DTUOpenAM/OpenVPP/CAD/Exploded_view/Outline structure.exploded.PNG

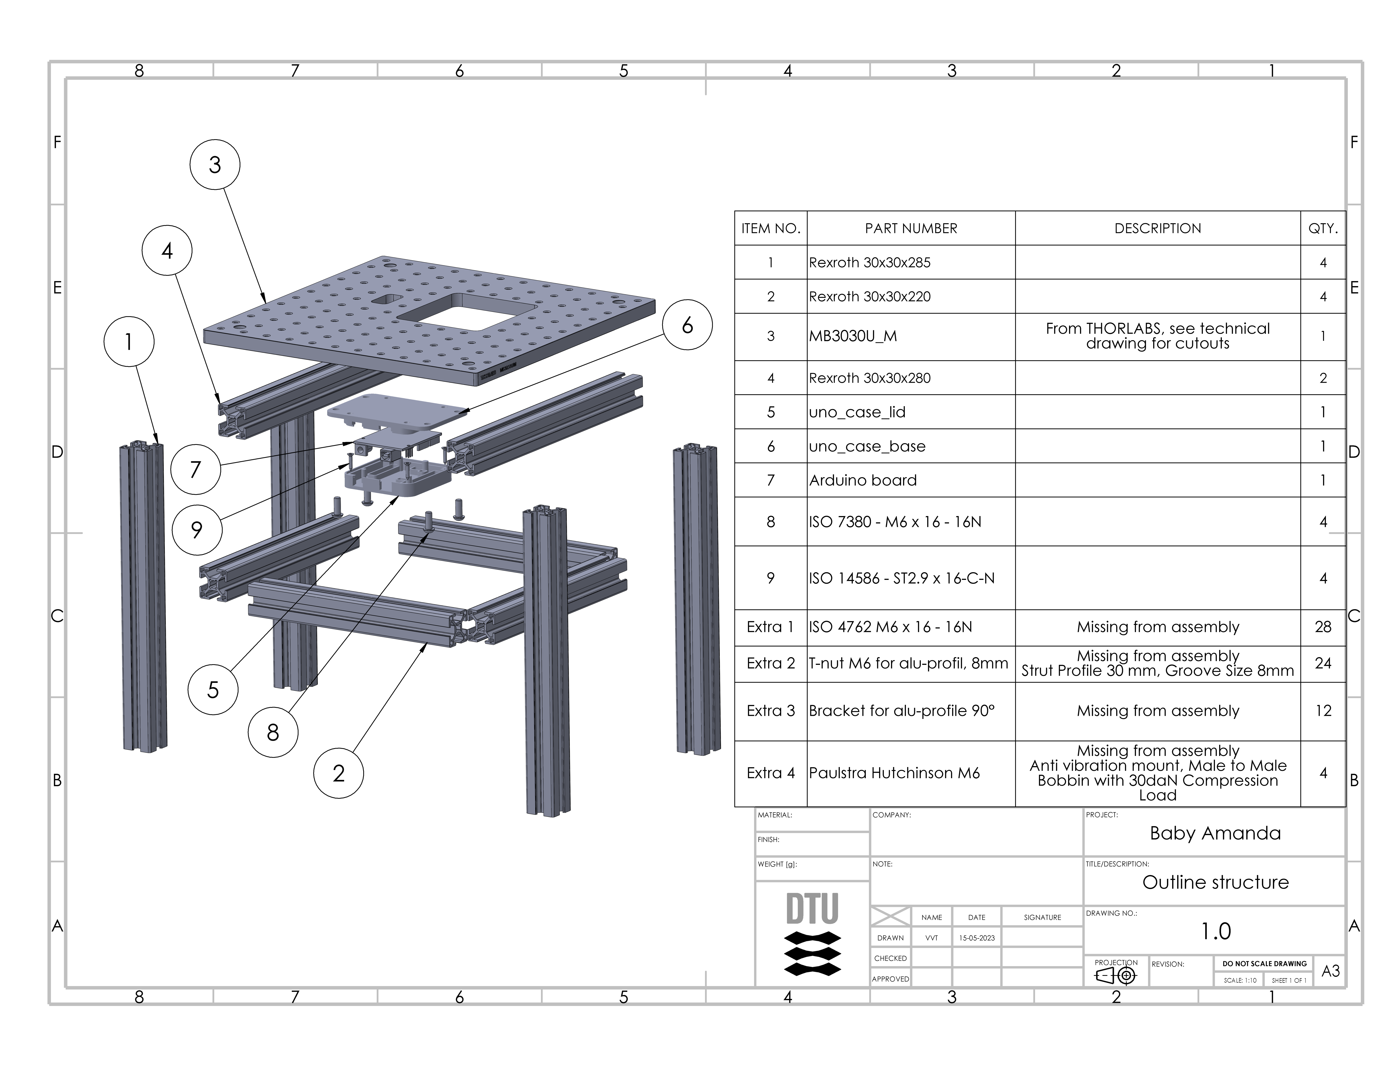
CAD/Exploded_view/Outline structure.exploded.PNG
