DTUOpenAM/OpenVPP/CAD/Exploded_view/Stage_exploded.PNG

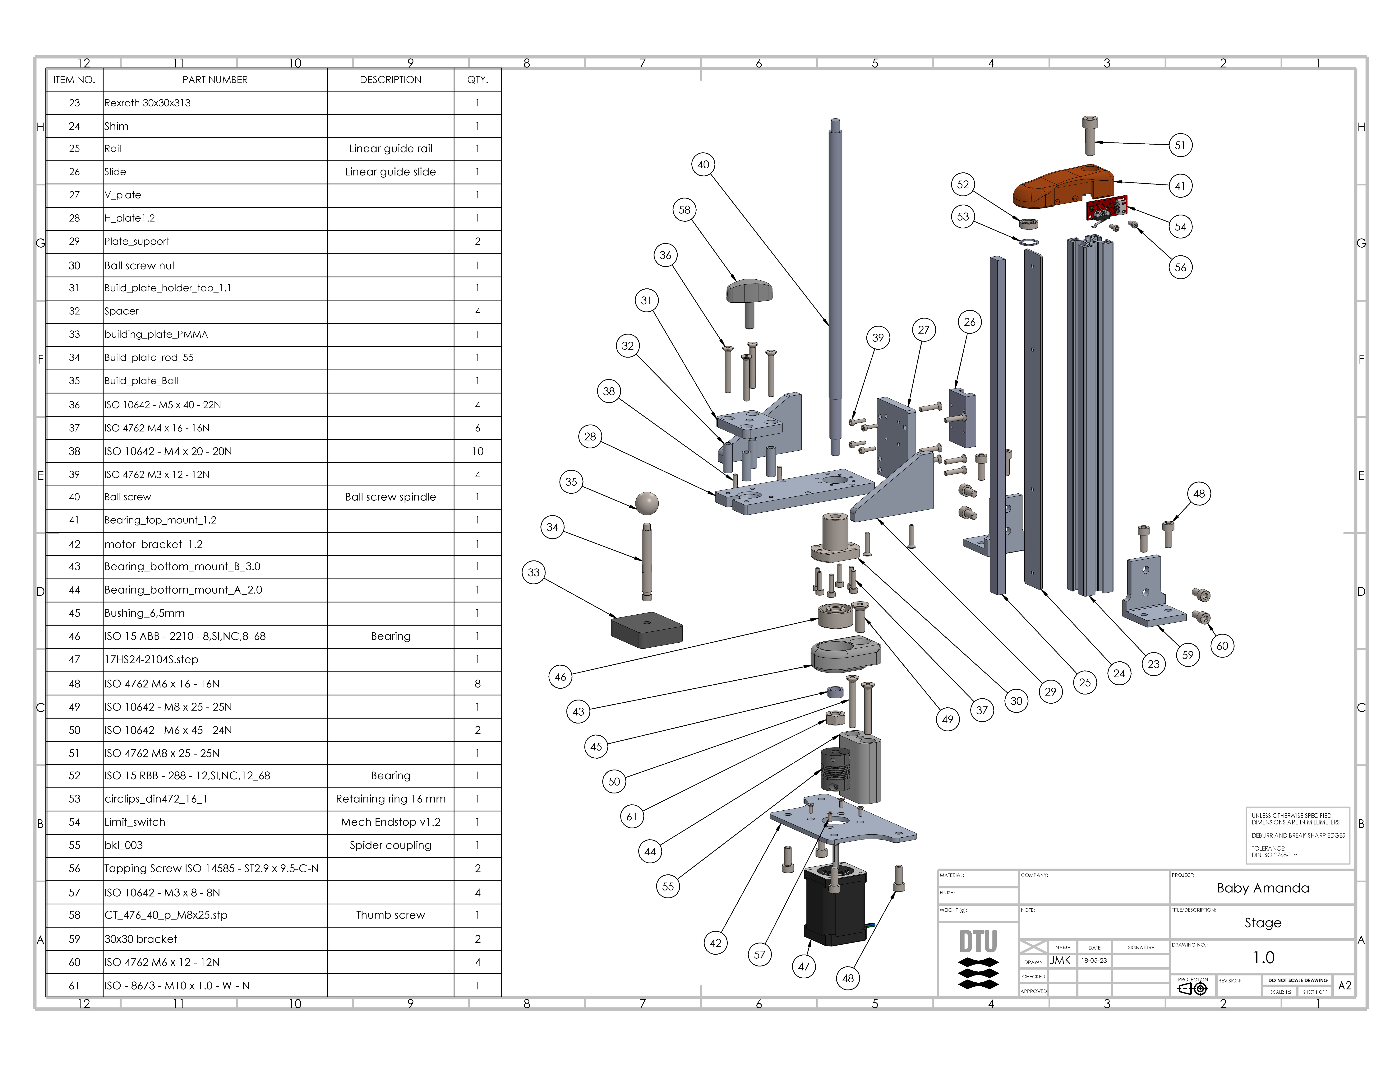
CAD/Exploded_view/Stage_exploded.PNG
