DTUOpenAM/OpenVPP/CAD/Bill_of_Materials/BOM.xlsx

ITEM NO. | Component | PART NUMBER | DESCRIPTION | QTY. | Processing | Material | Supplier
Outline structure
1 | Alu-profile 30x30 L:285 | Rexroth 30x30x285 |  | 4 | Saw |  | RS-components (https://dk.rs-online.com/web/p/ror-og-aluprofiler/4938252)
2 | Alu-profile 30x30 L:220 | Rexroth 30x30x220 |  | 4 | Saw |  | RS-components (https://dk.rs-online.com/web/p/ror-og-aluprofiler/4938252)
3 | Breadboard | MB3030U_M | See technical drawing for cutouts | 1 | Milling | Aluminium | Thorlabs (https://www.thorlabs.com/thorproduct.cfm?partnumber=MB3030U/M)
4 | Alu-profile 30x30 L:280 | Rexroth 30x30x280 |  | 2 | Saw |  | RS-components (https://dk.rs-online.com/web/p/ror-og-aluprofiler/4938252)
5 | Arduino case lid | uno_case_lid |  | 1 | 3D-printing | PLA
6 | Arduino case base | uno_case_base |  | 1 | 3D-printing | PLA
7 | Arduino UNO | Arduino board |  | 1
8 | Botton head bolt | ISO 7380 - M6 x 16 - 16N |  | 4
9 | Self tapping screw | ISO 14586 - ST2.9 x 16-C-N |  | 4
Extra 1 |  | ISO 4762 M6 x 16 - 16N | Missing from assembly | 28
Extra 2 |  | T-nut M6 for alu-profile, 8mm | Missing from assembly Strut Profile 30 mm, Groove Size 8mm | 24
Extra 3 |  | Bracket for alu-profile 90° | Missing from assembly | 12 |  | Steel
Extra 4 |  | Paulstra Hutchinson M6 | Missing from assembly Anti vibration mount, Male to Male Bobbin with 30daN Compression Load | 4
Vat
10 | Base vat | baseVAT1.2 |  | 1 | Milling | Aluminium
11 | Glass pane | Glass |  | 1 | Water cutting | Glass
12 | Vat bracket | Vat_bracket_1.1 |  | 1 | Milling | Aluminium
13 | Vat bottom | Vat_bottom |  | 1 | Milling | Aluminium
14 | Membrane stretcher | Membrane_stretcher |  | 1 | Milling | Aluminium
15 | Vat top | Vat_top |  | 1 | Milling | Aluminium
16 | Fastening ring for O-ring | spændeskive-laser |  | 1 | Lasercutting | Acrylic
17 | Unbrako bolt | ISO 4762 M3 x 12 - 12N |  | 2
18 | Unbrako bolt | ISO 4762 M4 x 8 - 8N |  | 4
19 | Unbrako bolt | ISO 4762 M6 x 25 - 25N |  | 4
20 | Unbrako bolt | ISO 4762 M3 x 5 - 5N |  | 3
21 | Quater Turn Lock | qcth0834-20-sus | Quater Turn Lock from IMAO | 1 |  |  | IMAO (https://l.messenger.com/l.php)
22 | Unbrako countersunk bolt | ISO 10642 - M3 x 12 - 12N |  | 4
Extra 5 | M3 x 8 thumbscrews |  | Missing from assembly, for Vat_top | 4
Extra 6 | CAM receptable QCTH-N |  | Missing from assembly, counterpart to quater turn lock | 1
Extra 7 | O-ring, nitrile, d:1.5mm |  | Missing from assembly | 1
Stage
23 | Alu-profile 30x30 L:313 | Rexroth 30x30x313 |  | 1 | Saw |  | RS-components (https://dk.rs-online.com/web/p/ror-og-aluprofiler/4938252)
24 | Linear guide shim | Shim |  | 1 |  | Aluminium
25 | Linear guide rail | Rail | Simple drawing with essential dimensions | 1 |  |  | RS-components (https://dk.rs-online.com/web/p/lineaere-styreskinner/4885041)
26 | Linear guide slide | Slide | Simple drawing with essential dimensions | 1 |  |  | RS-components
27 | V plate | V_plate |  | 1 | Milling | Aluminium
28 | H plate | H_plate1.2 |  | 1 | Milling | Aluminium
29 | Plate support | Plate_support |  | 2 | Milling | Aluminium
30 | Ball screw nut | Ball screw nut | SFU1604 300 mm, simple drawing with essential dimensions | 1 |  |  | Aliexpress (https://www.aliexpress.com/item/4001041082641.html)
31 | Build plate holder top | Build_plate_holder_top_1.1 |  | 1 | Milling | Aluminium
32 | Spacer | Spacer |  | 4 | Lathe | Aluminium
33 | Build plate | building_plate_PMMA |  | 1 | Milling | Aluminium
34 | Build plate rod | Build_plate_rod_55 |  | 1 | Lathe | Steel
35 | Build plate ball | Build_plate_Ball |  | 1 |  | Stainless steel | KJV (https://www.kjv.dk/katalog/transmission/lejer/leje_tilbehor/kugle/45rbs20)
36 | Unbrako countersunk bolt | ISO 10642 - M5 x 40 - 22N |  | 4
37 | Unbrako bolt | ISO 4762 M4 x 16 - 16N |  | 6
38 | Unbrako countersunk bolt | ISO 10642 - M4 x 20 - 20N |  | 10
39 | Unbrako bolt | ISO 4762 M3 x 12 - 12N |  | 4
40 | Ball screw spindle | Ball screw | SFU1604 300 mm, simple drawing with essential dimensions | 1 |  |  | Aliexpress (https://www.aliexpress.com/item/4001041082641.html)
41 | Bearing mount top | Bearing_top_mount_1.2 |  | 1 | 3D-printing | PLA
42 | Motor bracket | motor_bracket_1.2 |  | 1 | Milling | Aluminium
43 | Bearing bottom mount B | Bearing_bottom_mount_B_3.0 |  | 1 | 3D-printing | PLA
44 | Bearing bottom mount A | Bearing_bottom_mount_A_2.0 |  | 1 | 3D-printing | PLA
45 | Bearing mount bushing | Bushing_6,5mm |  | 1 | 3D-printing | PLA
46 | Angular ball bearing | ISO 15 ABB - 2210 - 8,SI,NC,8_68 |  | 1 |  |  | RS-components (https://dk.rs-online.com/web/p/kuglelejer/2058772)
47 | Nema 17 stepper motor | 17HM15-0904S |  | 1 |  |  | Stepperonline (https://www.omc-stepperonline.com/nema-17-bipolar-1-8deg-65ncm-92oz-in-2-1a-3-36v-42x42x60mm-4-wires-17hs24-2104s)
48 | Unbrako bolt | ISO 4762 M6 x 16 - 16N |  | 8
49 | Unbrako countersunk bolt | ISO 10642 - M8 x 25 - 25N |  | 1
50 | Unbrako countersunk bolt | ISO 10642 - M6 x 45 - 24N |  | 2
51 | Unbrako bolt | ISO 4762 M8 x 25 - 25N |  | 1
52 | Radial ball bearing | ISO 15 RBB - 288 - 12,SI,NC,12_68 |  | 1 |  |  | Billiglejer.dk (https://billiglejer.dk/da/600-serien/388-sporkugleleje-688-zz.html)
53 | Retaining ring 16 mm | circlips_din472_16_1 |  | 1 |  |  | Kramp (https://www.kramp.com/shop-dk/da/p/l%C3%A5sering-indvendig-16-x-1-00-mm-din-472--47216)
54 | Mech Endstop v1.2 | Limit_switch |  | 1
55 | Spider Coupling | bkl_003 | Not the same in assembly as the physical coupling | 1 |  |  | Amazon (https://www.amazon.com/VXB-D20-L25-Flexible-Coupling-Diameter/dp/B078X2HYQ1?s=industrial)
56 | Self tapping screw | Tapping Screw ISO 14585 - ST2.9 x 9.5-C-N |  | 2
57 | Unbrako countersunk bolt | ISO 10642 - M3 x 8 - 8N |  | 4
58 | Thumb screw | CT_476_40_p_M8x25.stp |  | 1
59 | 30x30 bracket | 30x30 bracket |  | 2 | Milling | Steel
60 | Unbrako bolt | ISO 4762 M6 x 12 - 12N |  | 4
61 | Fine threaded nut | ISO - 8673 - M10 x 1.0 - W - N | Missing on the printer | 1 |  |  | thansen (https://www.thansen.dk/vaerktoj/bolte-skiver-motrikker/motrikker/motrik-10mm/motrik-10-mm-x-1/n-243297090/pn1387909807/)
Extra 8 | Stepper driver | DM320T | Missing from assembly |  |  |  | Stepperonline (https://www.omc-stepperonline.com/digital-stepper-driver-0-3-2-2a-10-30vdc-for-nema-8-11-14-16-17-stepper-motor-dm320t)
Projector
62 | Projector base bottom | Projector_BASE_Bottom |  | 1 | Milling | Aluminium
63 | Adjusting screw | M6x0.25 Differential screw | Tap M6x0.25 is bought from Thorlabs (TAPM6025) (https://www.thorlabs.com/newgrouppage9.cfm?objectgroup_id=1189) | 3 |  |  | Thorlabs (https://www.thorlabs.com/thorproduct.cfm?partnumber=DAS6M)
64 | DLP-Lightcrafter 4500 | PRO4500_STP_20150716 | Projector | 1 |  |  | Wintech Digitals (https://www.wintechdigital.com/PRO4500)
65 | Projector sandwich | Projector_sandwich |  | 1 | Milling | Aluminium
66 | Projector bracket | Projector_bracket |  | 1 | Milling | Aluminium
67 | Projector bracket support | Projector_bracket_support |  | 1 | Milling | Aluminium
68 | Projector base top | Projector_BASE_Top |  | 1 | Milling | Aluminium
69 | Unbrako countersunk bolt | ISO 10642 - M4 x 16 - 16N |  | 8
70 | Unbrako countersunk bolt | ISO 10642 - M4 x 12 - 12N |  | 6
71 | Unbrako countersunk bolt | ISO 10642 - M3 x 16 - 16N |  | 4
72 | Unbrako bolt | ISO 4762 M6 x 16 - 16N |  | 8
72 | Botton head bolt | ISO 7380 - M3 x 12 - 12N |  | 6
74 | Pull spring | Pull Spring E01800220620S |  | 3 |  |  | SODEMANN (https://www.fjedre.dk/e01800220620s)
75 | Linear stage | Linear stage roller | SEMX60-AC X | 1 |  |  | Amazon (https://www.amazon.de/-/en/SEMX60-AC-Adjustment-Platform-Trimming-Precision/dp/B07QL5S9BD)
76 | Linear stage micrometer | Micrometer screw | Included in SEMX60-AC X (Item no. 75) | 1
77 | Unbrako bolt | ISO 4762 M4 x 12 - 12N |  | 4
