DTUOpenAM/OpenVPP/CAD/Solidworks/Arduino Case/Arduino_case_assem-Jens.SLDASM

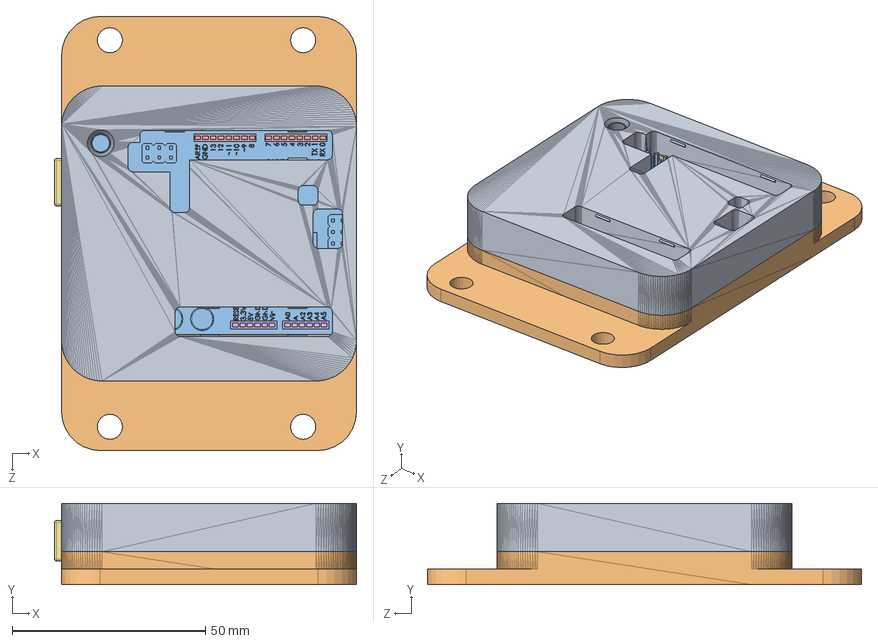
[picture p3: CAD file, 2024-10-09]
CAD/Solidworks/Arduino Case/Arduino_case_assem-Jens.SLDASM
78.1 x 21.0 x 112.3 mm
uno_case_lid
uno_case_base
Arduino board
Jack Socket
pin x 2
pin2 x 2
USB socket
hex socket head screws_iso x 4
