DTUOpenAM/OpenVPP/CAD/Solidworks/Large assemblies/Stage_total_assembly.SLDASM

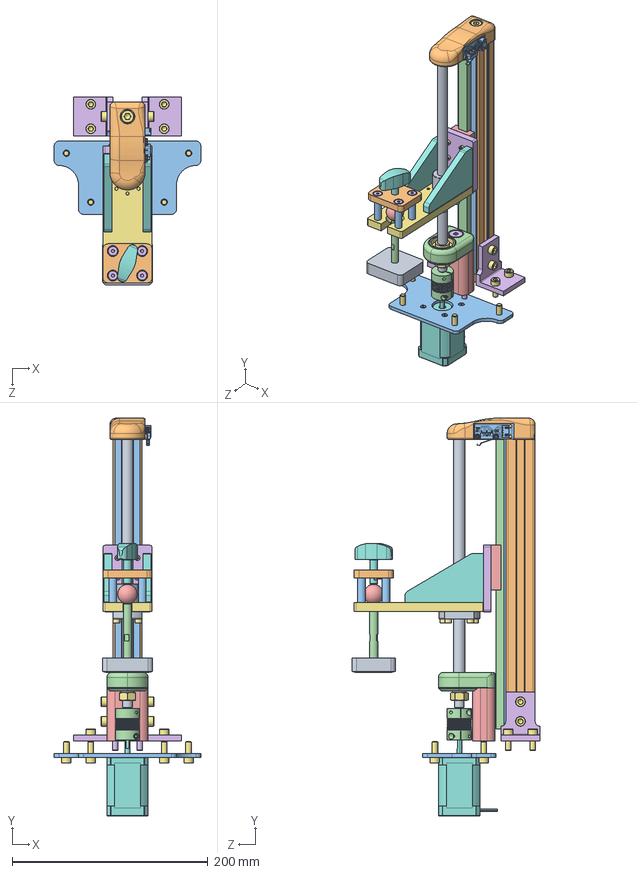
[picture p4: CAD file, 2024-10-09]
CAD/Solidworks/Large assemblies/Stage_total_assembly.SLDASM
150.0 x 406.7 x 192.2 mm
Rexroth 30x30x313
Shim
Rail
Slide
V_plate
H_plate1.2
Plate_support x 2
Ball screw nut
Build_plate_holder_top_1.1
Spacer x 4
building_plate_PMMA
Build_plate_rod_55
Build_plate_Ball
socket countersunk head screw_iso x 21
socket head cap screw_iso x 23
CT_476_40_p_M8x25.stp
Ball screw
Bearing_top_mount_1.2
motor_bracket_1.2
Bearing_bottom_mount_B_3.0
Bearing_bottom_mount_A_3.0
Bushing_6,5mm
angular contact ball bearing_68_iso
17HS24-2104S
radial ball bearing_68_iso
circlips_din472_16_1
Limit_switch
bkl_003
hex tapping screws_iso x 2
30x30 bracket x 2
hex nut style 1 fine gradeab_iso
