DTUOpenAM/OpenVPP/CAD/Solidworks/Large assemblies/Projector_assembly.SLDASM

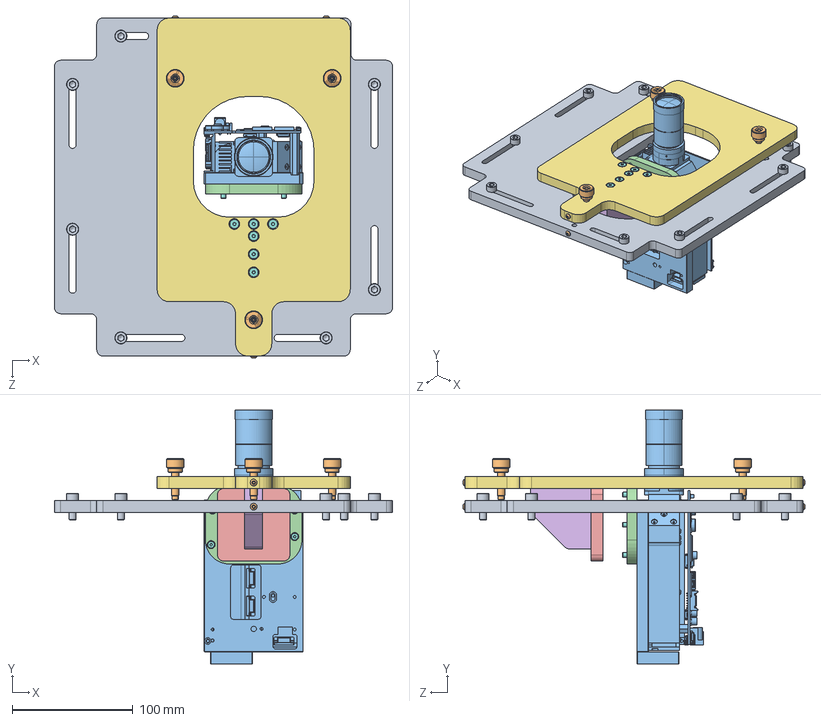
[picture p5: CAD file, 2024-10-09]
CAD/Solidworks/Large assemblies/Projector_assembly.SLDASM
280.0 x 210.3 x 283.3 mm
Projector_BASE_Bottom
DAS6M-Solidworks x 3
PRO4500_STP_20150716
Projector_sandwich
Projector_bracket
Projector_bracket_support
Projector_BASE_Top
socket countersunk head screw_iso x 18
socket head cap screw_iso x 8
socket button head screw_iso x 6
