DTUOpenAM/OpenVPP/CAD/Solidworks/Projector/Projector_brackets_assembly.SLDASM

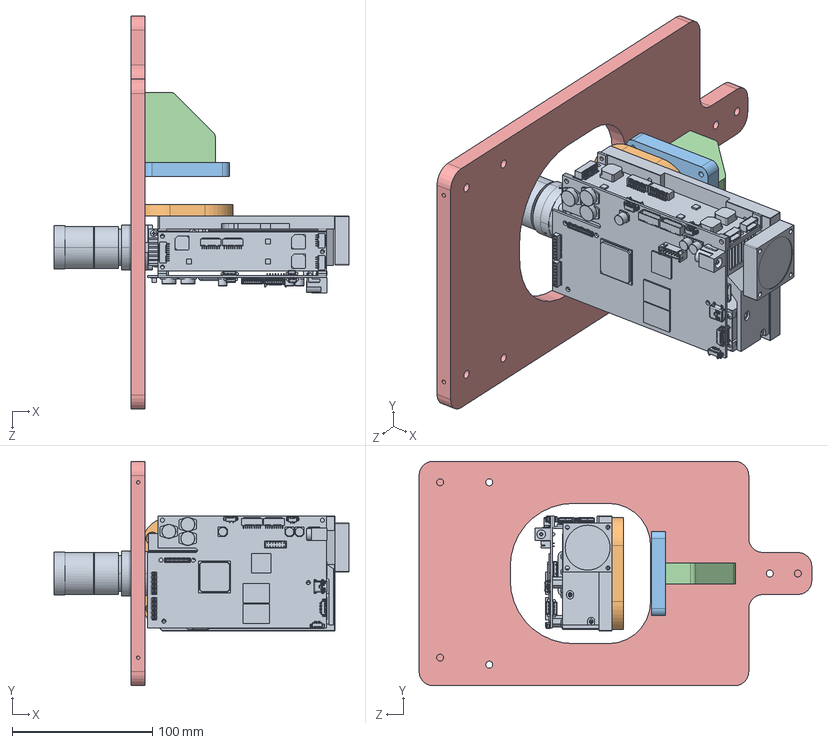
[picture p6: CAD file, 2024-10-09]
CAD/Solidworks/Projector/Projector_brackets_assembly.SLDASM
210.3 x 160.0 x 280.0 mm
PRO4500_STP_20150716
Projector_sandwich
Projector_bracket
Projector_bracket_support
Projector_BASE_Top
