DTUOpenAM/OpenVPP/CAD/Solidworks/Stage/Build plate/Build_plate.SLDASM

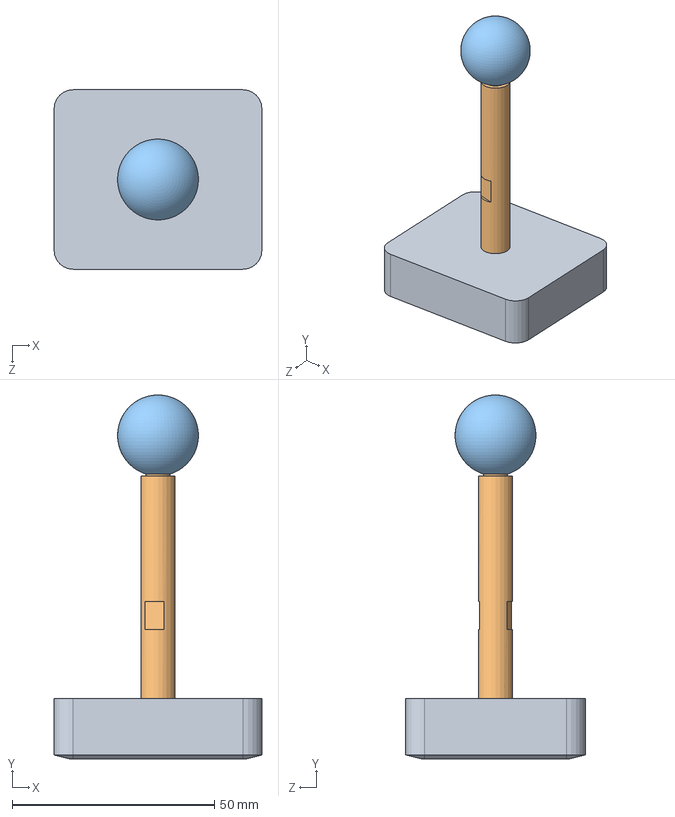
[picture p7: CAD file, 2024-10-09]
CAD/Solidworks/Stage/Build plate/Build_plate.SLDASM
51.4 x 90.0 x 44.4 mm
building_plate_PMMA
Build_plate_rod_55
Build_plate_Ball
