DTUOpenAM/OpenVPP/CAD/Solidworks/Stage/Stage_head.SLDASM

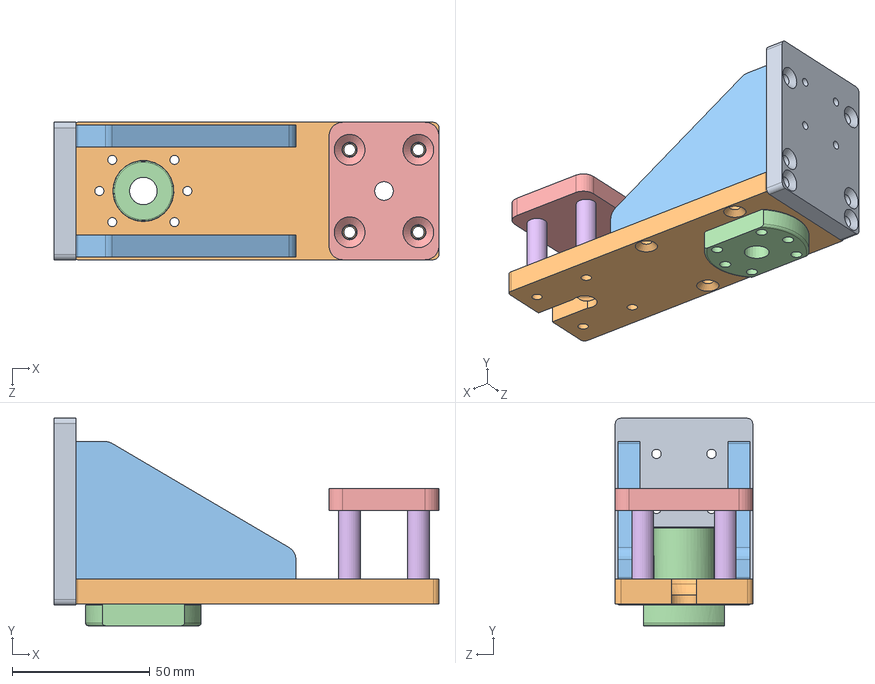
[picture p8: CAD file, 2024-10-09]
CAD/Solidworks/Stage/Stage_head.SLDASM
140.0 x 75.5 x 50.0 mm
V_plate
H_plate1.2
Plate_support x 2
Ball screw nut
Build_plate_holder_top_1.1
Spacer x 4
