DTUOpenAM/OpenVPP/CAD/Solidworks/Standard components/Quater turn lock IMAO/qcth0834-20-sus_solidworks/qcth0834-20-sus.sldasm

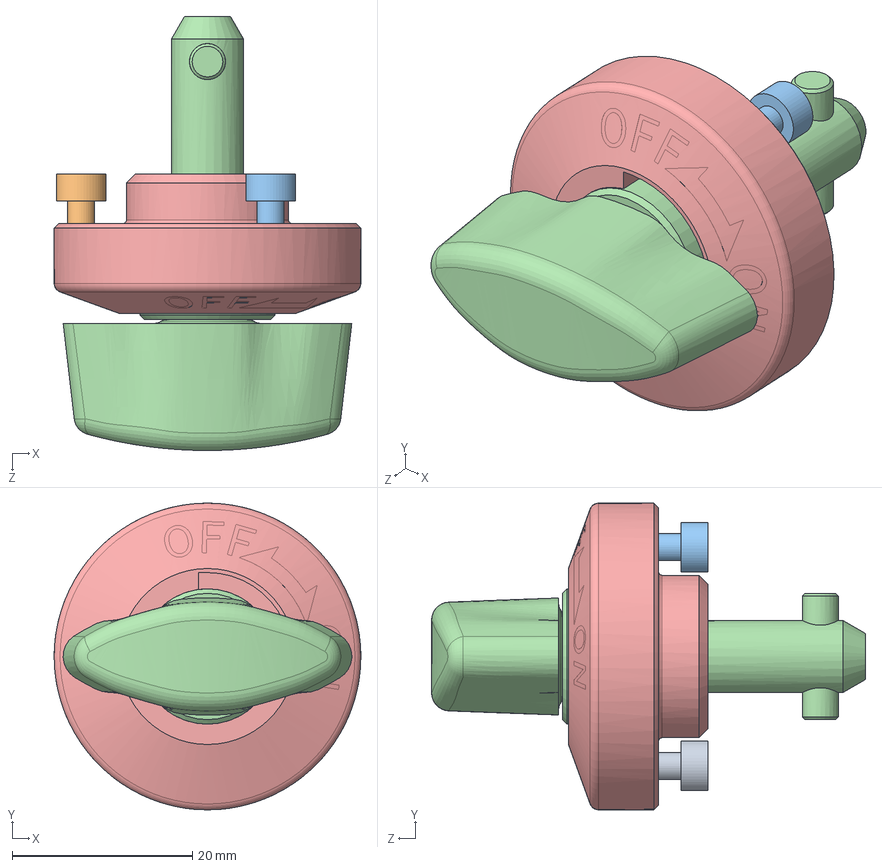
[picture p9: CAD file, 2024-10-09]
CAD/Solidworks/Standard components/Quater turn lock IMAO/qcth0834-20-sus_solidworks/qcth0834-20-sus.sldasm
34.0 x 34.0 x 48.1 mm
qcth0834-20-sus_01
qcth0834-20-sus_02
qcth0834-20-sus_03
qcth0834-20-sus_04
qcth0834-20-sus_05
