DTUOpenAM/OpenVPP/CAD/Solidworks/Arduino Case/Arduino R3 UNO/uno.SLDASM

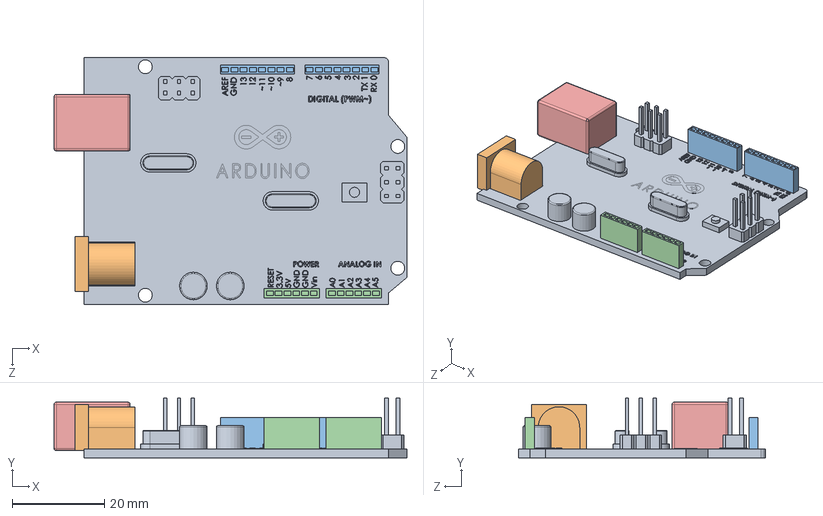
[picture p10: CAD file, 2024-10-09]
CAD/Solidworks/Arduino Case/Arduino R3 UNO/uno.SLDASM
76.5 x 13.0 x 53.5 mm
Arduino board
Jack Socket
pin x 2
pin2 x 2
USB socket
