DTUOpenAM/OpenVPP/CAD/Solidworks/Arduino Case/Arduino R3 UNO/IC.SLDASM

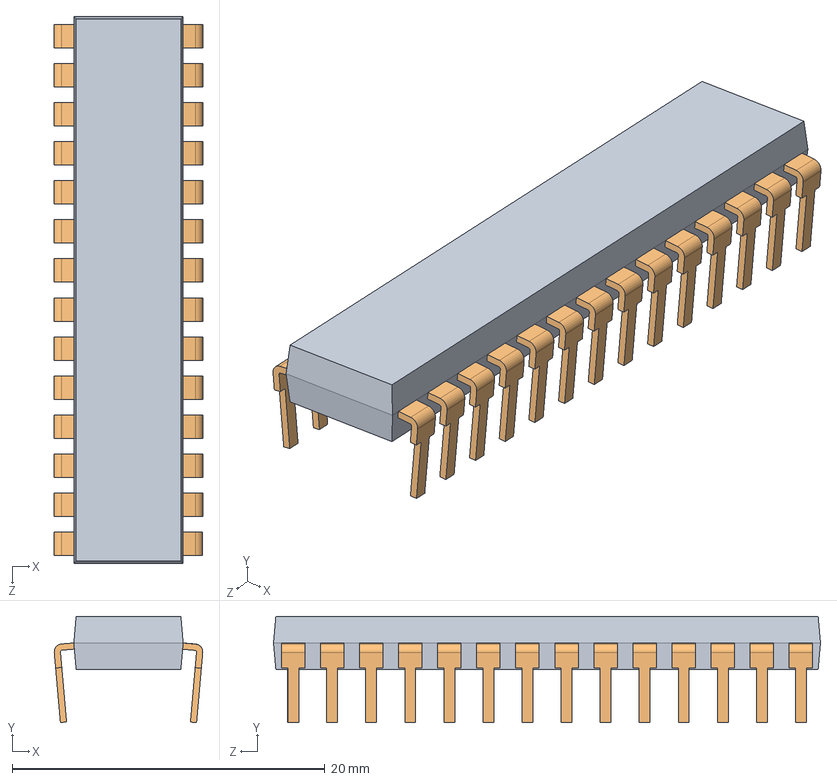
[picture p11: CAD file, 2024-10-09]
CAD/Solidworks/Arduino Case/Arduino R3 UNO/IC.SLDASM
9.50 x 6.80 x 35.0 mm
IC body
IC pin x 28
