DTUOpenAM/OpenVPP/CAD/Solidworks/Stage/Stage_assembly.SLDASM

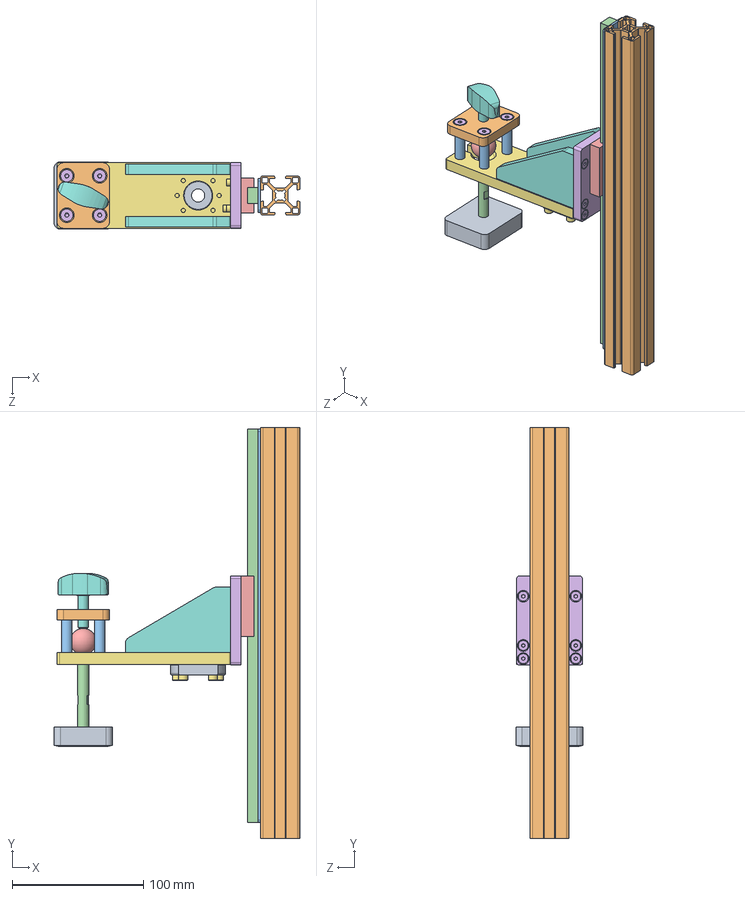
[picture p12: CAD file, 2024-10-09]
CAD/Solidworks/Stage/Stage_assembly.SLDASM
187.2 x 313.0 x 51.4 mm
Rexroth 30x30x313
Shim
Rail
Slide
V_plate
H_plate1.2
Plate_support x 2
Ball screw nut
Build_plate_holder_top_1.1
Spacer x 4
building_plate_PMMA
Build_plate_rod_55
Build_plate_Ball
socket countersunk head screw_iso x 14
socket head cap screw_iso x 10
CT_476_40_p_M8x25.stp
