DTUOpenAM/OpenVPP/CAD/Solidworks/Arduino Case/Arduino R3 UNO/IC socket.SLDPRT

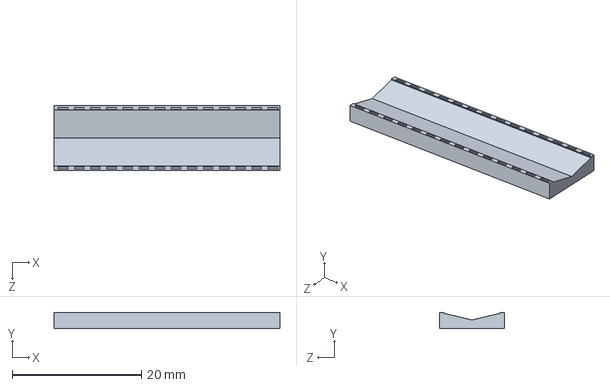
[picture p13: CAD file, 2024-10-09]
CAD/Solidworks/Arduino Case/Arduino R3 UNO/IC socket.SLDPRT
35.0 x 2.50 x 10.0 mm
