DTUOpenAM/OpenVPP/CAD/Solidworks/Arduino Case/STL/uno_case_lid.stl

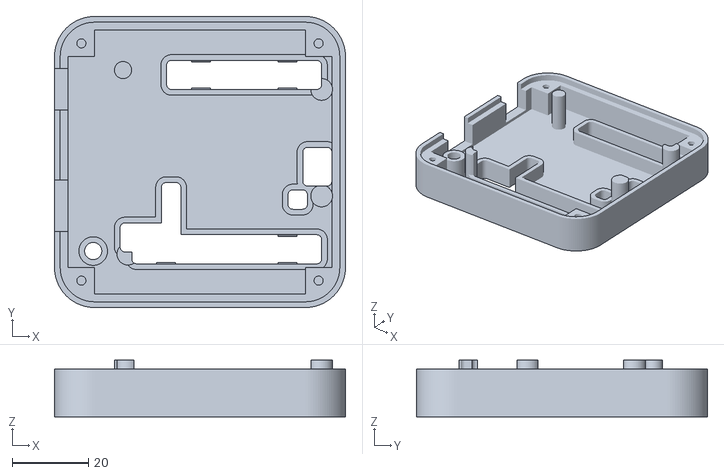
[picture p14: CAD file, 2024-10-09]
CAD/Solidworks/Arduino Case/STL/uno_case_lid.stl
76.3 x 76.3 x 14.9
