DTUOpenAM/OpenVPP/CAD/Solidworks/Projector/Projector_BASE_Top.SLDPRT

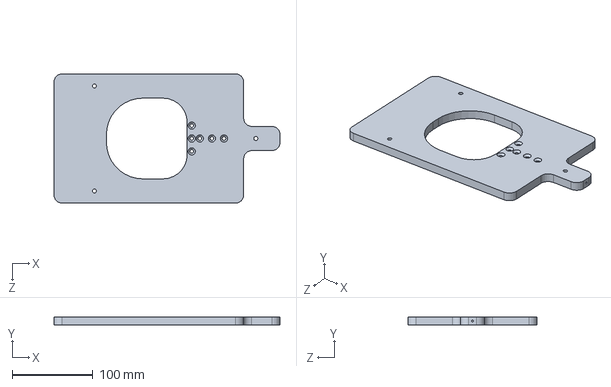
[picture p15: CAD file, 2024-10-09]
CAD/Solidworks/Projector/Projector_BASE_Top.SLDPRT
280.0 x 10.0 x 160.0 mm
