DTUOpenAM/OpenVPP/CAD/Solidworks/Stage/Build plate/Build_plate_rod_55.SLDPRT

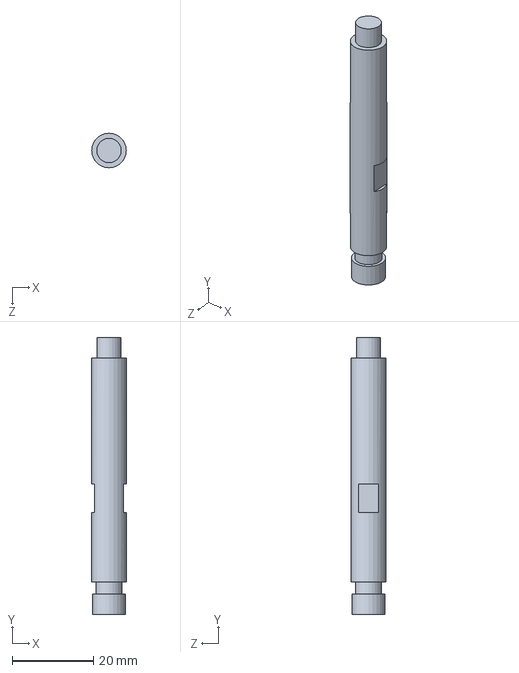
[picture p16: CAD file, 2024-10-09]
CAD/Solidworks/Stage/Build plate/Build_plate_rod_55.SLDPRT
8.50 x 68.0 x 8.50 mm
