DTUOpenAM/OpenVPP/CAD/Solidworks/Stage/Spacer.SLDPRT

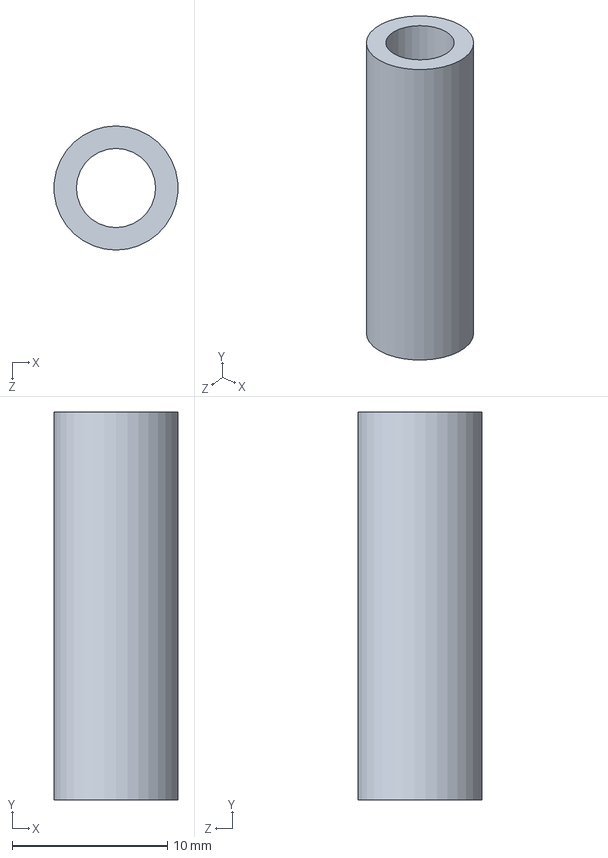
[picture p17: CAD file, 2024-10-09]
CAD/Solidworks/Stage/Spacer.SLDPRT
7.97 x 25.0 x 8.00 mm
