DTUOpenAM/OpenVPP/CAD/Solidworks/Standard components/Alu profiles/Rexroth 30x30x285.SLDPRT

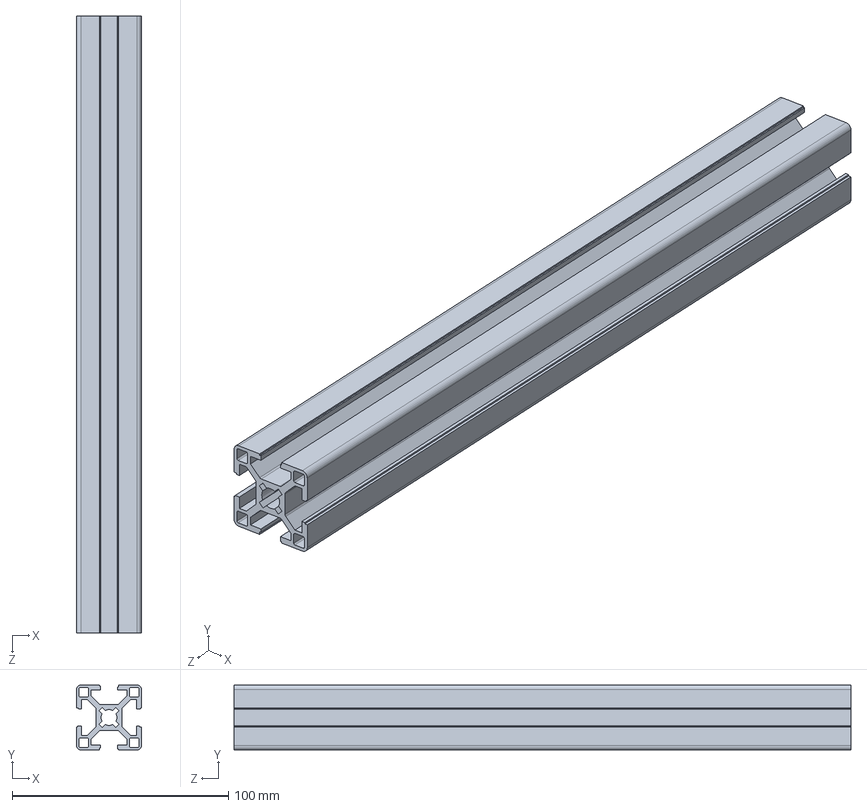
[picture p18: CAD file, 2024-10-09]
CAD/Solidworks/Standard components/Alu profiles/Rexroth 30x30x285.SLDPRT
30.0 x 30.0 x 285.0 mm
