DTUOpenAM/OpenVPP/CAD/Solidworks/Standard components/Quater turn lock IMAO/qcth0834-20-sus_solidworks/qcth0834-20-sus_03.sldprt

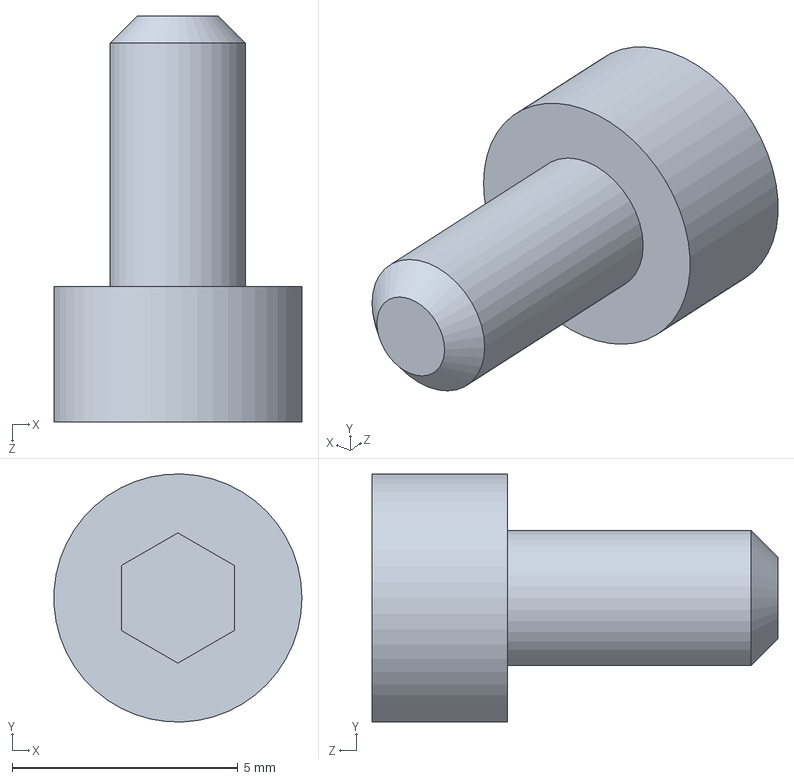
[picture p19: CAD file, 2024-10-09]
CAD/Solidworks/Standard components/Quater turn lock IMAO/qcth0834-20-sus_solidworks/qcth0834-20-sus_03.sldprt
5.49 x 5.50 x 9.00 mm
