DTUOpenAM/OpenVPP/CAD/Solidworks/Standard components/Slide.SLDPRT

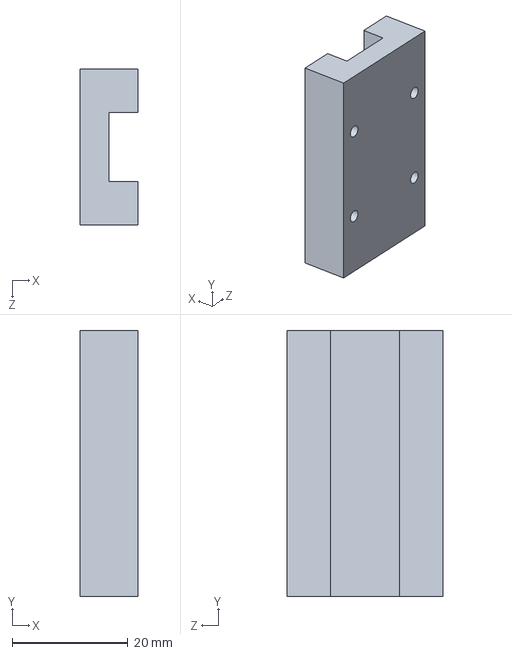
[picture p20: CAD file, 2024-10-09]
CAD/Solidworks/Standard components/Slide.SLDPRT
10.0 x 46.0 x 27.0 mm
