DTUOpenAM/OpenVPP/CAD/Solidworks/Vat/Vat_bottom.SLDPRT

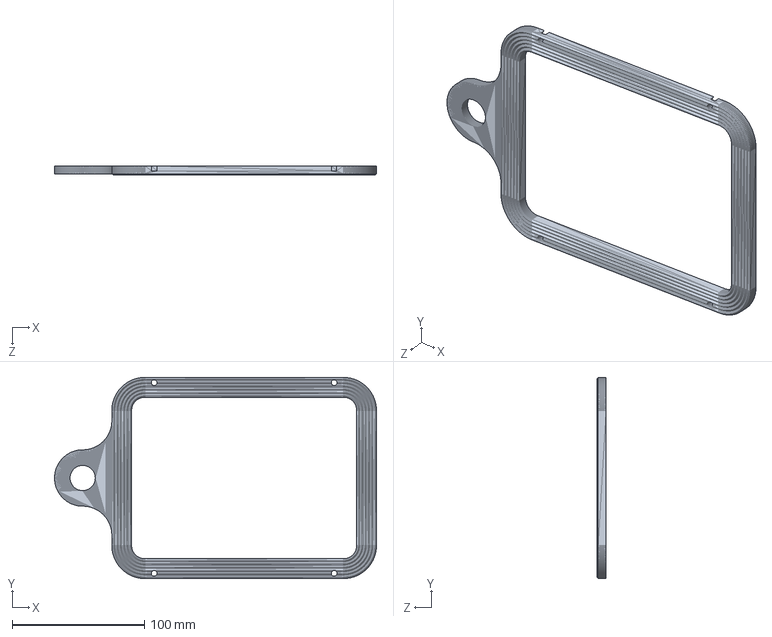
[picture p21: CAD file, 2024-10-09]
CAD/Solidworks/Vat/Vat_bottom.SLDPRT
243.3 x 152.0 x 7.00 mm
