DTUOpenAM/OpenVPP/CAD/Solidworks/Arduino Case/Arduino R3 UNO/USB socket.SLDPRT

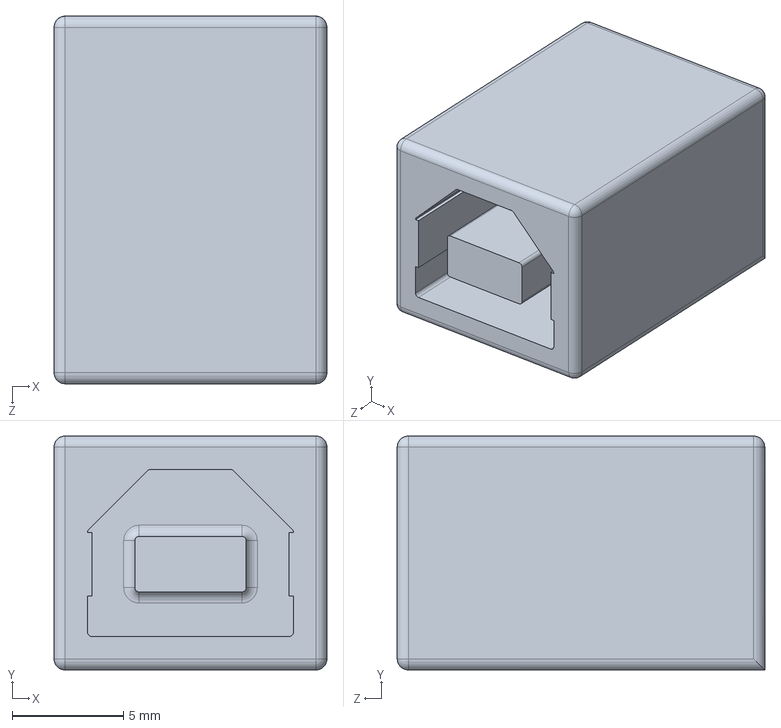
[picture p22: CAD file, 2024-10-09]
CAD/Solidworks/Arduino Case/Arduino R3 UNO/USB socket.SLDPRT
12.2 x 10.5 x 16.5 mm
