DTUOpenAM/OpenVPP/CAD/Solidworks/Arduino Case/STL/reset_button.stl

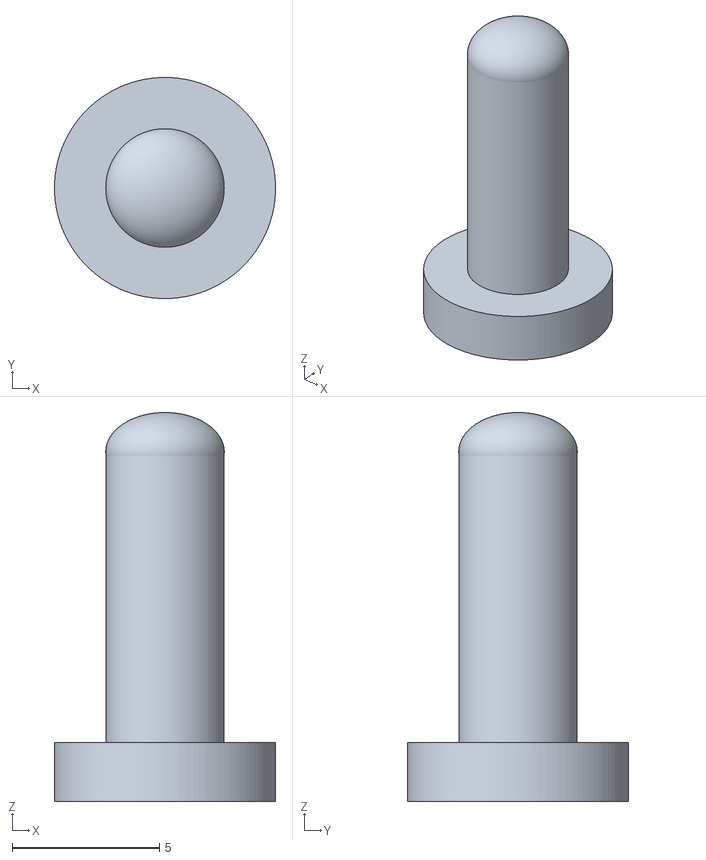
[picture p23: CAD file, 2024-10-09]
CAD/Solidworks/Arduino Case/STL/reset_button.stl
7.50 x 7.50 x 13.2
