DTUOpenAM/OpenVPP/CAD/Solidworks/Projector/DAS6M-Solidworks.sldprt

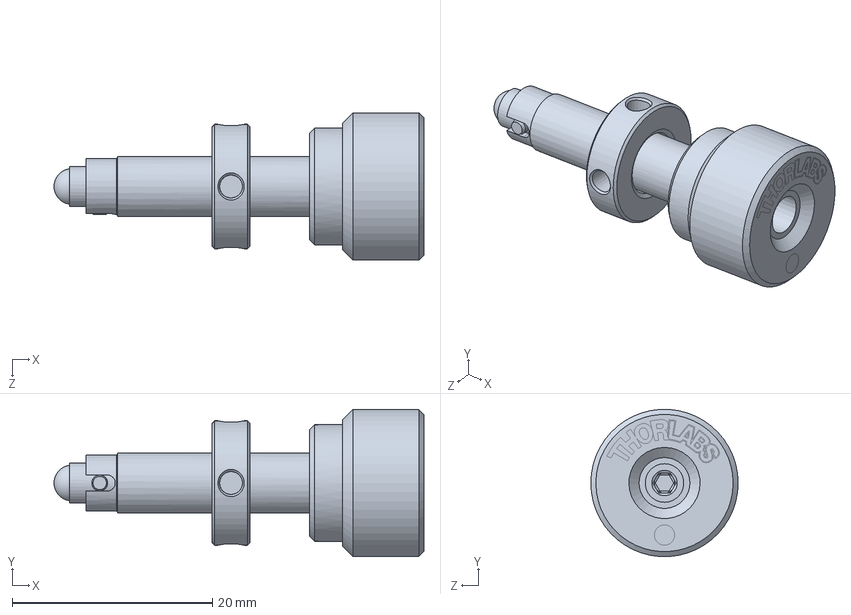
[picture p24: CAD file, 2024-10-09]
CAD/Solidworks/Projector/DAS6M-Solidworks.sldprt
37.0 x 14.7 x 14.7 mm
