DTUOpenAM/OpenVPP/CAD/Solidworks/Stage/Bearing_top_mount_1.2.SLDPRT

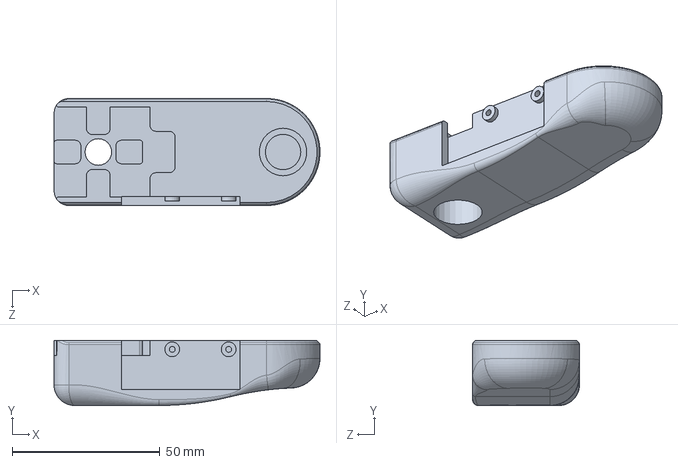
[picture p25: CAD file, 2024-10-09]
CAD/Solidworks/Stage/Bearing_top_mount_1.2.SLDPRT
90.0 x 22.0 x 36.2 mm
