DTUOpenAM/OpenVPP/CAD/Solidworks/Stage/Build plate/Build_plate_Ball.SLDPRT

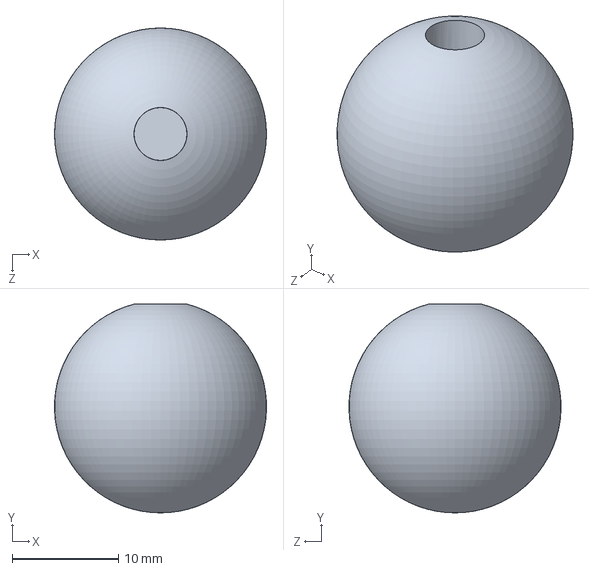
[picture p26: CAD file, 2024-10-09]
CAD/Solidworks/Stage/Build plate/Build_plate_Ball.SLDPRT
20.0 x 19.7 x 20.0 mm
