DTUOpenAM/OpenVPP/CAD/Solidworks/Standard components/Alu profiles/Rexroth 30x30x220.SLDPRT

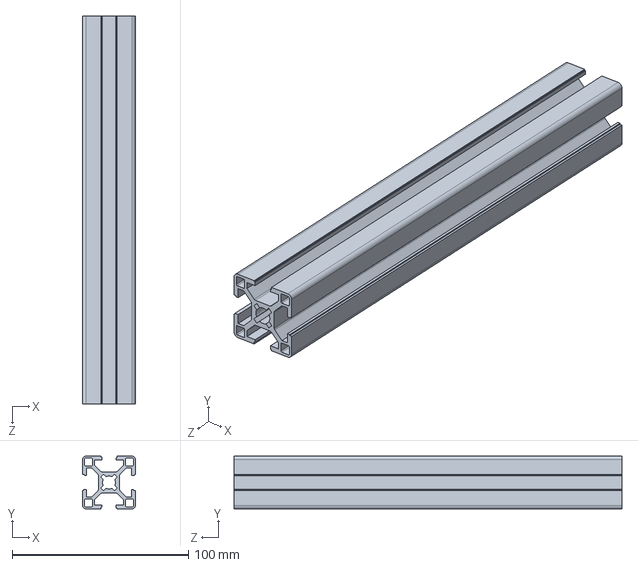
[picture p27: CAD file, 2024-10-09]
CAD/Solidworks/Standard components/Alu profiles/Rexroth 30x30x220.SLDPRT
30.0 x 30.0 x 220.0 mm
