DTUOpenAM/OpenVPP/CAD/Solidworks/Standard components/Rail.SLDPRT

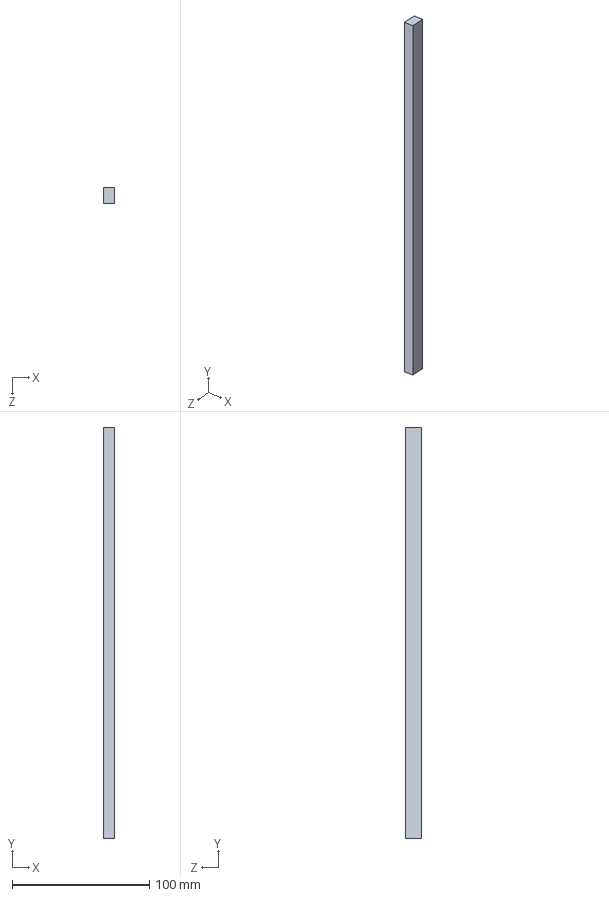
[picture p28: CAD file, 2024-10-09]
CAD/Solidworks/Standard components/Rail.SLDPRT
8.00 x 300.0 x 12.0 mm
