DTUOpenAM/OpenVPP/CAD/Solidworks/Vat/Vat_bracket_1.1.SLDPRT

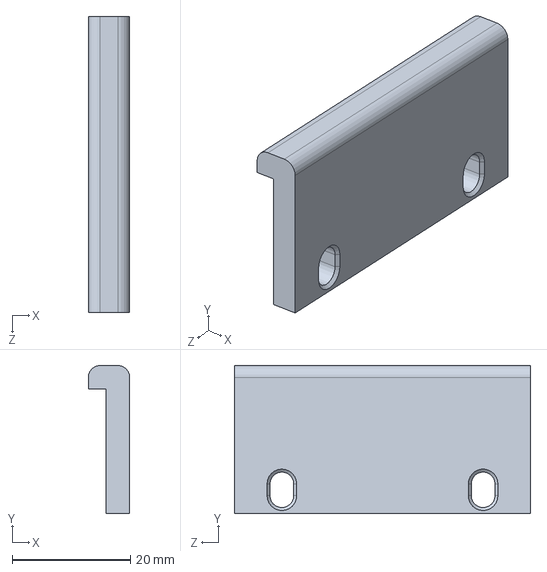
[picture p29: CAD file, 2024-10-09]
CAD/Solidworks/Vat/Vat_bracket_1.1.SLDPRT
7.00 x 25.0 x 50.0 mm
