DTUOpenAM/OpenVPP/CAD/Solidworks/Arduino Case/Arduino R3 UNO/pin2.SLDPRT

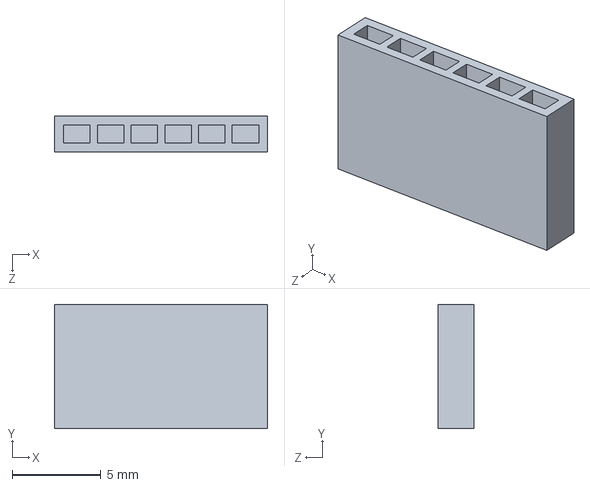
[picture p30: CAD file, 2024-10-09]
CAD/Solidworks/Arduino Case/Arduino R3 UNO/pin2.SLDPRT
12.0 x 7.00 x 2.00 mm
