DTUOpenAM/OpenVPP/CAD/Solidworks/Arduino Case/Pin cover small.SLDPRT

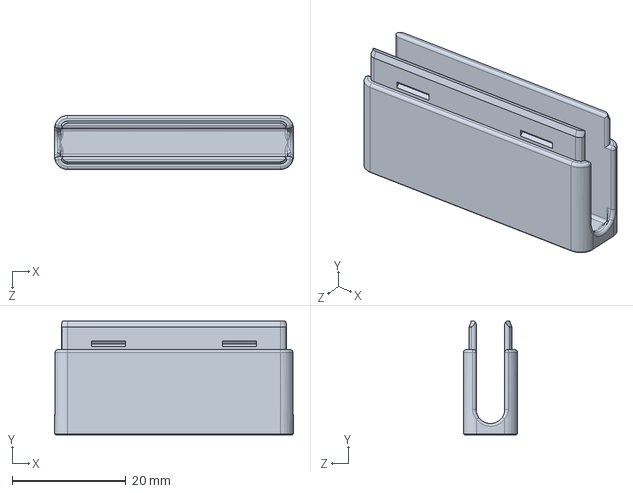
[picture p31: CAD file, 2024-10-09]
CAD/Solidworks/Arduino Case/Pin cover small.SLDPRT
42.0 x 20.0 x 9.50 mm
