DTUOpenAM/OpenVPP/CAD/Solidworks/Arduino Case/STL/uno_case_base.stl

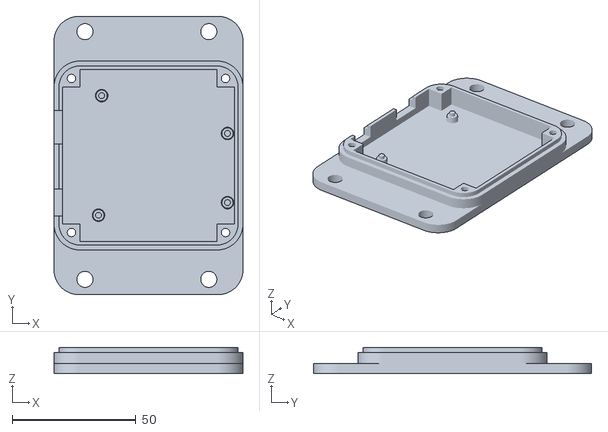
[picture p32: CAD file, 2024-10-09]
CAD/Solidworks/Arduino Case/STL/uno_case_base.stl
76.3 x 112.3 x 10.5
