DTUOpenAM/OpenVPP/CAD/Solidworks/Stage/Bearing_bottom_mount_B_3.0.SLDPRT

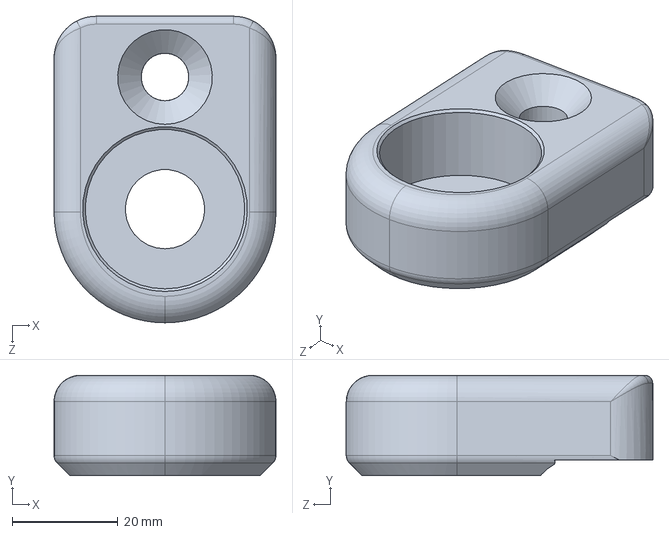
[picture p33: CAD file, 2024-10-09]
CAD/Solidworks/Stage/Bearing_bottom_mount_B_3.0.SLDPRT
42.0 x 19.0 x 58.0 mm
