DTUOpenAM/OpenVPP/CAD/Solidworks/Standard components/Alu profiles/Rexroth 30x30x313.SLDPRT

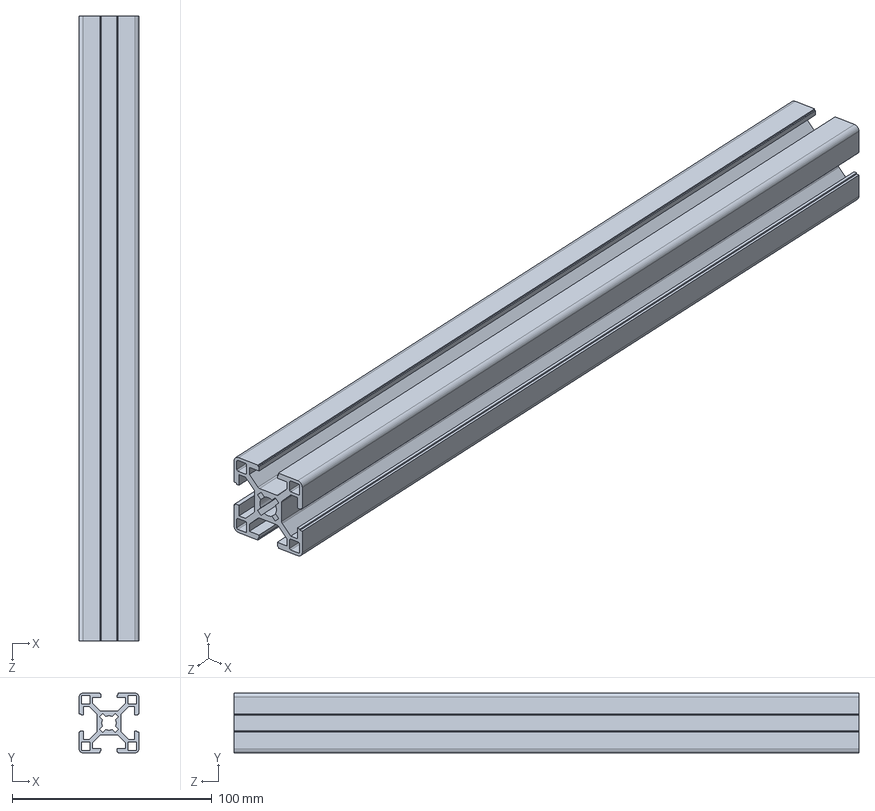
[picture p34: CAD file, 2024-10-09]
CAD/Solidworks/Standard components/Alu profiles/Rexroth 30x30x313.SLDPRT
30.0 x 30.0 x 313.0 mm
