DTUOpenAM/OpenVPP/CAD/Solidworks/Standard components/circlips_din472_16_1.SLDPRT

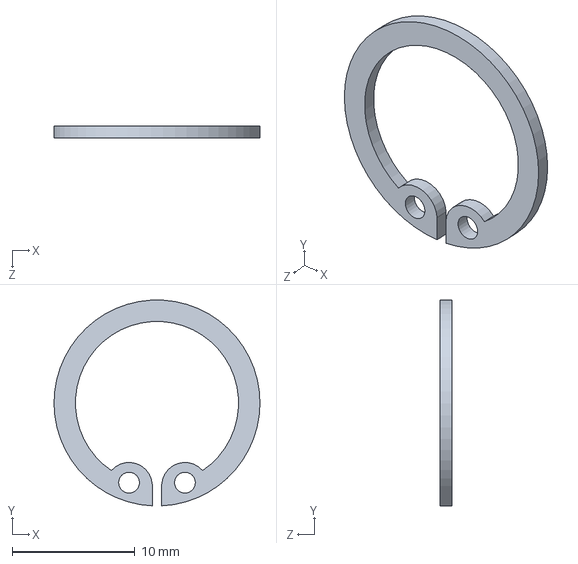
[picture p35: CAD file, 2024-10-09]
CAD/Solidworks/Standard components/circlips_din472_16_1.SLDPRT
16.8 x 16.8 x 1.00 mm
