DTUOpenAM/OpenVPP/CAD/Solidworks/Vat/Glass.SLDPRT

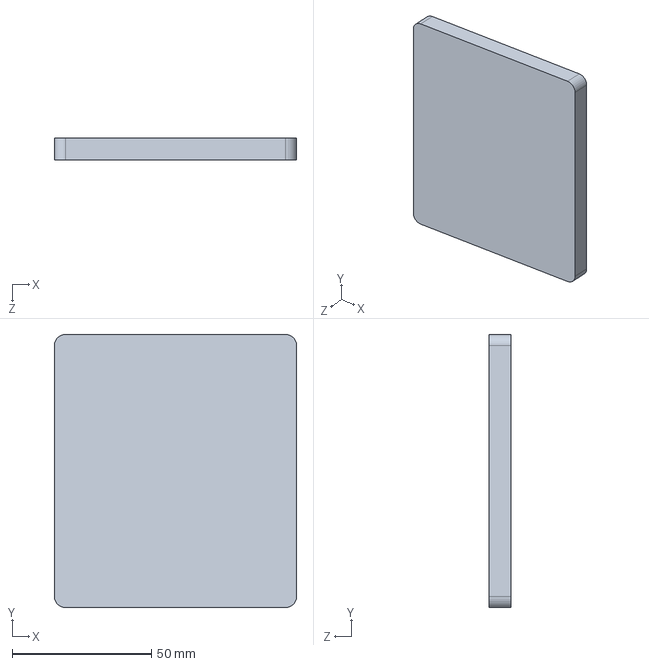
[picture p36: CAD file, 2024-10-09]
CAD/Solidworks/Vat/Glass.SLDPRT
87.0 x 98.0 x 8.00 mm
