DTUOpenAM/OpenVPP/CAD/Solidworks/Arduino Case/Pin cover.SLDPRT

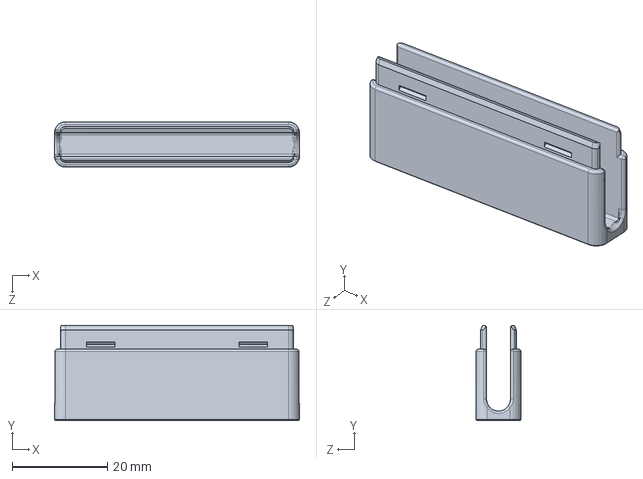
[picture p38: CAD file, 2024-10-09]
CAD/Solidworks/Arduino Case/Pin cover.SLDPRT
51.5 x 20.0 x 9.50 mm
