DTUOpenAM/OpenVPP/CAD/Solidworks/Projector/Sodemann Spring  E01800220620S.step

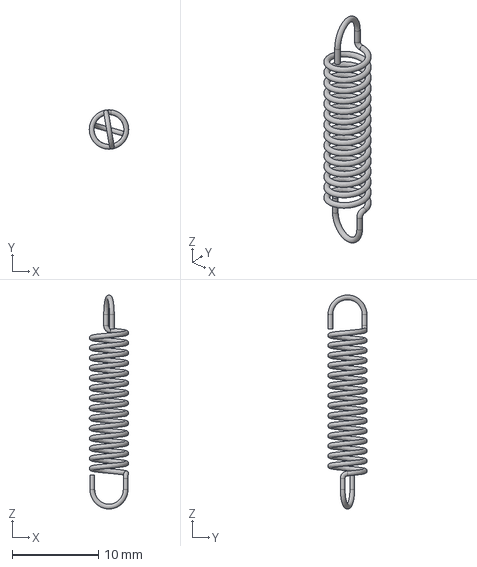
[picture p39: CAD file, 2024-10-09]
CAD/Solidworks/Projector/Sodemann Spring E01800220620S.step
4.57 x 4.57 x 24.7 mm
