DTUOpenAM/OpenVPP/CAD/Solidworks/Stage/Build plate/building_plate_PMMA.SLDPRT

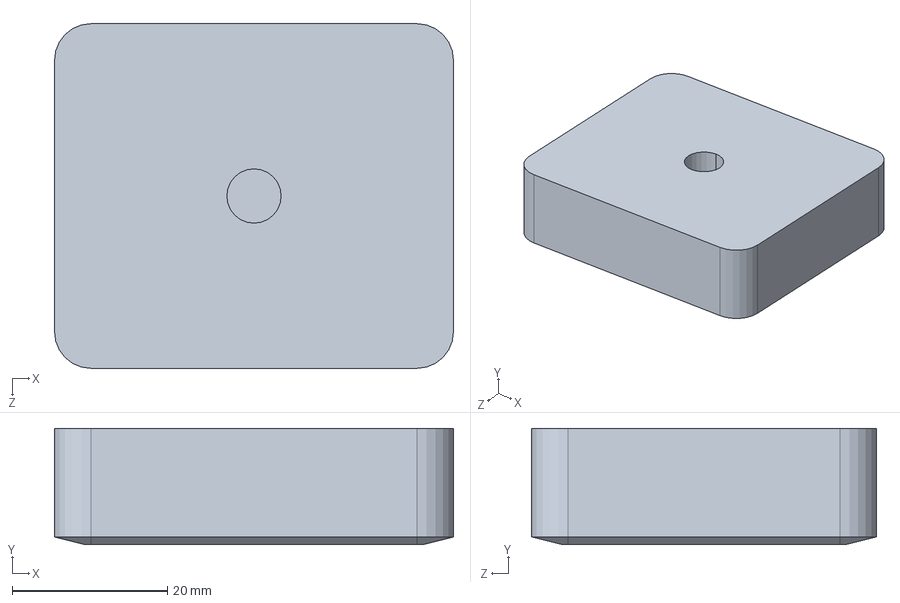
[picture p40: CAD file, 2024-10-09]
CAD/Solidworks/Stage/Build plate/building_plate_PMMA.SLDPRT
51.4 x 15.0 x 44.4 mm
