DTUOpenAM/OpenVPP/CAD/Solidworks/Standard components/Alu profiles/Rexroth 30x30x280.SLDPRT

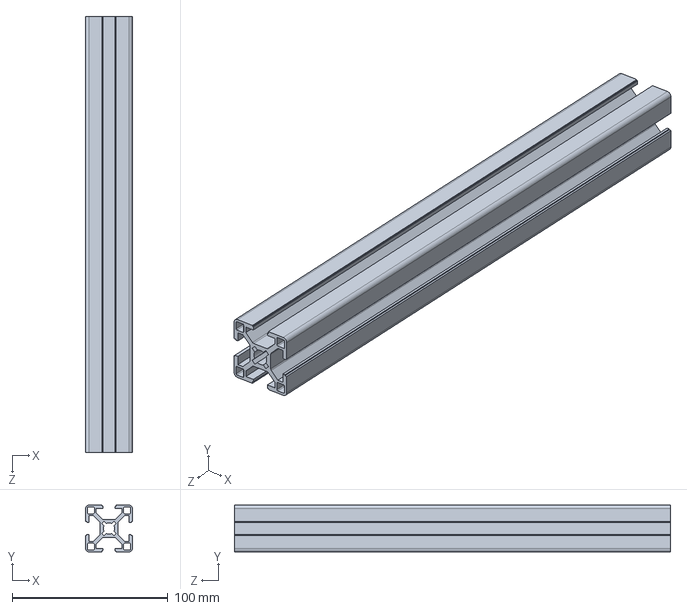
[picture p41: CAD file, 2024-10-09]
CAD/Solidworks/Standard components/Alu profiles/Rexroth 30x30x280.SLDPRT
30.0 x 30.0 x 280.0 mm
