DTUOpenAM/OpenVPP/CAD/Solidworks/Standard components/bkl_003.SLDPRT

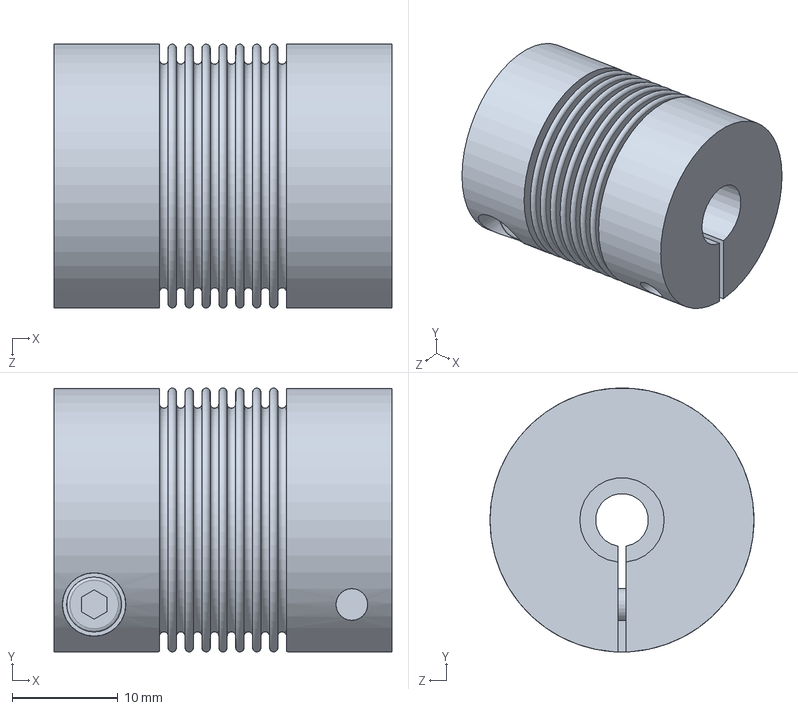
[picture p42: CAD file, 2024-10-09]
CAD/Solidworks/Standard components/bkl_003.SLDPRT
32.0 x 25.0 x 25.0 mm
