DTUOpenAM/OpenVPP/CAD/Solidworks/Standard components/Quater turn lock IMAO/qcth0834-20-sus_solidworks/qcth0834-20-sus_01.sldprt

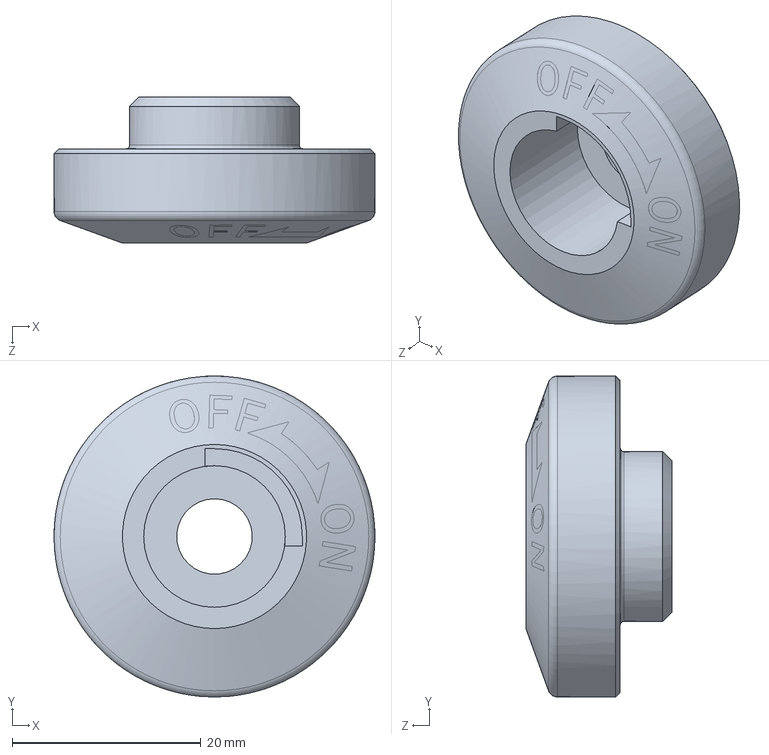
[picture p43: CAD file, 2024-10-09]
CAD/Solidworks/Standard components/Quater turn lock IMAO/qcth0834-20-sus_solidworks/qcth0834-20-sus_01.sldprt
34.0 x 34.0 x 15.5 mm
