DTUOpenAM/OpenVPP/CAD/Solidworks/Vat/spændeskive-laser.sldprt

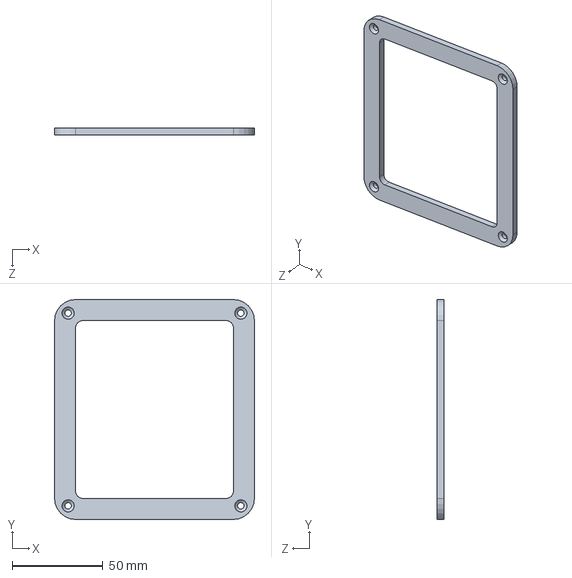
[picture p44: CAD file, 2024-10-09]
CAD/Solidworks/Vat/spændeskive-laser.sldprt
110.0 x 121.0 x 4.00 mm
