DTUOpenAM/OpenVPP/CAD/Solidworks/Arduino Case/Arduino R3 UNO/Arduino board.SLDPRT

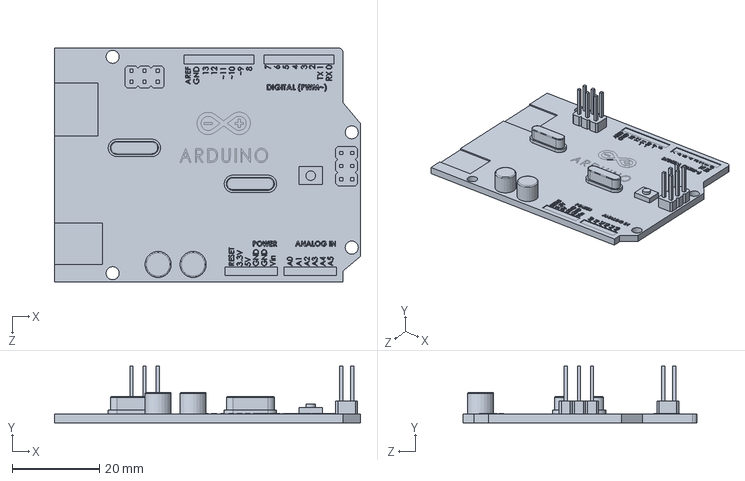
[picture p45: CAD file, 2024-10-09]
CAD/Solidworks/Arduino Case/Arduino R3 UNO/Arduino board.SLDPRT
70.0 x 13.0 x 53.5 mm
