DTUOpenAM/OpenVPP/CAD/Solidworks/Projector/Projector_BASE_Bottom.SLDPRT

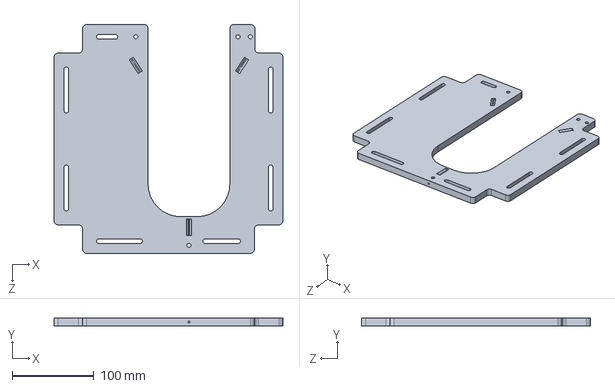
[picture p46: CAD file, 2024-10-09]
CAD/Solidworks/Projector/Projector_BASE_Bottom.SLDPRT
280.0 x 10.0 x 280.0 mm
