DTUOpenAM/OpenVPP/CAD/Solidworks/Standard components/17HS24-2104S.STEP

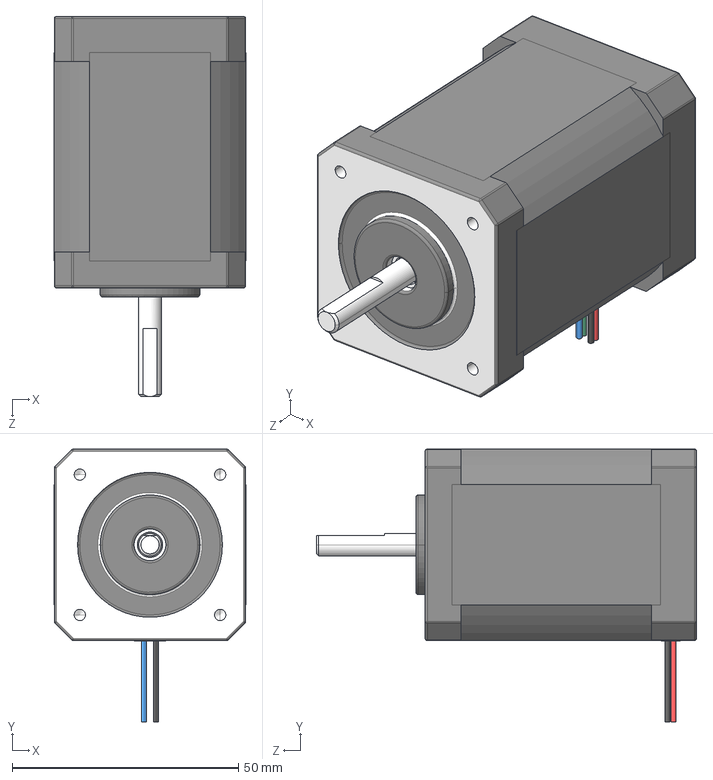
[picture p47: CAD file, 2024-10-09]
CAD/Solidworks/Standard components/17HS24-2104S.STEP
42.3 x 60.3 x 84.0 mm
