DTUOpenAM/OpenVPP/CAD/Solidworks/Vat/baseVAT1.2.SLDPRT

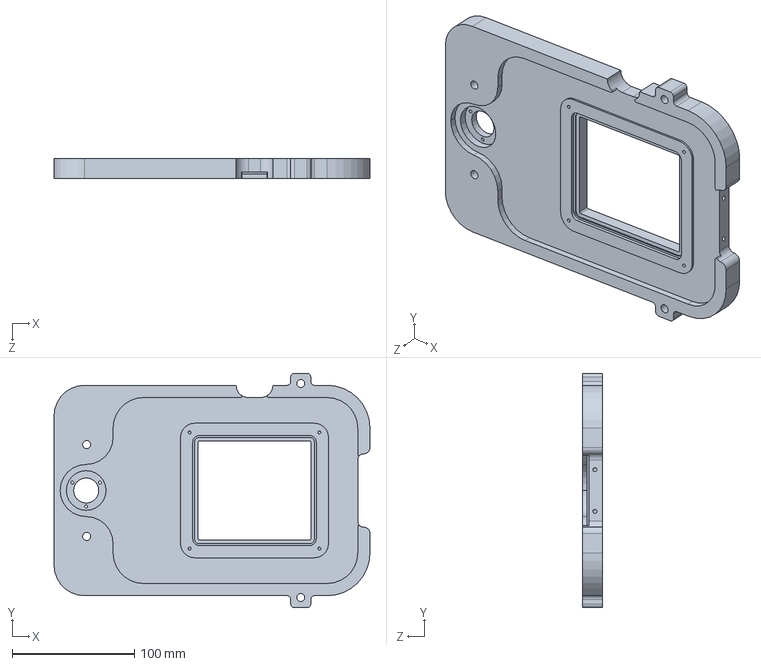
[picture p48: CAD file, 2024-10-09]
CAD/Solidworks/Vat/baseVAT1.2.SLDPRT
258.3 x 191.5 x 16.0 mm
