DTUOpenAM/OpenVPP/CAD/Solidworks/Arduino Case/Arduino R3 UNO/IC pin.SLDPRT

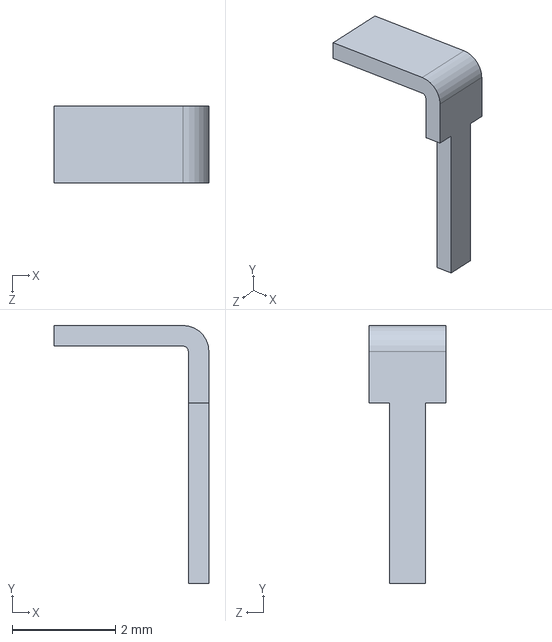
[picture p49: CAD file, 2024-10-09]
CAD/Solidworks/Arduino Case/Arduino R3 UNO/IC pin.SLDPRT
3.00 x 5.00 x 1.50 mm
