DTUOpenAM/OpenVPP/CAD/Solidworks/Stage/Limit_switch.SLDPRT

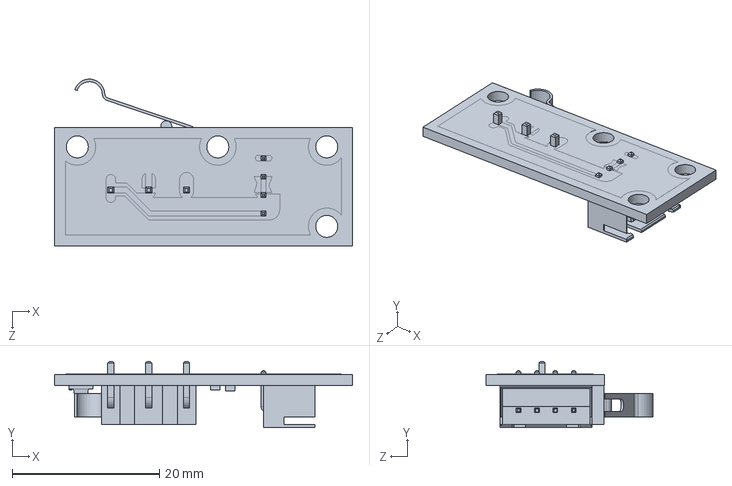
[picture p50: CAD file, 2024-10-09]
CAD/Solidworks/Stage/Limit_switch.SLDPRT
40.5 x 9.00 x 22.7 mm
