DTUOpenAM/OpenVPP/CAD/Solidworks/Standard components/Quater turn lock IMAO/qcth0834-20-sus_solidworks/qcth0834-20-sus_02.sldprt

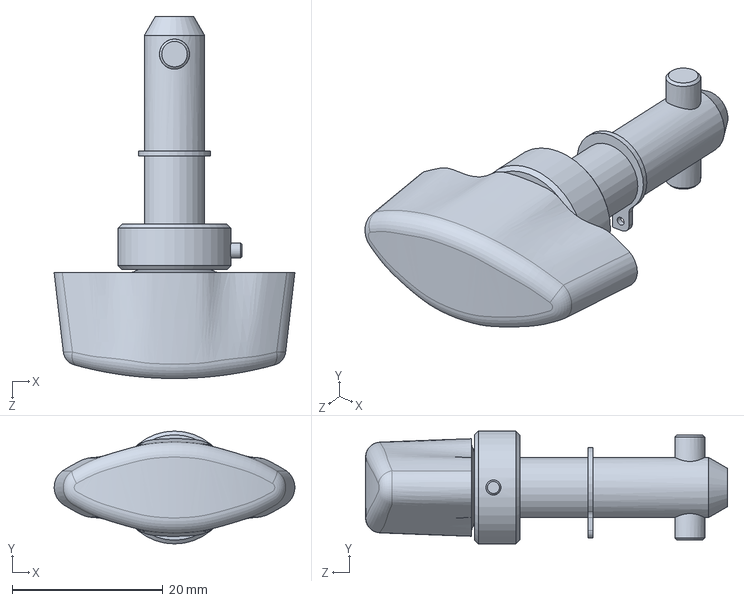
[picture p51: CAD file, 2024-10-09]
CAD/Solidworks/Standard components/Quater turn lock IMAO/qcth0834-20-sus_solidworks/qcth0834-20-sus_02.sldprt
32.0 x 15.0 x 48.1 mm
