DTUOpenAM/OpenVPP/CAD/Solidworks/Arduino Case/Arduino R3 UNO/IC body.SLDPRT

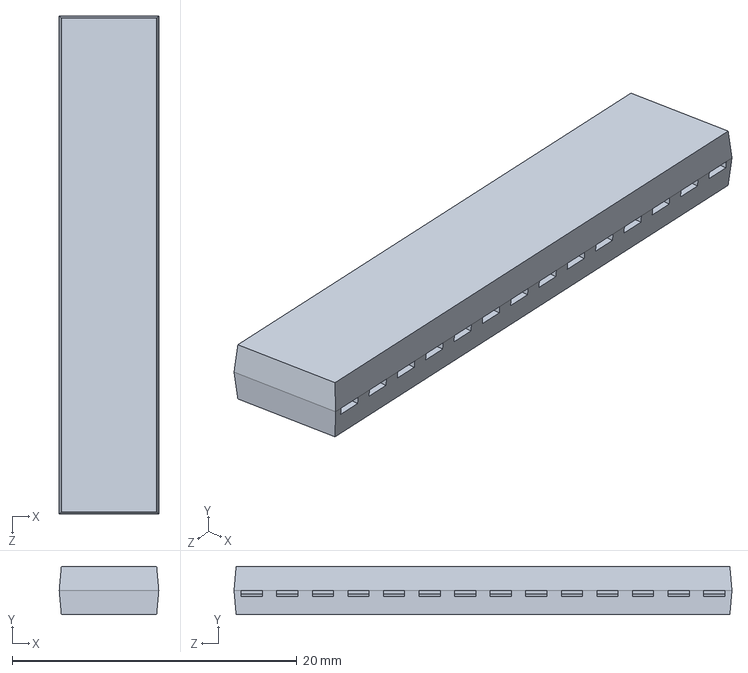
[picture p52: CAD file, 2024-10-09]
CAD/Solidworks/Arduino Case/Arduino R3 UNO/IC body.SLDPRT
7.00 x 3.40 x 35.0 mm
