DTUOpenAM/OpenVPP/CAD/Solidworks/Projector/Projector_bracket.SLDPRT

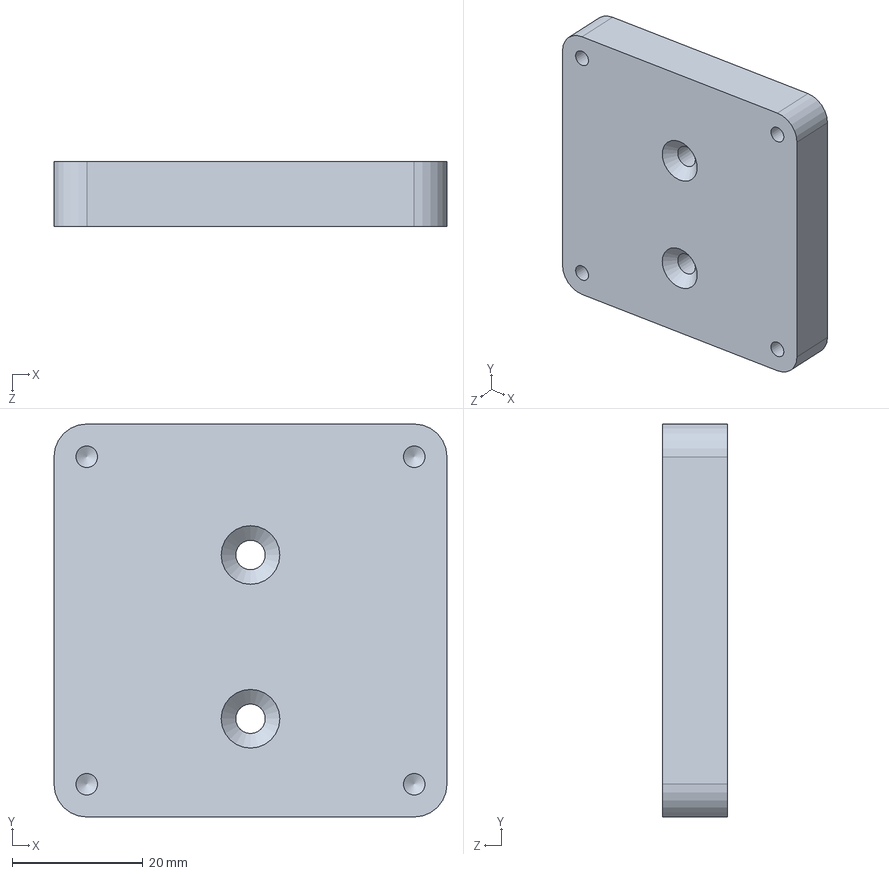
[picture p53: CAD file, 2024-10-09]
CAD/Solidworks/Projector/Projector_bracket.SLDPRT
60.0 x 60.0 x 10.0 mm
