DTUOpenAM/OpenVPP/CAD/Solidworks/Stage/H_plate1.2.SLDPRT

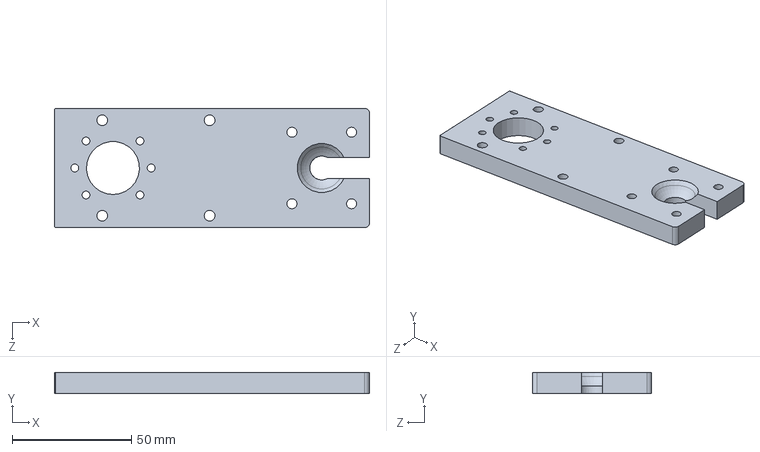
[picture p54: CAD file, 2024-10-09]
CAD/Solidworks/Stage/H_plate1.2.SLDPRT
132.0 x 9.00 x 50.0 mm
