DTUOpenAM/OpenVPP/CAD/Solidworks/Arduino Case/Arduino R3 UNO/Jack Socket.SLDPRT

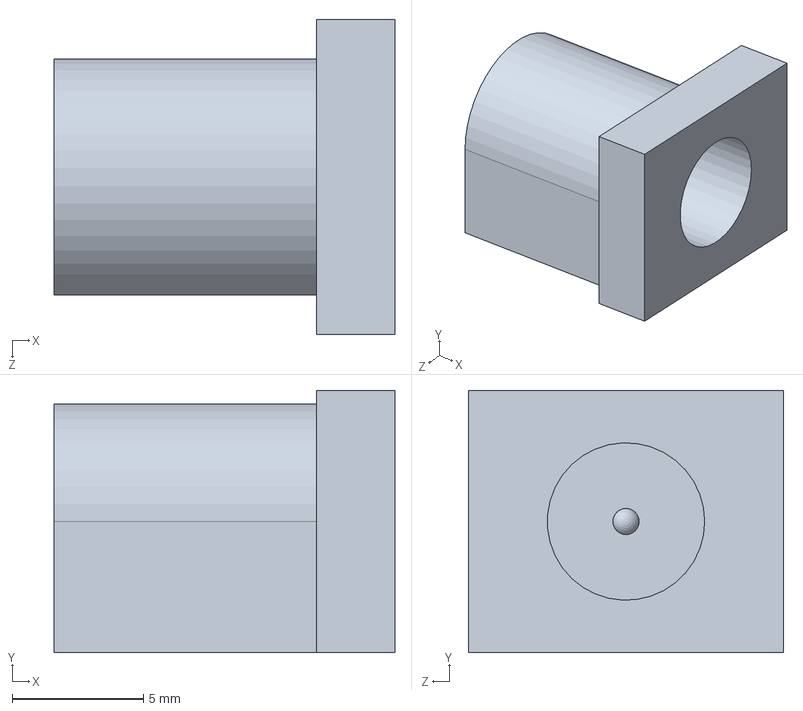
[picture p55: CAD file, 2024-10-09]
CAD/Solidworks/Arduino Case/Arduino R3 UNO/Jack Socket.SLDPRT
13.0 x 10.0 x 12.0 mm
