DTUOpenAM/OpenVPP/CAD/Solidworks/Projector/Projector_bracket_support.SLDPRT

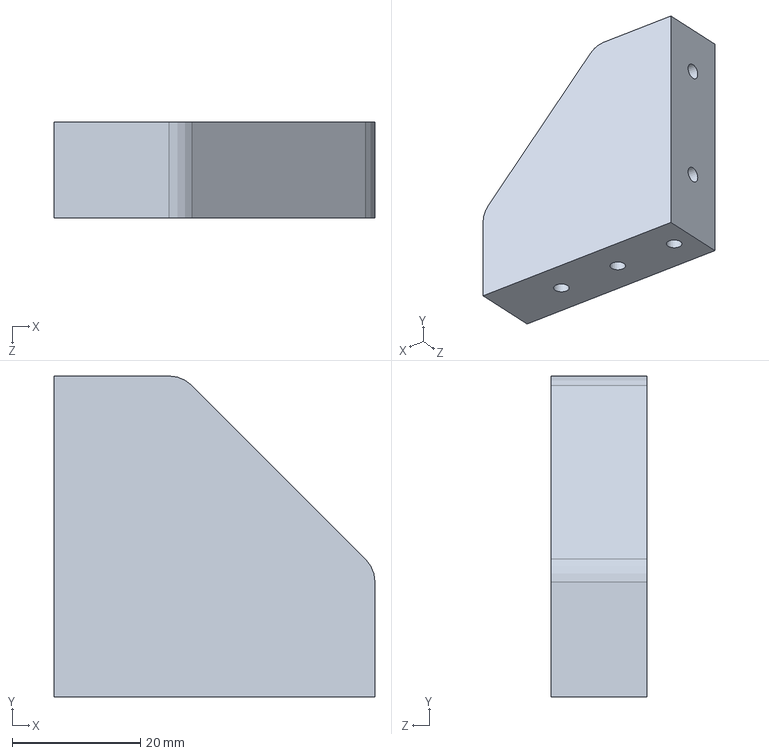
[picture p56: CAD file, 2024-10-09]
CAD/Solidworks/Projector/Projector_bracket_support.SLDPRT
50.0 x 50.0 x 15.0 mm
