DTUOpenAM/OpenVPP/CAD/Solidworks/Stage/Bearing_bottom_mount_A_3.0.SLDPRT

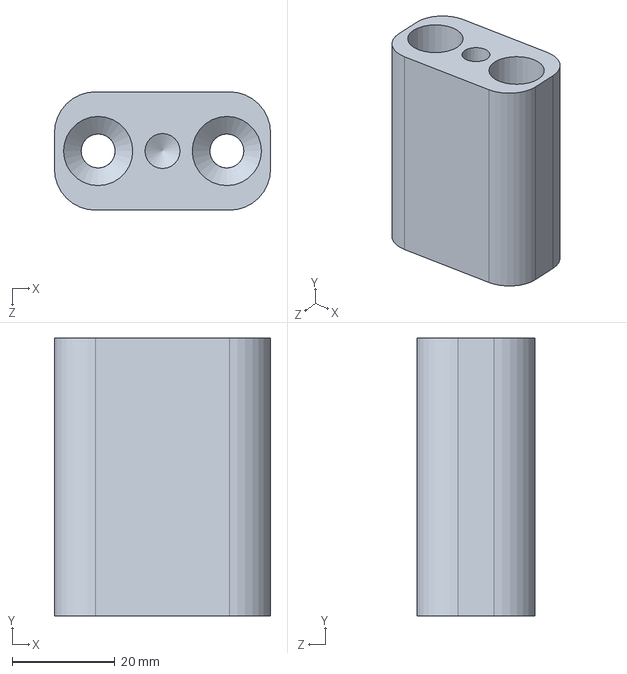
[picture p57: CAD file, 2024-10-09]
CAD/Solidworks/Stage/Bearing_bottom_mount_A_3.0.SLDPRT
42.0 x 54.0 x 23.0 mm
