DTUOpenAM/OpenVPP/CAD/Solidworks/Projector/lineær stage roller.SLDPRT

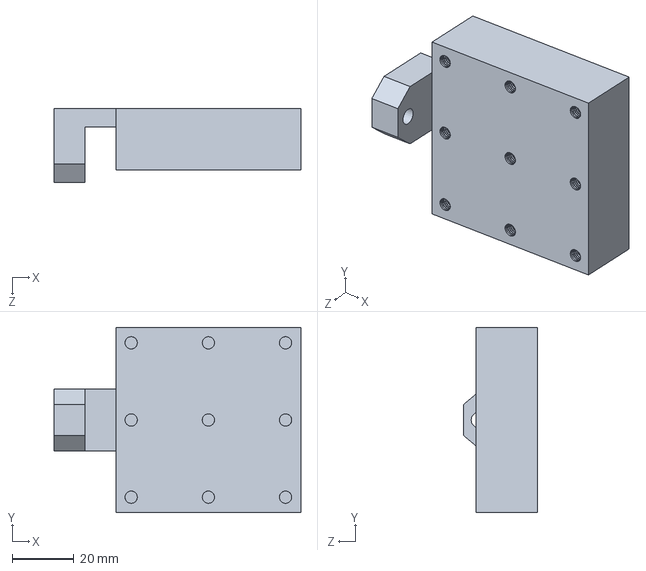
[picture p58: CAD file, 2024-10-09]
CAD/Solidworks/Projector/lineær stage roller.SLDPRT
80.0 x 60.0 x 24.0 mm
