DTUOpenAM/OpenVPP/CAD/Solidworks/Stage/Build_plate_holder_top_1.1.SLDPRT

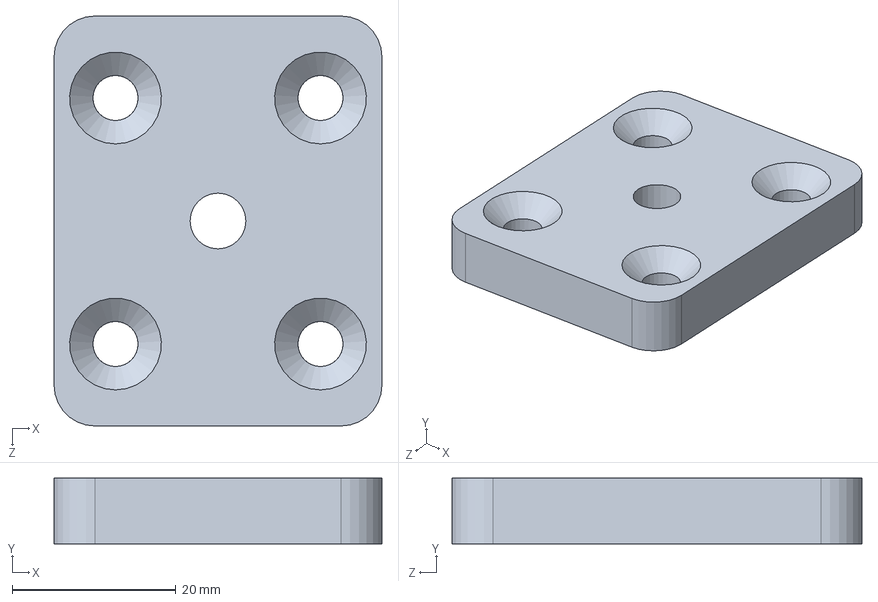
[picture p59: CAD file, 2024-10-09]
CAD/Solidworks/Stage/Build_plate_holder_top_1.1.SLDPRT
40.0 x 8.00 x 50.0 mm
