DTUOpenAM/OpenVPP/CAD/Solidworks/Standard components/CT_476_40_p_M8x25.stp

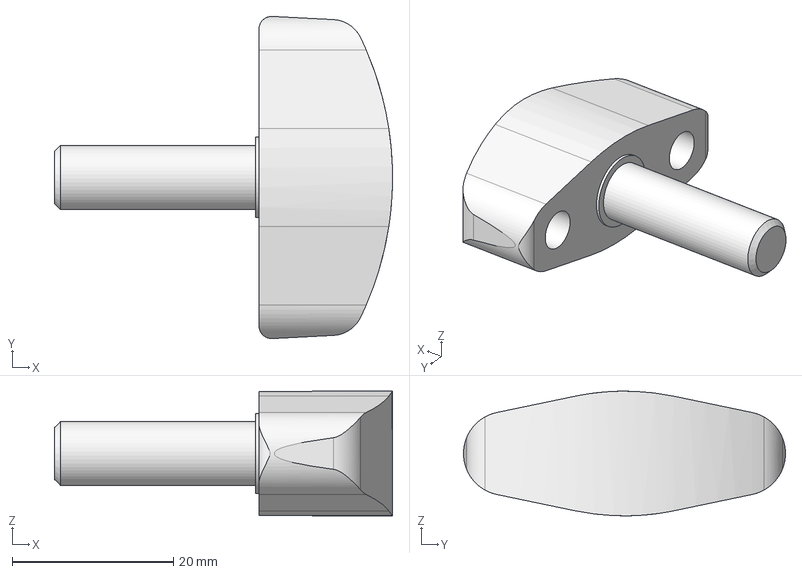
[picture p60: CAD file, 2024-10-09]
CAD/Solidworks/Standard components/CT_476_40_p_M8x25.stp
42.0 x 40.0 x 15.5 mm
