DTUOpenAM/OpenVPP/CAD/Solidworks/Projector/Projector_sandwich.SLDPRT

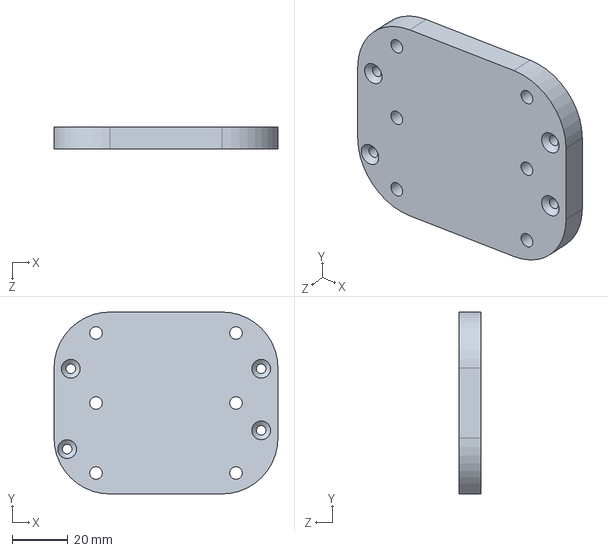
[picture p61: CAD file, 2024-10-09]
CAD/Solidworks/Projector/Projector_sandwich.SLDPRT
80.0 x 65.0 x 8.00 mm
