DTUOpenAM/OpenVPP/CAD/Solidworks/Stage/30x30 bracket.SLDPRT

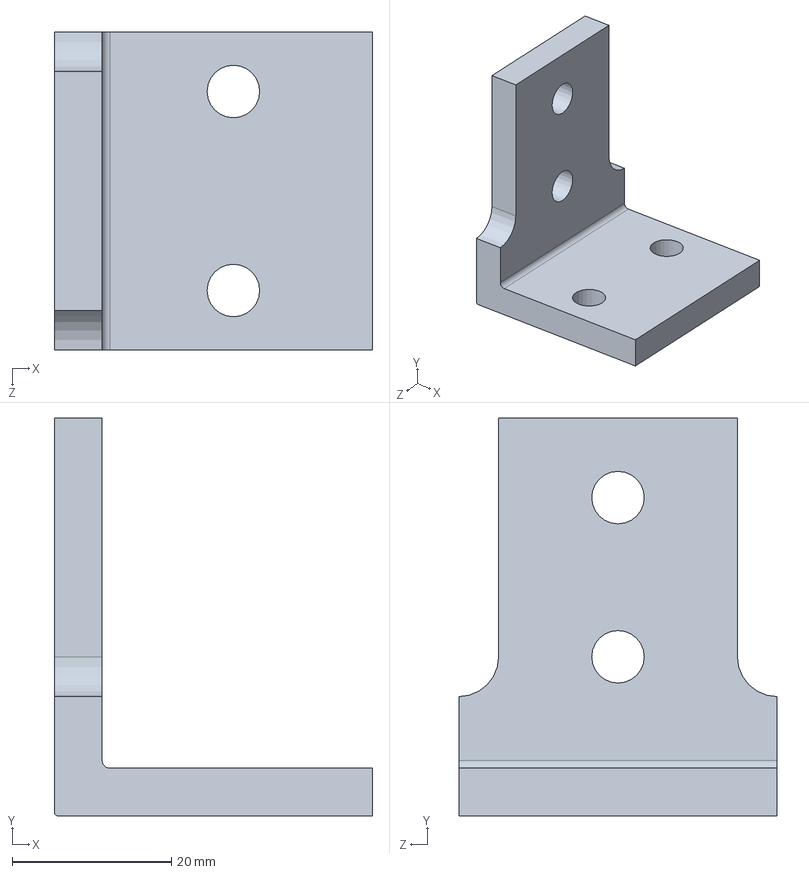
[picture p62: CAD file, 2024-10-09]
CAD/Solidworks/Stage/30x30 bracket.SLDPRT
40.0 x 50.0 x 40.0 mm
