DTUOpenAM/OpenVPP/CAD/Solidworks/Standard components/MB3030U_M-Solidworks.SLDPRT

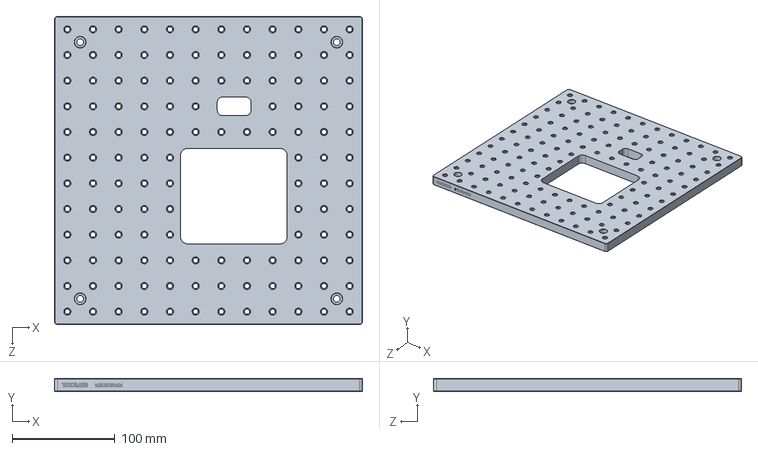
[picture p63: CAD file, 2024-10-09]
CAD/Solidworks/Standard components/MB3030U_M-Solidworks.SLDPRT
300.0 x 12.7 x 300.0 mm
