DTUOpenAM/OpenVPP/CAD/Solidworks/Stage/motor_bracket_1.2.SLDPRT

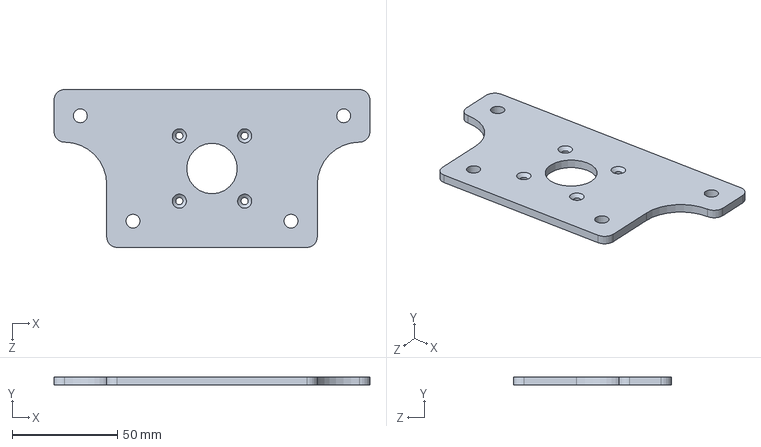
[picture p64: CAD file, 2024-10-09]
CAD/Solidworks/Stage/motor_bracket_1.2.SLDPRT
150.0 x 4.00 x 75.0 mm
