DTUOpenAM/OpenVPP/CAD/Solidworks/Standard components/milimeterskrue.SLDPRT

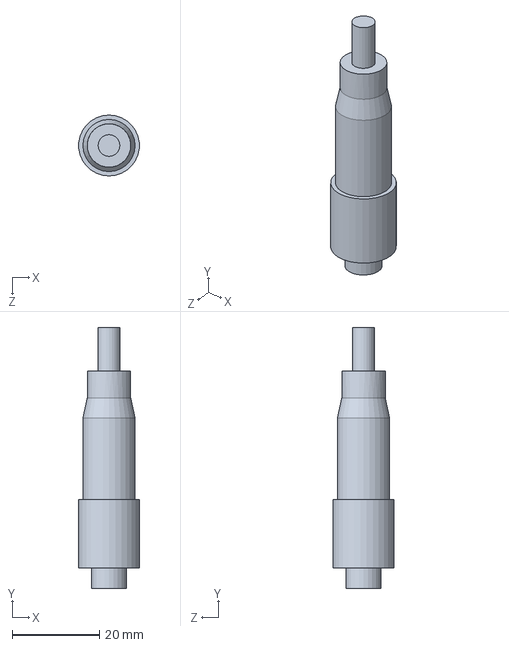
[picture p65: CAD file, 2024-10-09]
CAD/Solidworks/Standard components/milimeterskrue.SLDPRT
13.9 x 60.0 x 14.0 mm
