DTUOpenAM/OpenVPP/CAD/Solidworks/Stage/Shim.SLDPRT

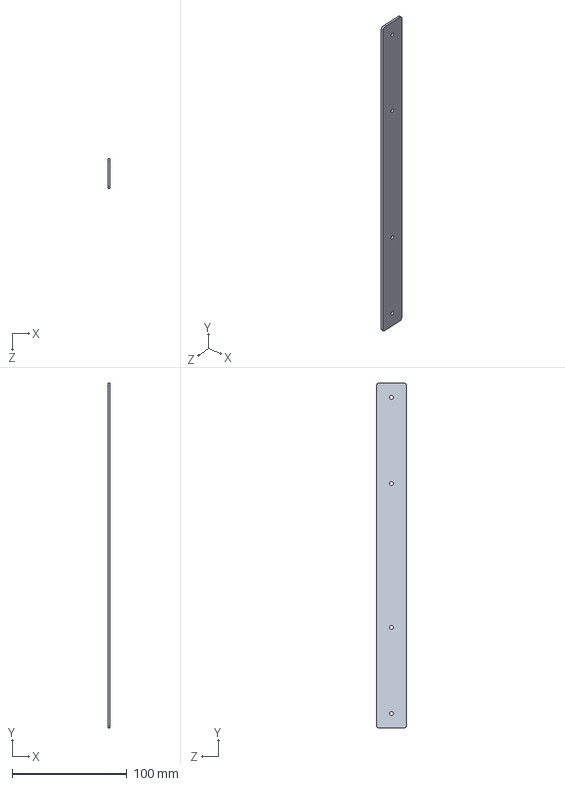
[picture p66: CAD file, 2024-10-09]
CAD/Solidworks/Stage/Shim.SLDPRT
2.00 x 300.0 x 26.0 mm
