DTUOpenAM/OpenVPP/CAD/Solidworks/Stage/V_plate.SLDPRT

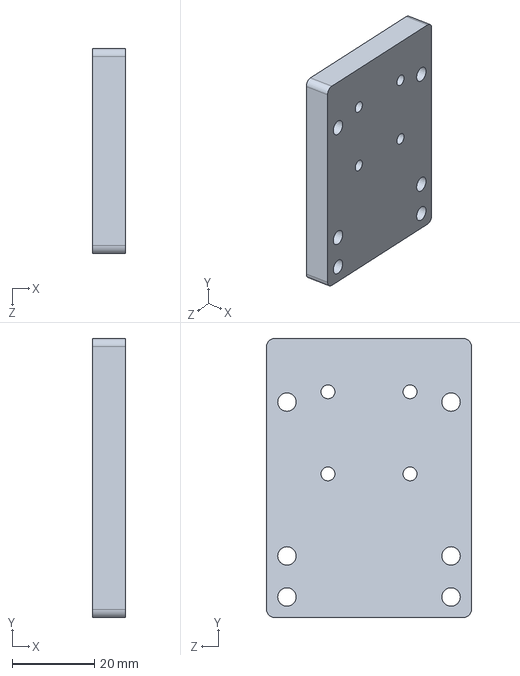
[picture p67: CAD file, 2024-10-09]
CAD/Solidworks/Stage/V_plate.SLDPRT
8.00 x 68.0 x 50.0 mm
