DTUOpenAM/OpenVPP/CAD/Solidworks/Stage/Plate_support.SLDPRT

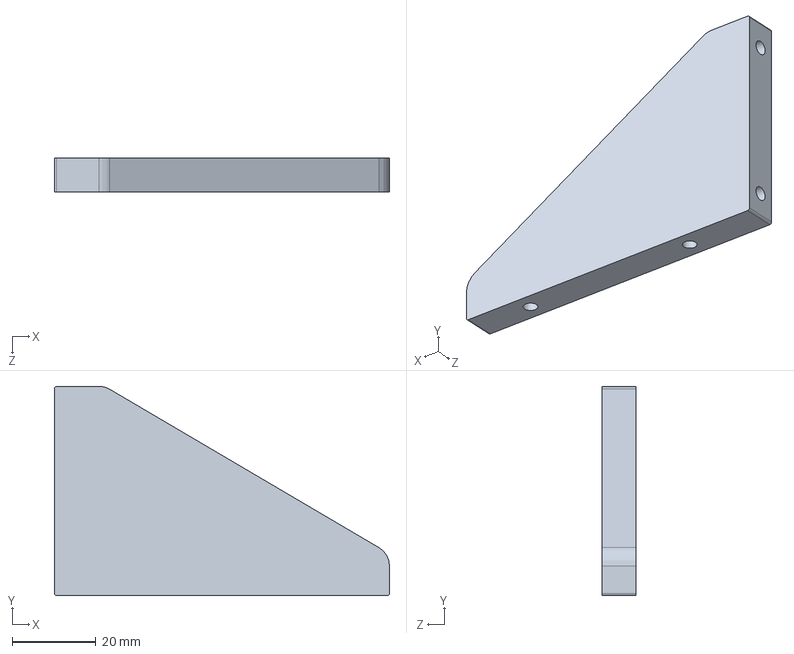
[picture p68: CAD file, 2024-10-09]
CAD/Solidworks/Stage/Plate_support.SLDPRT
80.0 x 50.0 x 8.00 mm
