DTUOpenAM/OpenVPP/CAD/Solidworks/Stage/Bushing_6,5mm.SLDPRT

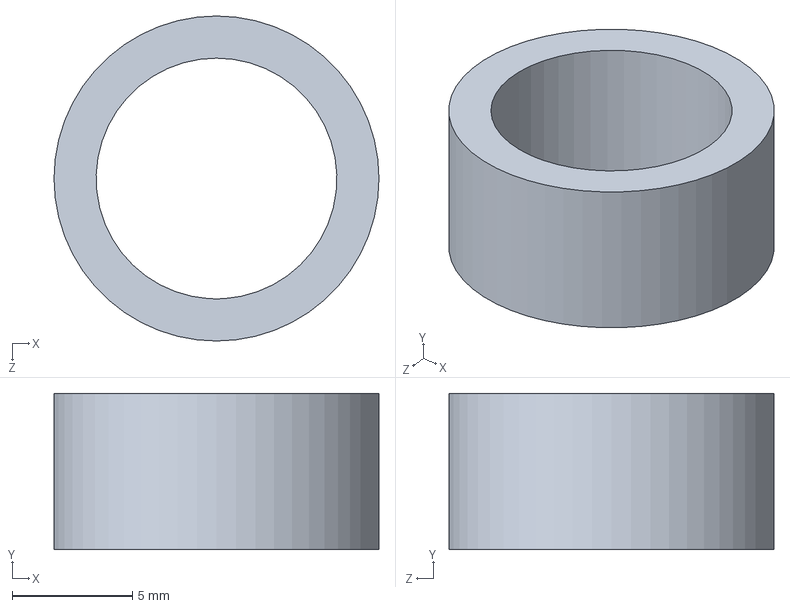
[picture p69: CAD file, 2024-10-09]
CAD/Solidworks/Stage/Bushing_6,5mm.SLDPRT
13.5 x 6.50 x 13.5 mm
