DTUOpenAM/OpenVPP/CAD/Solidworks/Large assemblies/Outline structure.SLDASM

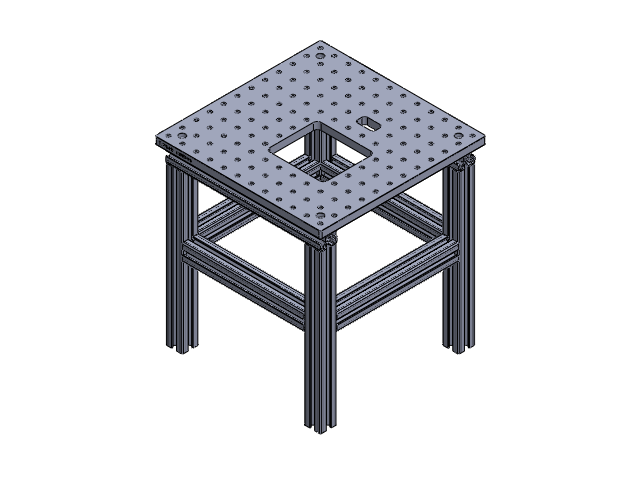
[picture p70: CAD file, 2024-10-09]
CAD/Solidworks/Large assemblies/Outline structure.SLDASM
Rexroth 30x30x285 x 4
Rexroth 30x30x220 x 4
MB3030U_M-Solidworks
Rexroth 30x30x280 x 2
uno_case_lid
uno_case_base
Arduino board
Jack Socket
pin x 2
pin2 x 2
USB socket
hex socket head screws_iso x 4
socket button head screw_iso x 4
