DTUOpenAM/OpenVPP/(list of files, cad)

Other CAD files:
CAD/Solidworks/Arduino Case/Arduino_case_assem.SLDASM
CAD/Solidworks/Standard components/Quater turn lock IMAO/qcth0834-20-sus_solidworks/qcth0834-20-sus_04.sldprt
CAD/Solidworks/Standard components/Quater turn lock IMAO/qcth0834-20-sus_solidworks/qcth0834-20-sus_05.sldprt
CAD/Solidworks/Projector/Sodemann Spring E01800220620S.step.SLDPRT
CAD/Solidworks/Standard components/Limit_switch.SLDPRT
CAD/Solidworks/Large assemblies/Stage_exploded.SLDDRW
CAD/Solidworks/Standard components/17HS24-2104S.SLDPRT
CAD/Solidworks/Standard components/Ball screw nut.SLDPRT
CAD/Solidworks/Standard components/Ball screw.SLDPRT
