DTUOpenAM/OpenVPP/CAD/Exploded_view/Vat assembly.exploded.PNG

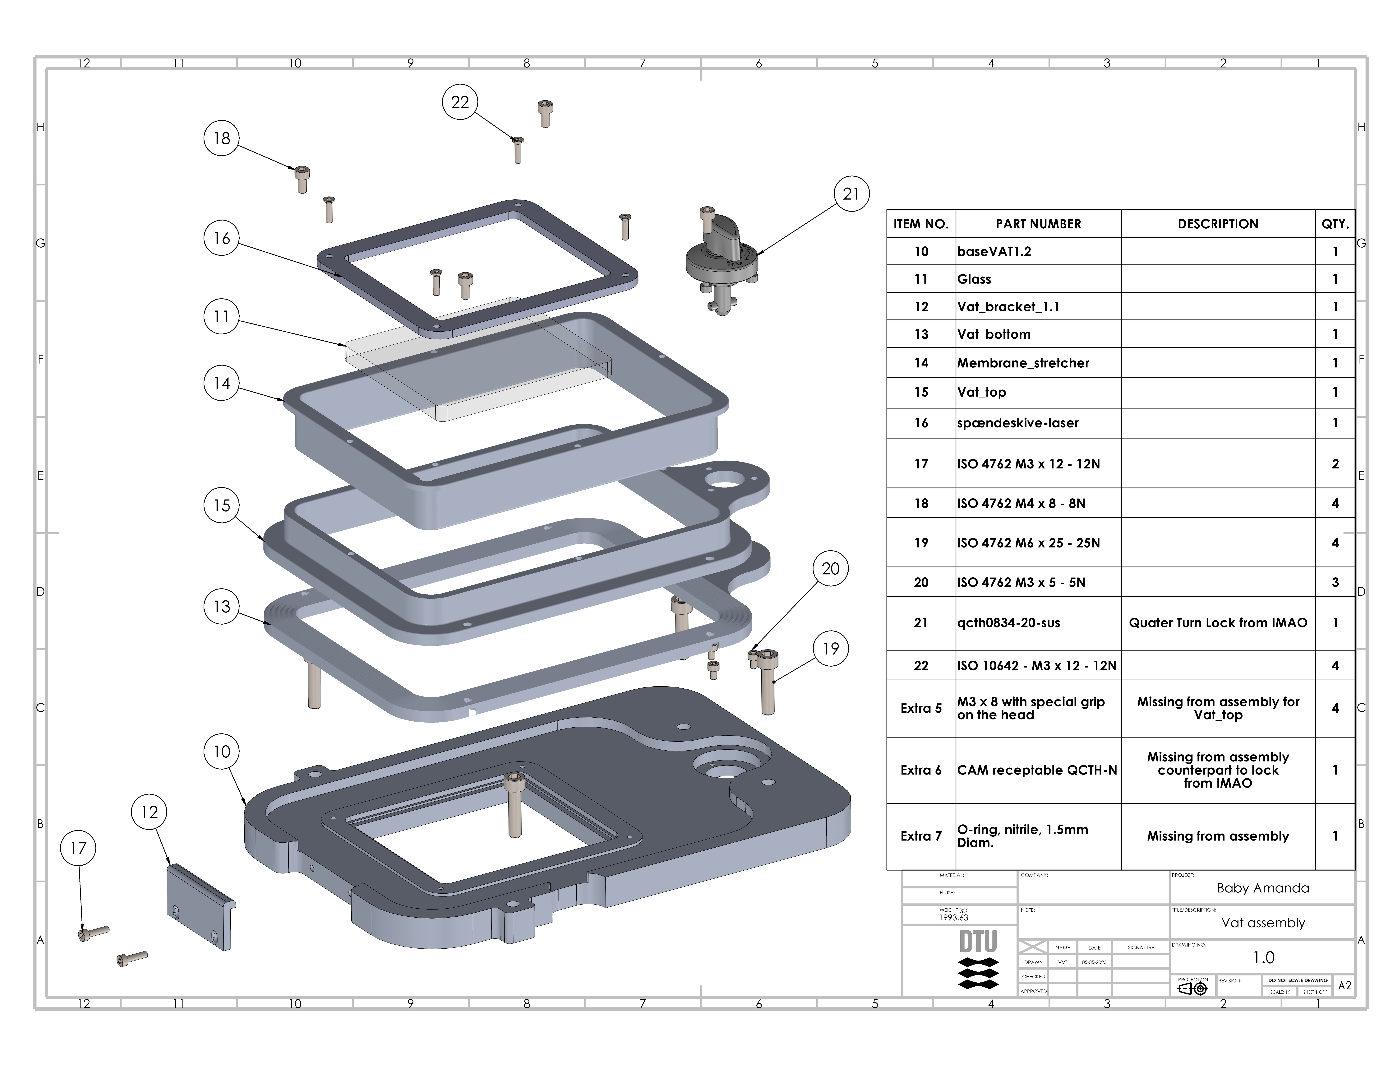
CAD/Exploded_view/Vat assembly.exploded.PNG
