DTUOpenAM/OpenVPP/CAD/Exploded_view/Projector Assembly.exploded.pdf

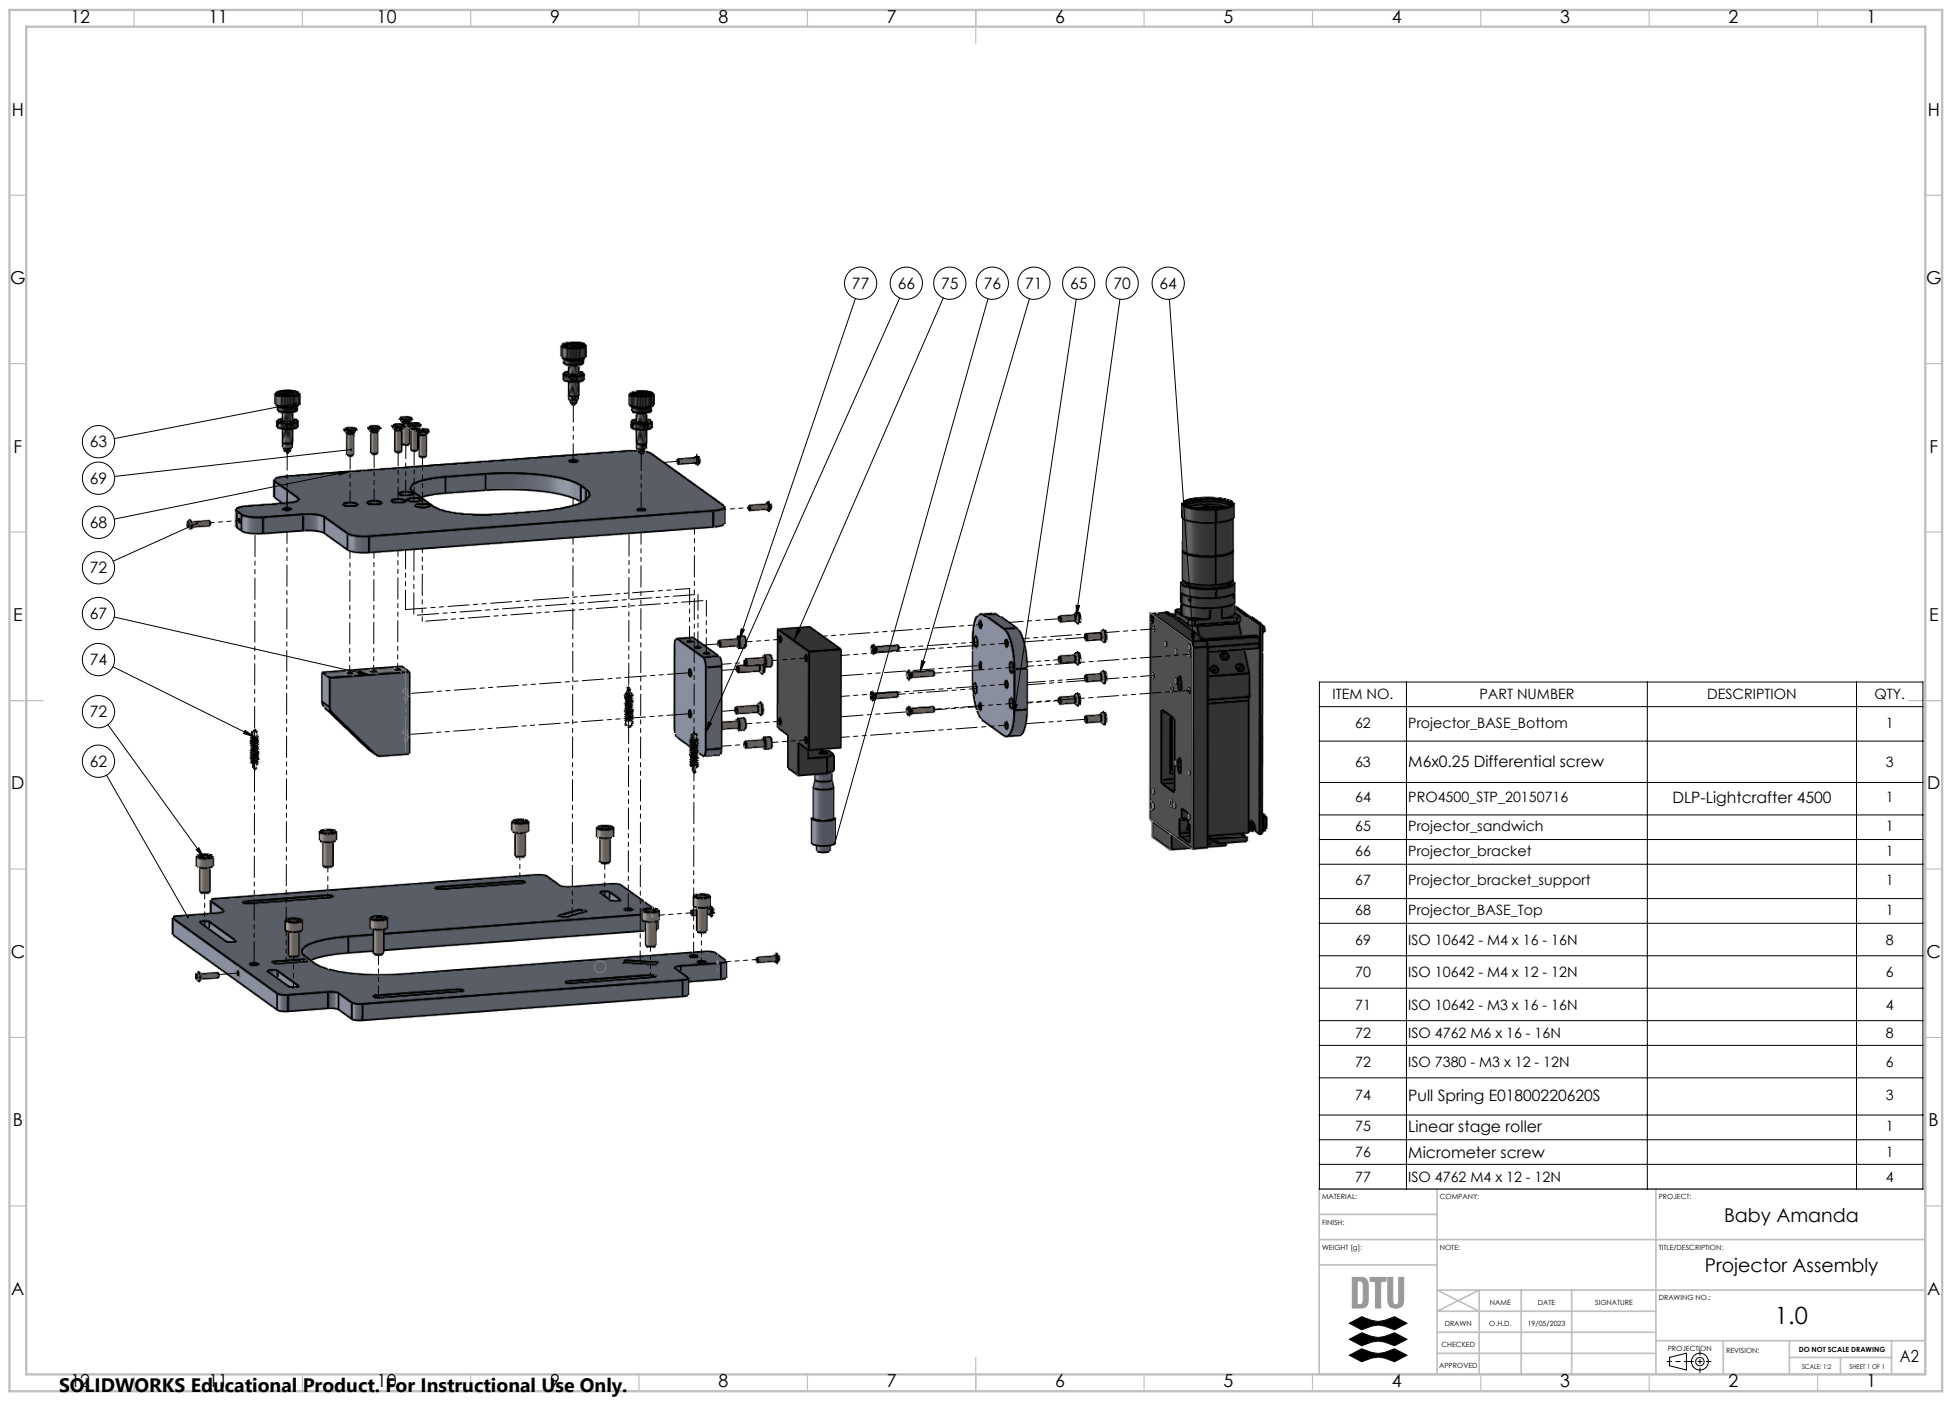
[picture p72: page 1]
Projector Assembly; DRAWING NO.:; Baby Amanda; WEIGHT [g]:; SCALE: 1:2; SHEET 1 OF 1

ITEM NO. | PART NUMBER | DESCRIPTION | QTY.
62 | Projector_BASE_Bottom | | 1
63 | M6x0.25 Differential screw | | 3
64 | PRO4500_STP_20150716 | DLP-Lightcrafter 4500 | 1
65 | Projector_sandwich | | 1
66 | Projector_bracket | | 1
67 | Projector_bracket_support | | 1
68 | Projector_BASE_Top | | 1
69 | ISO 10642 - M4 x 16 - 16N | | 8
70 | ISO 10642 - M4 x 12 - 12N | | 6
71 | ISO 10642 - M3 x 16 - 16N | | 4
72 | ISO 4762 M6 x 16 - 16N | | 8
72 | ISO 7380 - M3 x 12 - 12N | | 6
74 | Pull Spring E01800220620S | | 3
75 | Linear stage roller | | 1
76 | Micrometer screw | | 1
77 | ISO 4762 M4 x 12 - 12N | | 4

A2 DO NOT SCALE DRAWING

SOLIDWORKS Educational Product. For Instructional Use Only.
