DTUOpenAM/OpenVPP/CAD/Exploded_view/Vat assembly.exploded.pdf

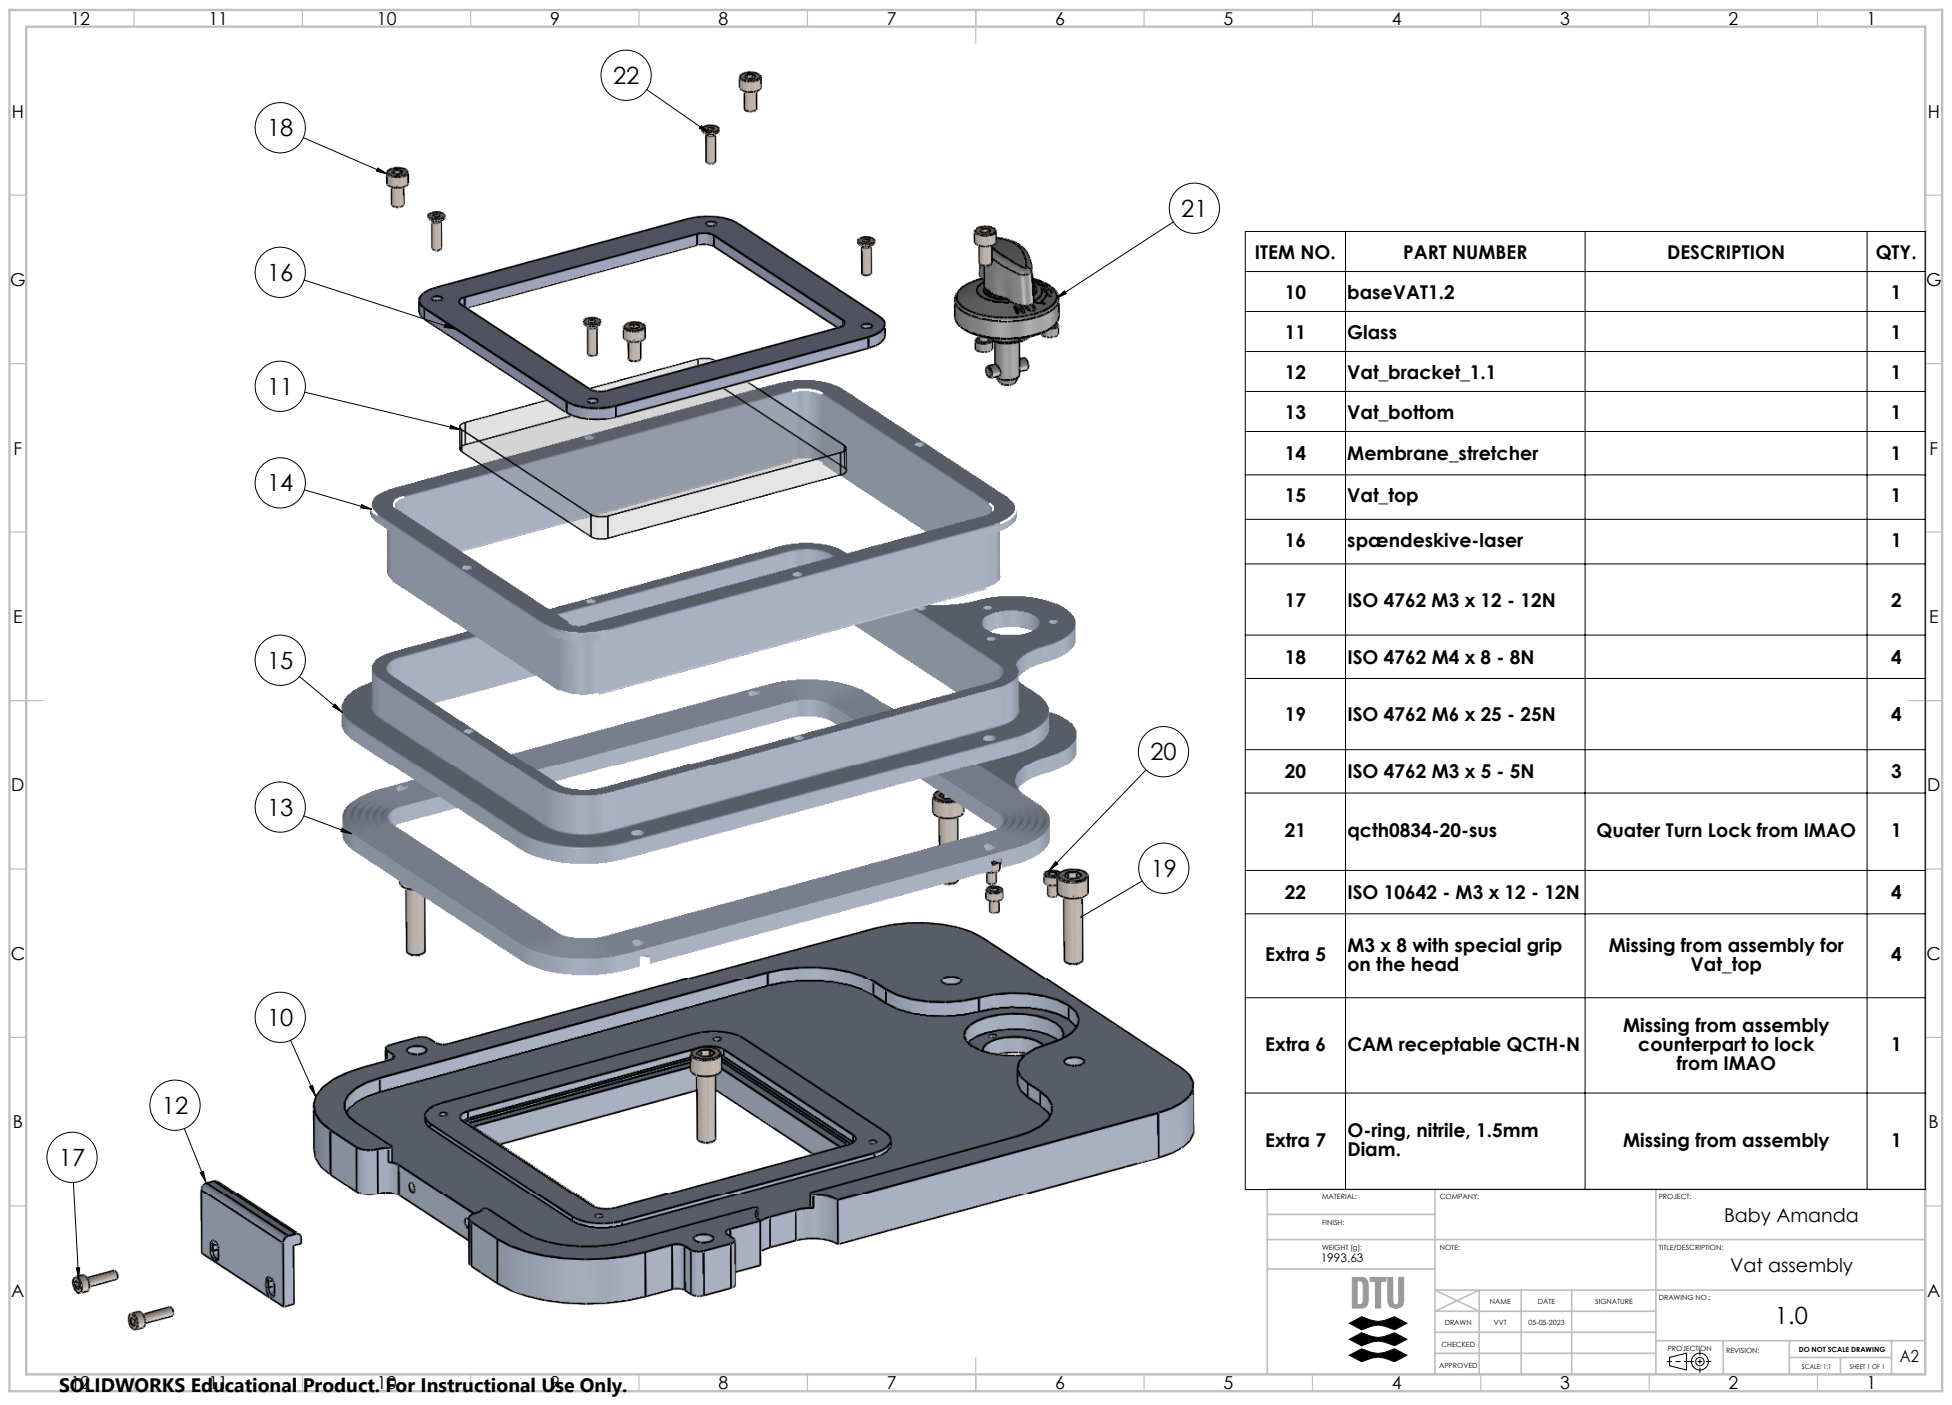
[picture p73: page 1]
ISO 10642 - M3 x 12 - 12N; Vat assembly; DRAWING NO.:; Baby Amanda; WEIGHT [g]:; SCALE: 1:1; SHEET 1 OF 1

ITEM NO. | PART NUMBER | DESCRIPTION | QTY.
10 | baseVAT1.2 | | 1
11 | Glass | | 1
12 | Vat_bracket_1.1 | | 1
13 | Vat_bottom | | 1
14 | Membrane_stretcher | | 1
15 | Vat_top | | 1
16 | spændeskive-laser | | 1

17 | ISO 4762 M3 x 12 - 12N | | 2

18 | ISO 4762 M4 x 8 - 8N | | 4

19 | ISO 4762 M6 x 25 - 25N | | 4

20 | ISO 4762 M3 x 5 - 5N | | 3

21 | qcth0834-20-sus | Quater Turn Lock from IMAO | 1

Extra 5 | M3 x 8 with special grip on the head | Missing from assembly for Vat_top | 4

Extra 6 | CAM receptable QCTH-N | Missing from assembly counterpart to lock from IMAO | 1

Extra 7 | O-ring, nitrile, 1.5mm Diam. | Missing from assembly | 1

A2 DO NOT SCALE DRAWING

SOLIDWORKS Educational Product. For Instructional Use Only.
