DTUOpenAM/OpenVPP/CAD/Technical_drawings/Build_plate_Ball.PDF

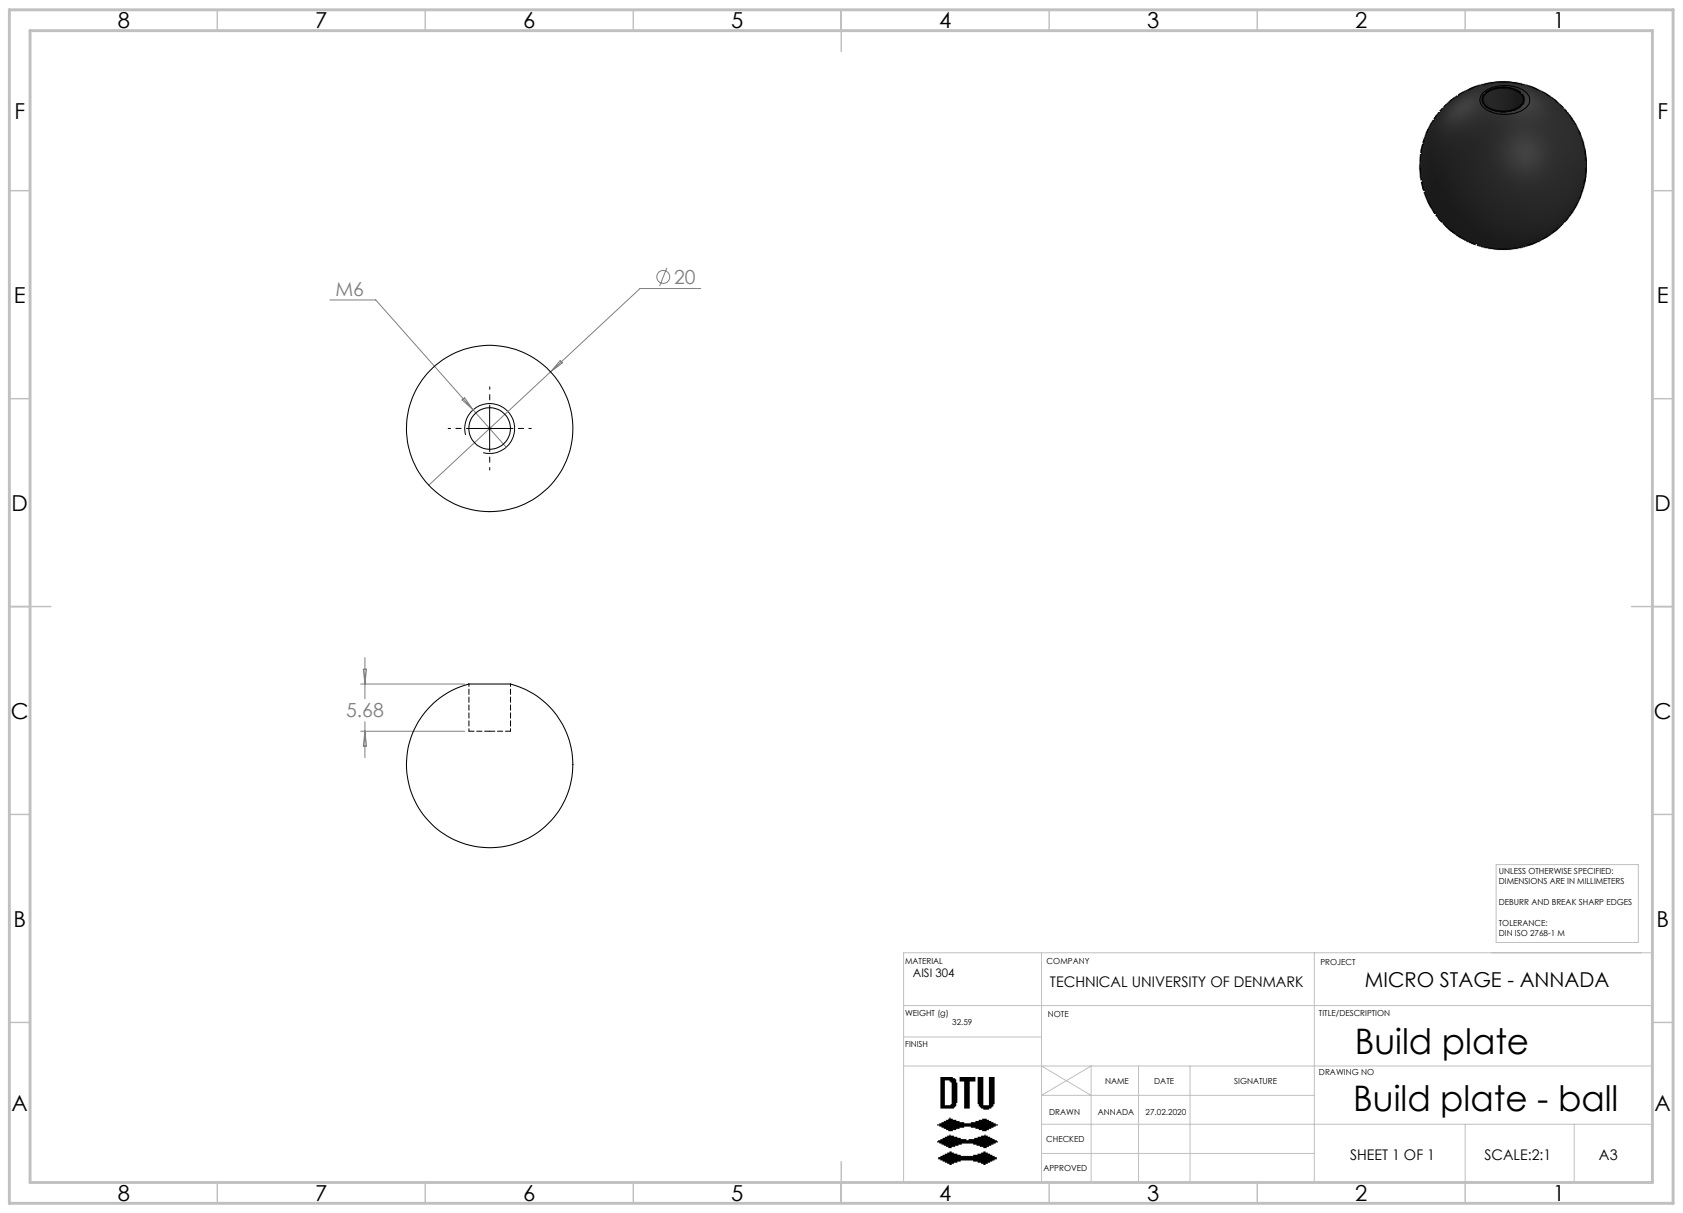
[picture p74: page 1]
WEIGHT (g); SHEET 1 OF 1; SCALE:2:1; DRAWING NO; ANNADA 27.02.2020

UNLESS OTHERWISE SPECIFIED:
DIMENSIONS ARE IN MILLIMETERS
DEBURR AND BREAK SHARP EDGES
TOLERANCE:
DIN ISO 2768-1 M
Build plate
Build plate - ball

MATERIAL
TECHNICAL UNIVERSITY OF DENMARK AISI 304

PROJECT
MICRO STAGE - ANNADA
