DTUOpenAM/OpenVPP/CAD/Technical_drawings/Build_plate_holder_top_1.1.pdf

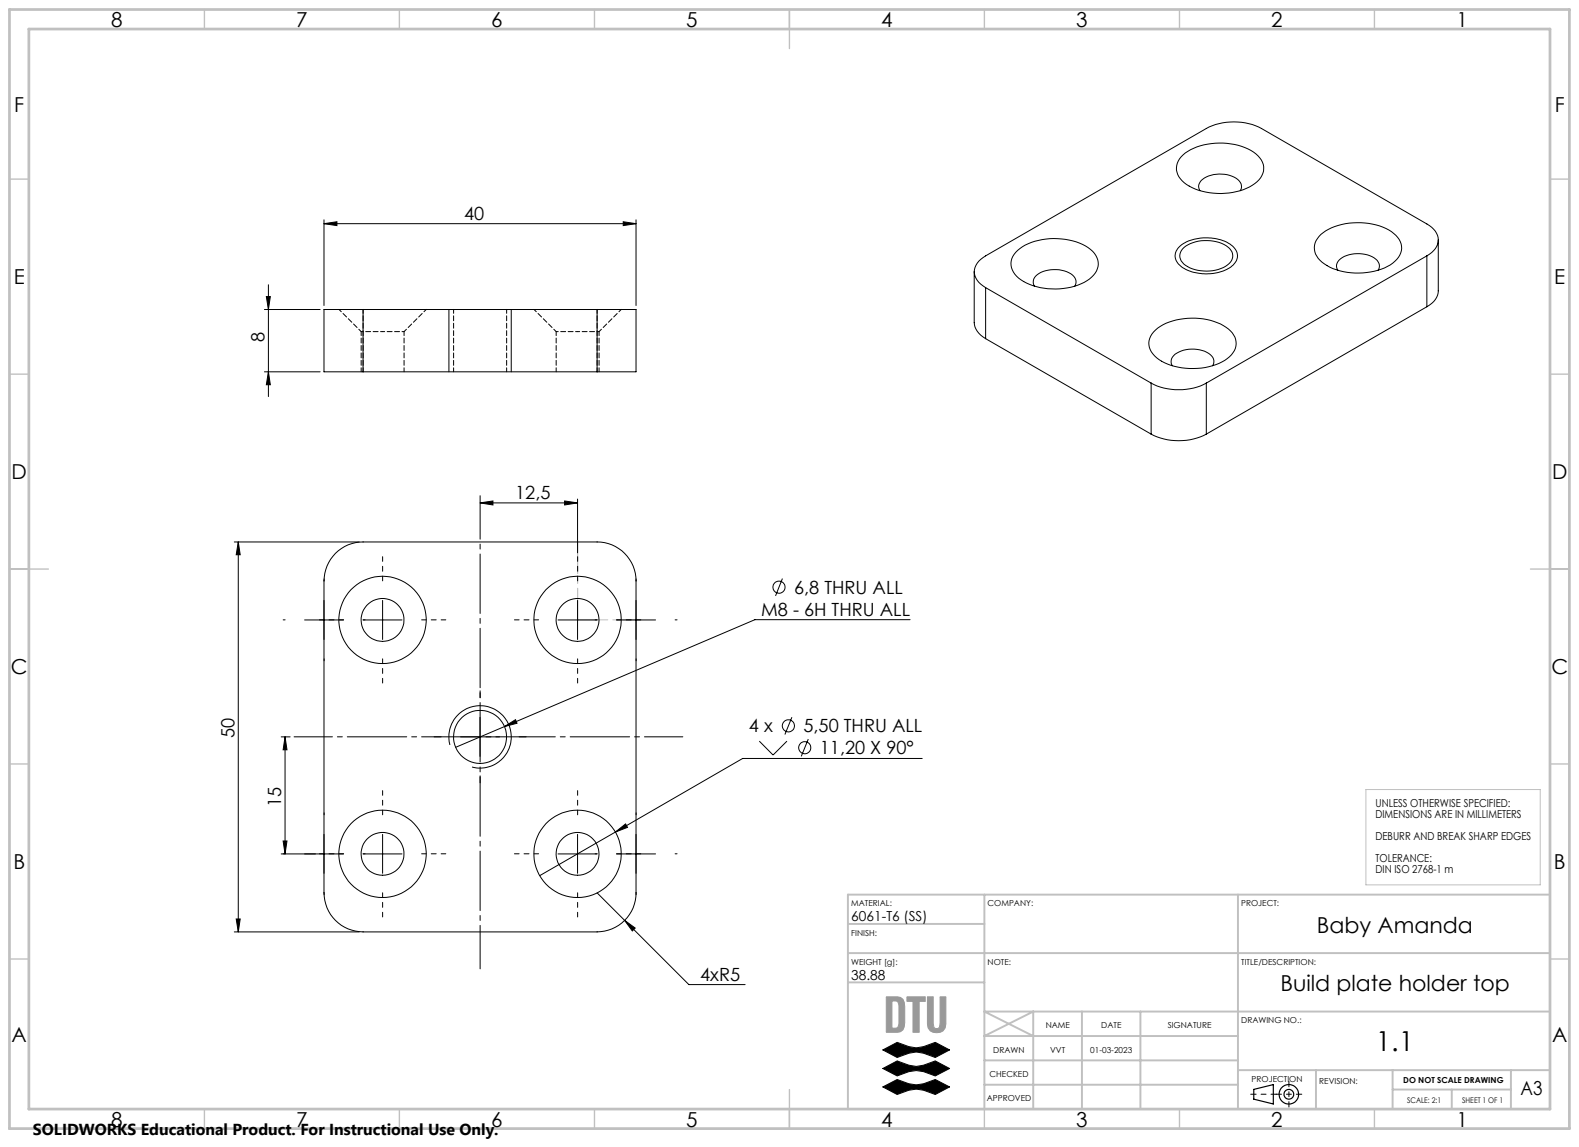
[picture p75: page 1]
6,8 THRU ALL M8 - 6H THRU ALL; 5,50 THRU ALL; Build plate holder top; DRAWING NO.:; WEIGHT [g]:; SCALE: 2:1; SHEET 1 OF 1

UNLESS OTHERWISE SPECIFIED:
DIMENSIONS ARE IN MILLIMETERS
DEBURR AND BREAK SHARP EDGES
TOLERANCE:
DIN ISO 2768-1 m
Baby Amanda

A3 DO NOT SCALE DRAWING

SOLIDWORKS Educational Product. For Instructional Use Only.
