DTUOpenAM/OpenVPP/CAD/Exploded_view/Complete.drawing.pdf

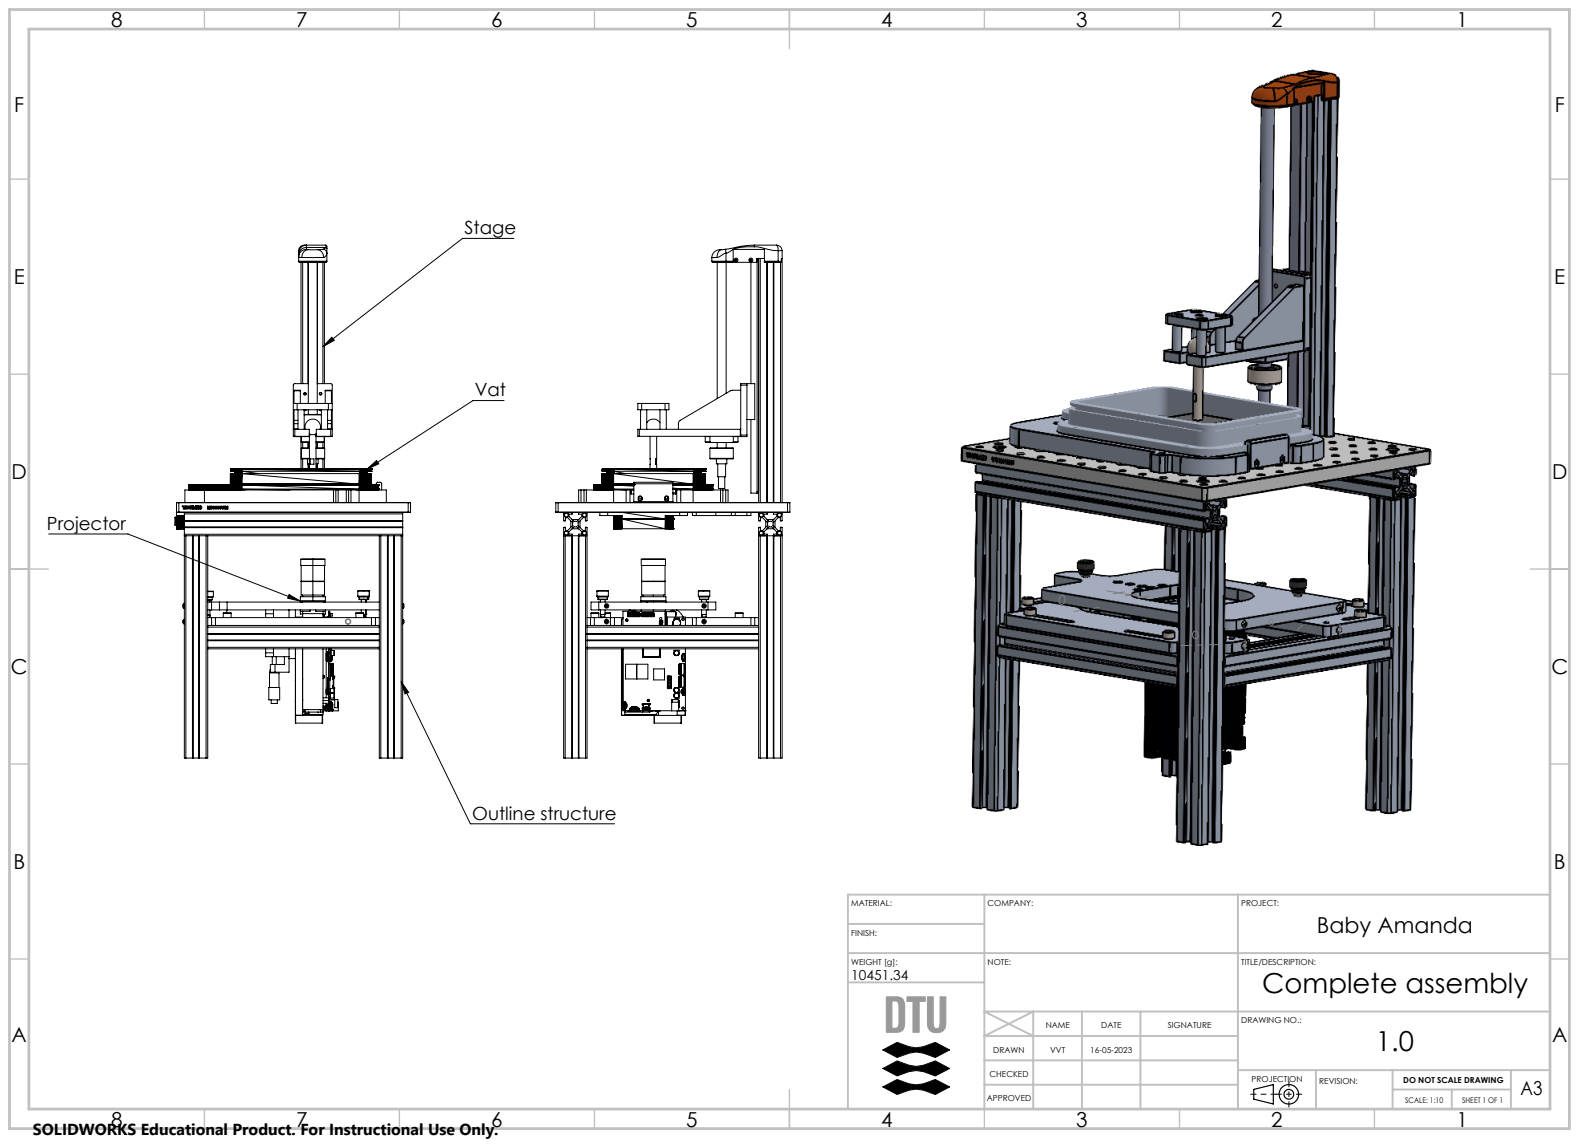
[picture p76: page 1]
Outline structure; Complete assembly; DRAWING NO.:; Baby Amanda; WEIGHT [g]:; SCALE: 1:10; SHEET 1 OF 1

A3 DO NOT SCALE DRAWING

SOLIDWORKS Educational Product. For Instructional Use Only.
