DTUOpenAM/OpenVPP/CAD/Exploded_view/Outline structure.exploded.pdf

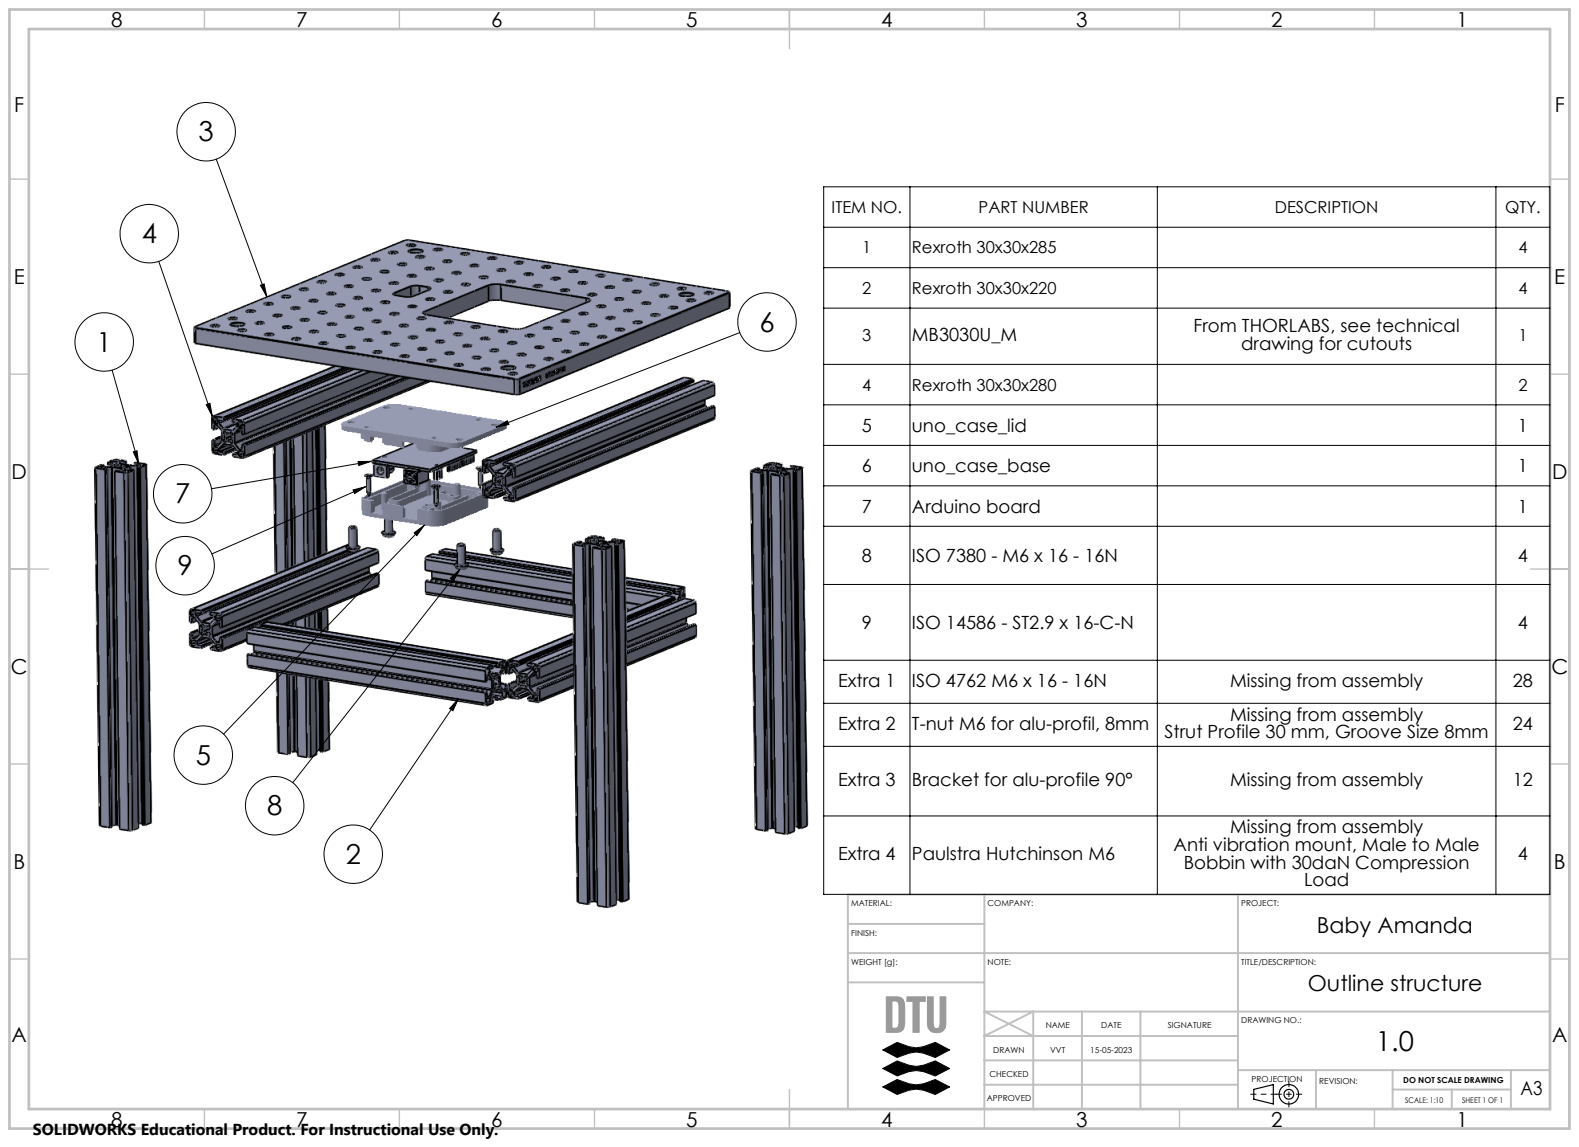
[picture p77: page 1]
Outline structure; DRAWING NO.:; Baby Amanda; WEIGHT [g]:; SCALE: 1:10; SHEET 1 OF 1

ITEM NO. | PART NUMBER | DESCRIPTION | QTY.
1 | Rexroth 30x30x285 | | 4
2 | Rexroth 30x30x220 | | 4
3 | MB3030U_M | From THORLABS, see technical drawing for cutouts | 1

4 | Rexroth 30x30x280 | | 2
5 | uno_case_lid | | 1
6 | uno_case_base | | 1
7 | Arduino board | | 1

8 | ISO 7380 - M6 x 16 - 16N | | 4

9 | ISO 14586 - ST2.9 x 16-C-N | | 4

Extra 1 | ISO 4762 M6 x 16 - 16N | Missing from assembly | 28
Extra 2 | T-nut M6 for alu-profil, 8mm | Missing from assembly Strut Profile 30 mm, Groove Size 8mm | 24

Extra 3 | Bracket for alu-profile 90° | Missing from assembly | 12

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

A3 DO NOT SCALE DRAWING

SOLIDWORKS Educational Product. For Instructional Use Only.
