DTUOpenAM/OpenVPP/CAD/Exploded_view/Stage_exploded.pdf

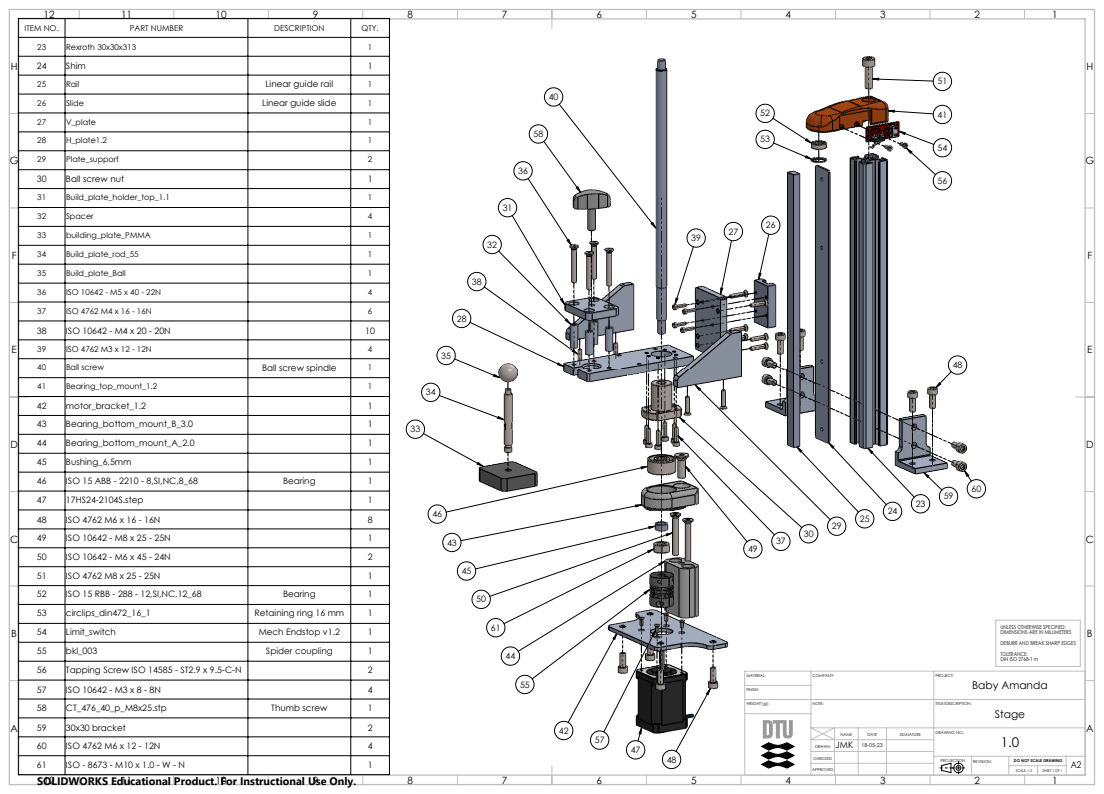
[picture p78: page 1]
ITEM NO.; PART NUMBER; DESCRIPTION; QTY.; Rexroth 30x30x313; Rail; Linear guide rail; Slide; Linear guide slide; Ball screw nut; ISO 10642 - M5 x 40 - 22N; ISO 4762 M4 x 16 - 16N; ISO 10642 - M4 x 20 - 20N; ISO 4762 M3 x 12 - 12N; Ball screw; Ball screw spindle; ISO 15 ABB - 2210 - 8,SI,NC,8_68; Bearing; ISO 4762 M6 x 16 - 16N; ISO 10642 - M8 x 25 - 25N; ISO 10642 - M6 x 45 - 24N; ISO 4762 M8 x 25 - 25N; ISO 15 RBB - 288 - 12,SI,NC,12_68; circlips_din472_16_1; Retaining ring 16 mm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

SOLIDWORKS Educational Product. For Instructional Use Only.

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

A2 DO NOT SCALE DRAWING
