DTUOpenAM/OpenVPP/CAD/Technical_drawings/30x30 bracket.pdf

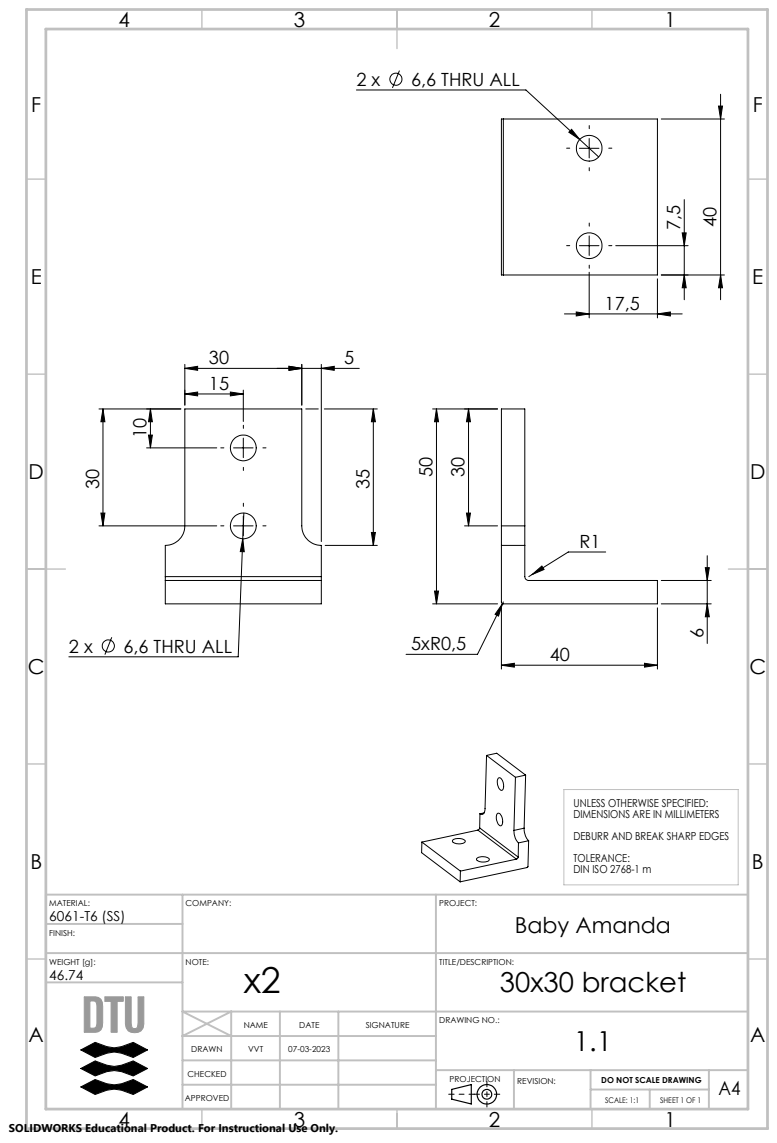
[picture p79: page 1]
6,6 THRU ALL 10; 6,6 THRU ALL; 30x30 bracket; DRAWING NO.:; WEIGHT [g]:; SCALE: 1:1; SHEET 1 OF 1

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

A4 DO NOT SCALE DRAWING

SOLIDWORKS Educational Product. For Instructional Use Only.
