DTUOpenAM/OpenVPP/CAD/Technical_drawings/baseVAT_1.2.pdf

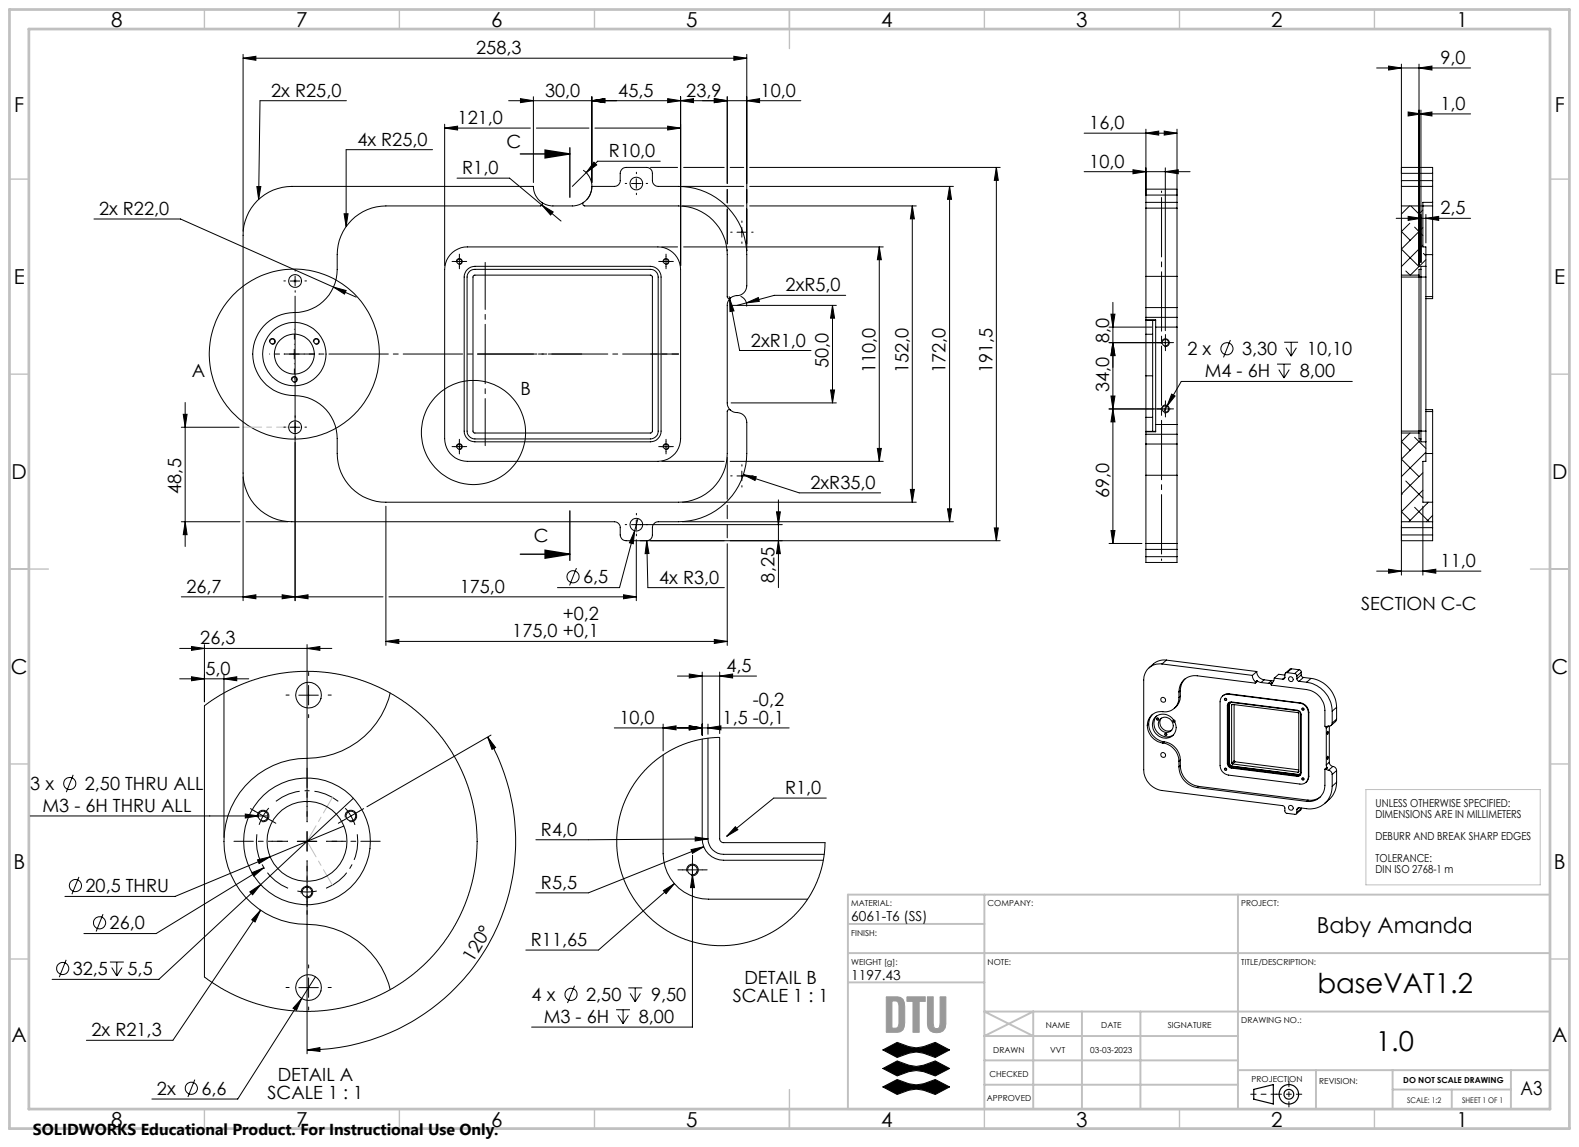
[picture p80: page 1]
20,5 THRU; 2,50 THRU ALL; M3 - 6H THRU ALL; DETAIL A SCALE 1 : 1; DETAIL B SCALE 1 : 1; SECTION C-C; DRAWING NO.:; WEIGHT [g]:; SCALE: 1:2; SHEET 1 OF 1

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

A3 DO NOT SCALE DRAWING

SOLIDWORKS Educational Product. For Instructional Use Only.
