DTUOpenAM/OpenVPP/CAD/Technical_drawings/H_plate_1.2.pdf

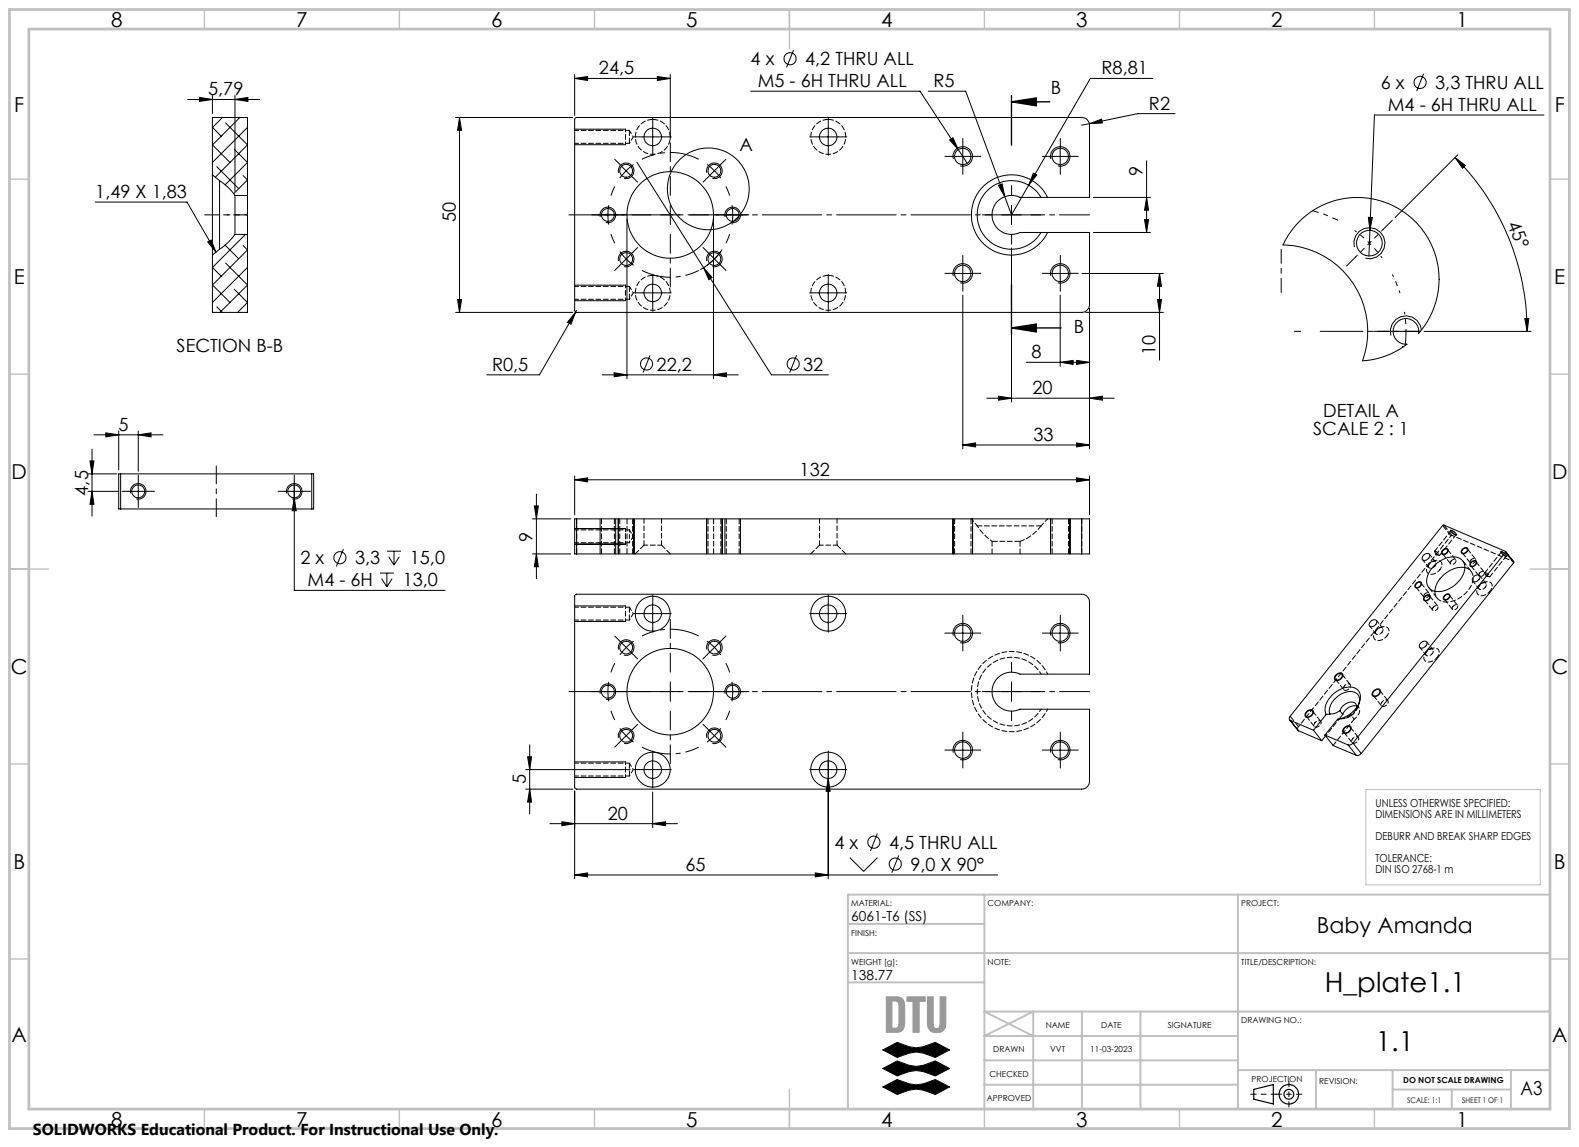
[picture p81: page 1]
4,2 THRU ALL; M5 - 6H THRU ALL; 4,5 THRU ALL; 3,3 THRU ALL; M4 - 6H THRU ALL; DETAIL A SCALE 2 : 1; SECTION B-B; DRAWING NO.:; WEIGHT [g]:; SCALE: 1:1; SHEET 1 OF 1

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

A3 DO NOT SCALE DRAWING

SOLIDWORKS Educational Product. For Instructional Use Only.
