DTUOpenAM/OpenVPP/CAD/Technical_drawings/spændeskive-laser.pdf

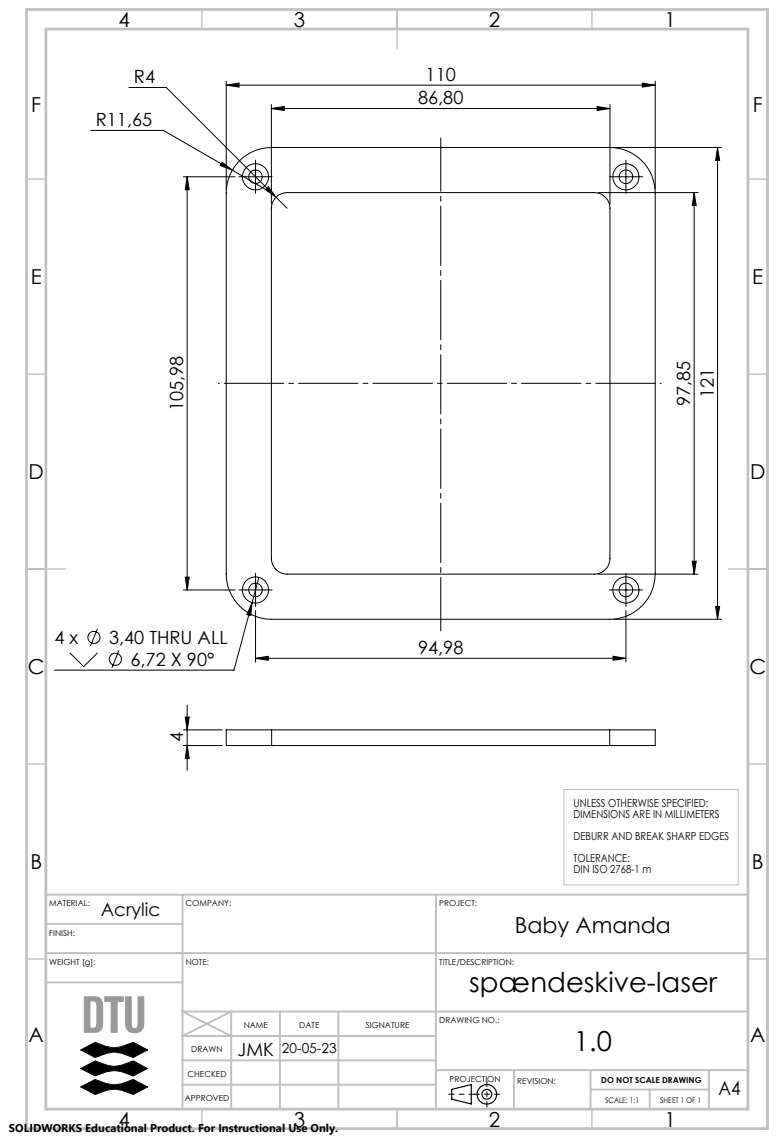
[picture p82: page 1]
3,40 THRU ALL; DRAWING NO.:; WEIGHT [g]:; SCALE: 1:1; SHEET 1 OF 1; JMK 20-05-23

UNLESS OTHERWISE SPECIFIED:
DIMENSIONS ARE IN MILLIMETERS
DEBURR AND BREAK SHARP EDGES
TOLERANCE:
DIN ISO 2768-1 m
Baby Amanda
spændeskive-laser

A4 DO NOT SCALE DRAWING

SOLIDWORKS Educational Product. For Instructional Use Only.
