DTUOpenAM/OpenVPP/CAD/Technical_drawings/Technical_drawings.pdf

# Stage

E | E

Vat; Projector; Outline structure; Complete assembly; PROJECT:; PROJECTION; REVISION:; DRAWING NO.:; TITLE/DESCRIPTION:; DRAWN; Baby Amanda; VVT; NAME; DATE; SIGNATURE; APPROVED; CHECKED; NOTE:; COMPANY:; WEIGHT [g]:; MATERIAL:; FINISH:; SCALE: 1:10; SHEET 1 OF 1

A3 DO NOT SCALE DRAWING

SOLIDWORKS Educational Product. For Instructional Use Only.

3

4

Outline structure; PROJECT:; DRAWING NO.:; TITLE/DESCRIPTION:; Baby Amanda; VVT; NAME; DATE; SIGNATURE; NOTE:; COMPANY:; WEIGHT [g]:; MATERIAL:; FINISH:; SCALE: 1:10; SHEET 1 OF 1

ITEM NO. | PART NUMBER | DESCRIPTION | QTY.
1 | Rexroth 30x30x285 | | 4
2 | Rexroth 30x30x220 | | 4
3 | MB3030U_M | From THORLABS, see technical drawing for cutouts | 1

4 | Rexroth 30x30x280 | | 2
5 | uno_case_lid | | 1
6 | uno_case_base | | 1
7 | Arduino board | | 1

8 | ISO 7380 - M6 x 16 - 16N | | 4

9 | ISO 14586 - ST2.9 x 16-C-N | | 4

Extra 1 | ISO 4762 M6 x 16 - 16N | Missing from assembly | 28
Extra 2 | T-nut M6 for alu-profil, 8mm | Missing from assembly Strut Profile 30 mm, Groove Size 8mm | 24

Extra 3 | Bracket for alu-profile 90° | Missing from assembly | 12

Extra 4 | Paulstra Hutchinson M6 | Missing from assembly Anti vibration mount, Male to Male Bobbin with 30daN Compression Load | 4

21

18

ISO 10642 - M3 x 12 - 12N; Vat assembly; PROJECT:; DRAWING NO.:; TITLE/DESCRIPTION:; Baby Amanda; VVT; NAME; DATE; SIGNATURE; NOTE:; COMPANY:; WEIGHT [g]:; MATERIAL:; FINISH:; SCALE: 1:1; SHEET 1 OF 1

ITEM NO. | PART NUMBER | DESCRIPTION | QTY.
10 | baseVAT1.2 | | 1
11 | Glass | | 1
12 | Vat_bracket_1.1 | | 1
13 | Vat_bottom | | 1
14 | Membrane_stretcher | | 1
15 | Vat_top | | 1
16 | spændeskive-laser | | 1

17 | ISO 4762 M3 x 12 - 12N | | 2

18 | ISO 4762 M4 x 8 - 8N | | 4

19 | ISO 4762 M6 x 25 - 25N | | 4

20 | ISO 4762 M3 x 5 - 5N | | 3

21 | qcth0834-20-sus | Quater Turn Lock from IMAO | 1

Extra 5 | M3 x 8 with special grip on the head | Missing from assembly for Vat_top | 4

Extra 6 | CAM receptable QCTH-N | Missing from assembly counterpart to lock from IMAO | 1

Extra 7 | O-ring, nitrile, 1.5mm Diam. | Missing from assembly | 1

A2 DO NOT SCALE DRAWING

52 | 41
| 51

ITEM NO.; PART NUMBER; DESCRIPTION; QTY.; Rexroth 30x30x313; Shim; Rail; Linear guide rail; Slide; Linear guide slide; V_plate; H_plate1.2; Plate_support; Ball screw nut; Build_plate_holder_top_1.1; Spacer; building_plate_PMMA; Build_plate_rod_55; Build_plate_Ball; ISO 10642 - M5 x 40 - 22N; ISO 4762 M4 x 16 - 16N; ISO 10642 - M4 x 20 - 20N; ISO 4762 M3 x 12 - 12N; Ball screw; Ball screw spindle; Bearing_top_mount_1.2; motor_bracket_1.2; Bearing_bottom_mount_B_3.0; Bearing_bottom_mount_A_2.0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

UNLESS OTHERWISE SPECIFIED:
DIMENSIONS ARE IN MILLIMETERS
DEBURR AND BREAK SHARP EDGES
TOLERANCE:
DIN ISO 2768-1 m
Baby Amanda

A2 DO NOT SCALE DRAWING

77 | 66 | 75 76 71 | 65 | 70 | 64
G | G

Projector Assembly; PROJECT:; DRAWING NO.:; TITLE/DESCRIPTION:; Baby Amanda; NAME; DATE; SIGNATURE; NOTE:; COMPANY:; WEIGHT [g]:; MATERIAL:; FINISH:; SCALE: 1:2; SHEET 1 OF 1

ITEM NO. | PART NUMBER | DESCRIPTION | QTY.
62 | Projector_BASE_Bottom | | 1
63 | M6x0.25 Differential screw | | 3
64 | PRO4500_STP_20150716 | DLP-Lightcrafter 4500 | 1
65 | Projector_sandwich | | 1
66 | Projector_bracket | | 1
67 | Projector_bracket_support | | 1
68 | Projector_BASE_Top | | 1
69 | ISO 10642 - M4 x 16 - 16N | | 8
70 | ISO 10642 - M4 x 12 - 12N | | 6
71 | ISO 10642 - M3 x 16 - 16N | | 4
72 | ISO 4762 M6 x 16 - 16N | | 8
72 | ISO 7380 - M3 x 12 - 12N | | 6
74 | Pull Spring E01800220620S | | 3
75 | Linear stage roller | | 1
76 | Micrometer screw | | 1
77 | ISO 4762 M4 x 12 - 12N | | 4

A2 DO NOT SCALE DRAWING

R5

E | E

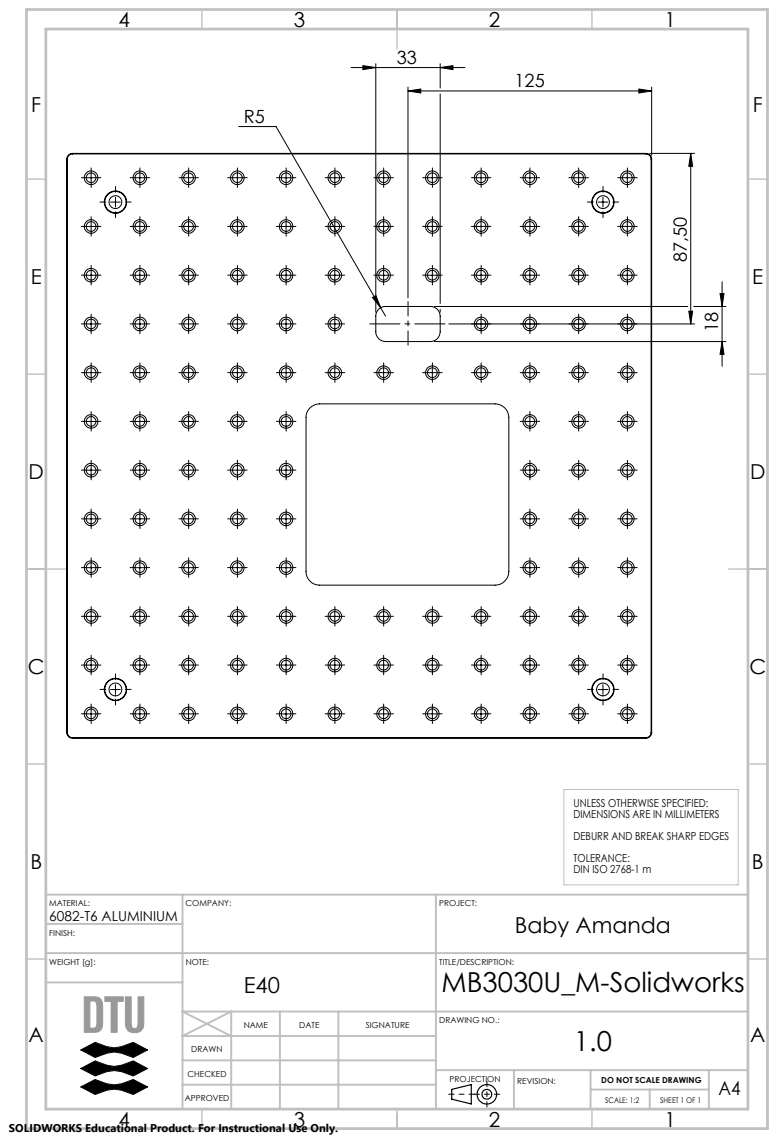
[picture p83: page 6]
MB3030U_M-Solidworks; PROJECT:; DRAWING NO.:; TITLE/DESCRIPTION:; DRAWN; NAME; DATE; SIGNATURE; NOTE:; COMPANY:; WEIGHT [g]:; MATERIAL:; FINISH:; 6082-T6 ALUMINIUM; SCALE: 1:2; SHEET 1 OF 1

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

A4 DO NOT SCALE DRAWING

2xR5,0

121,0

20,5 THRU; 2,50 THRU ALL; M3 - 6H THRU ALL; DETAIL A SCALE 1 : 1; DETAIL B SCALE 1 : 1; SECTION C-C; baseVAT1.2; PROJECT:; DRAWING NO.:; TITLE/DESCRIPTION:; VVT; NAME; DATE; SIGNATURE; NOTE:; COMPANY:; WEIGHT [g]:; MATERIAL:; FINISH:; SCALE: 1:2; SHEET 1 OF 1

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

7

R2

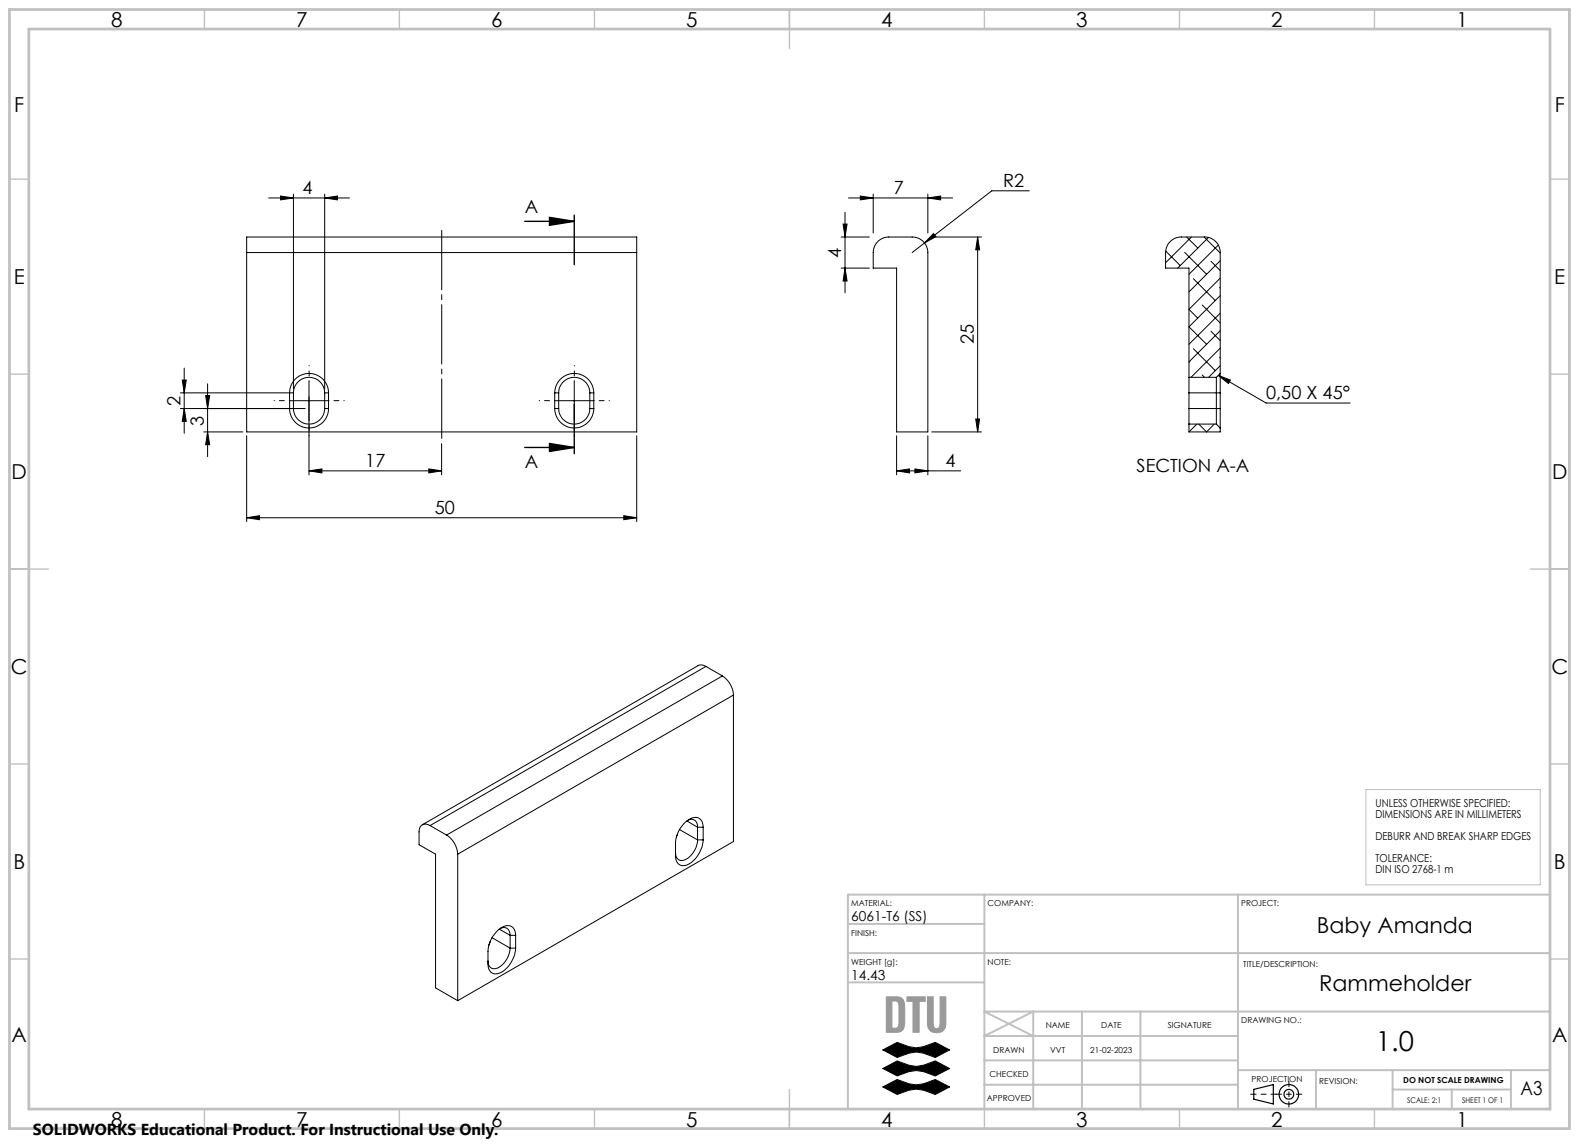
[picture p84: page 8]
SECTION A-A; Rammeholder; PROJECT:; DRAWING NO.:; TITLE/DESCRIPTION:; VVT; NAME; DATE; SIGNATURE; NOTE:; COMPANY:; WEIGHT [g]:; MATERIAL:; FINISH:; SCALE: 2:1; SHEET 1 OF 1

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

86,80
R11,65

3,40 THRU ALL; PROJECT:; DRAWING NO.:; TITLE/DESCRIPTION:; DRAWN; NAME; DATE; SIGNATURE; NOTE:; COMPANY:; WEIGHT [g]:; MATERIAL:; FINISH:; SCALE: 1:1; SHEET 1 OF 1; JMK 20-05-23; Acrylic

UNLESS OTHERWISE SPECIFIED:
DIMENSIONS ARE IN MILLIMETERS
DEBURR AND BREAK SHARP EDGES
TOLERANCE:
DIN ISO 2768-1 m
Baby Amanda
spændeskive-laser

A4 DO NOT SCALE DRAWING

2

26

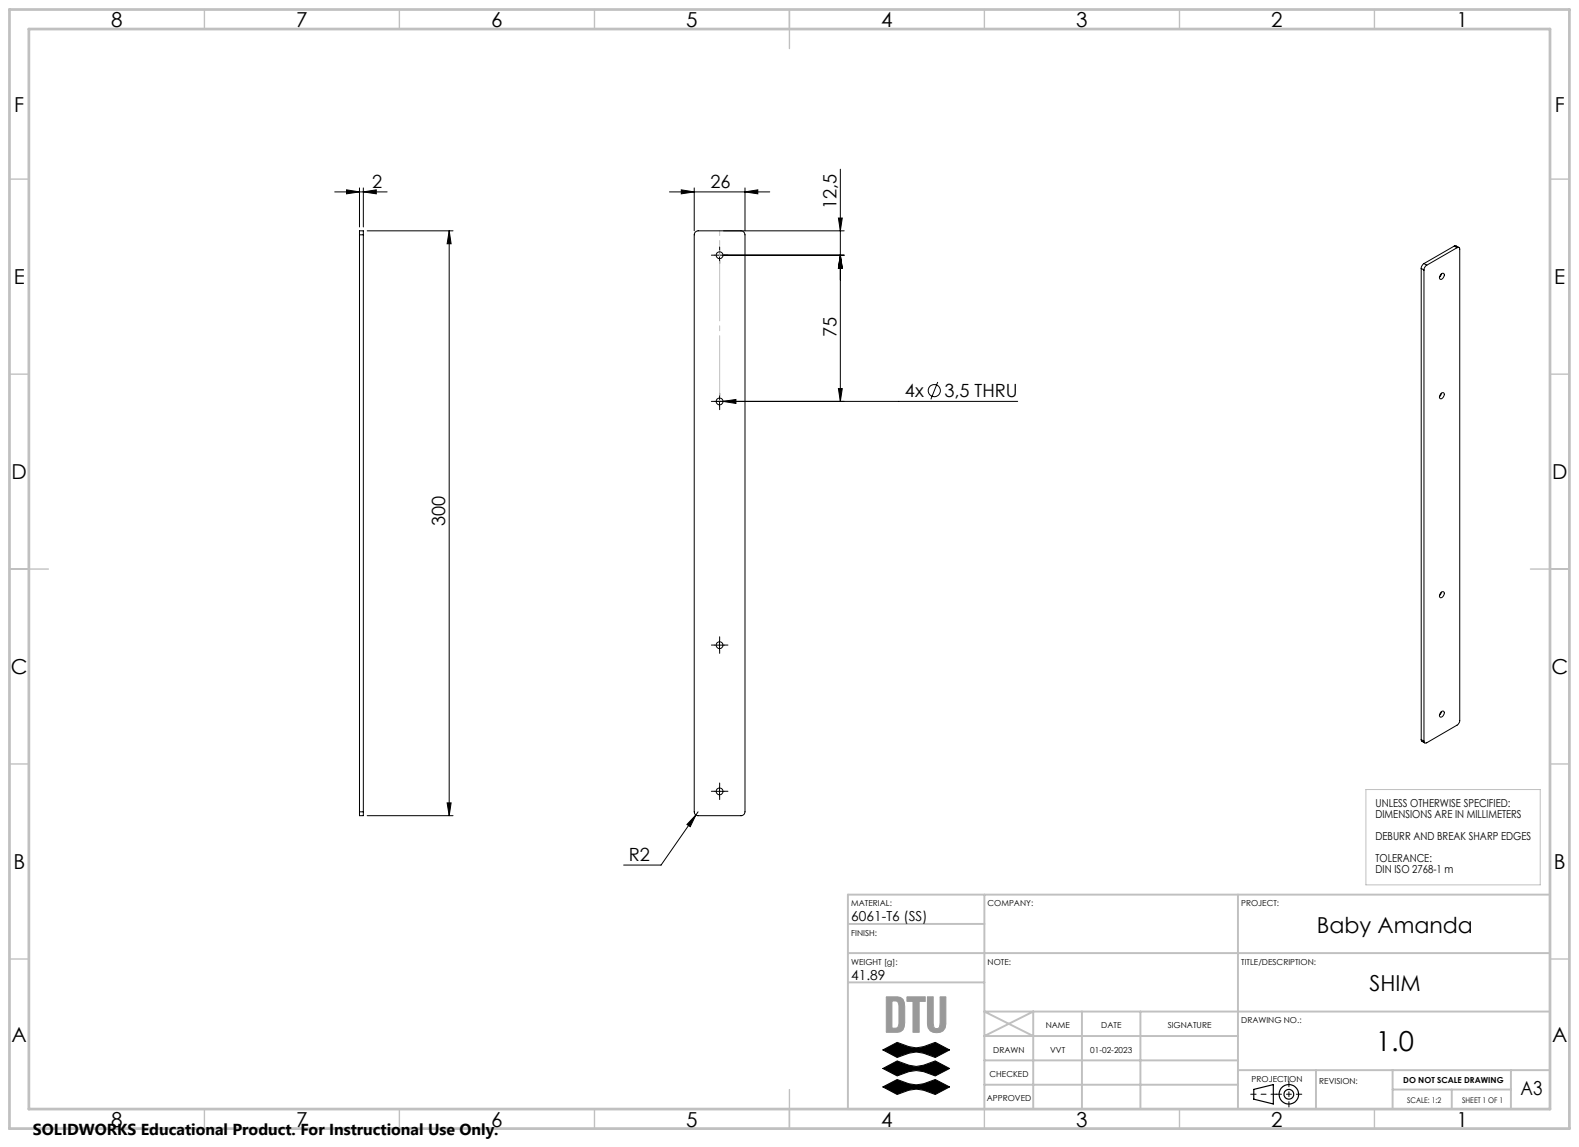
[picture p85: page 10]
4x 3,5 THRU; SHIM; PROJECT:; DRAWING NO.:; TITLE/DESCRIPTION:; VVT; NAME; DATE; SIGNATURE; NOTE:; COMPANY:; WEIGHT [g]:; MATERIAL:; FINISH:; SCALE: 1:2; SHEET 1 OF 1

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

50

E | E

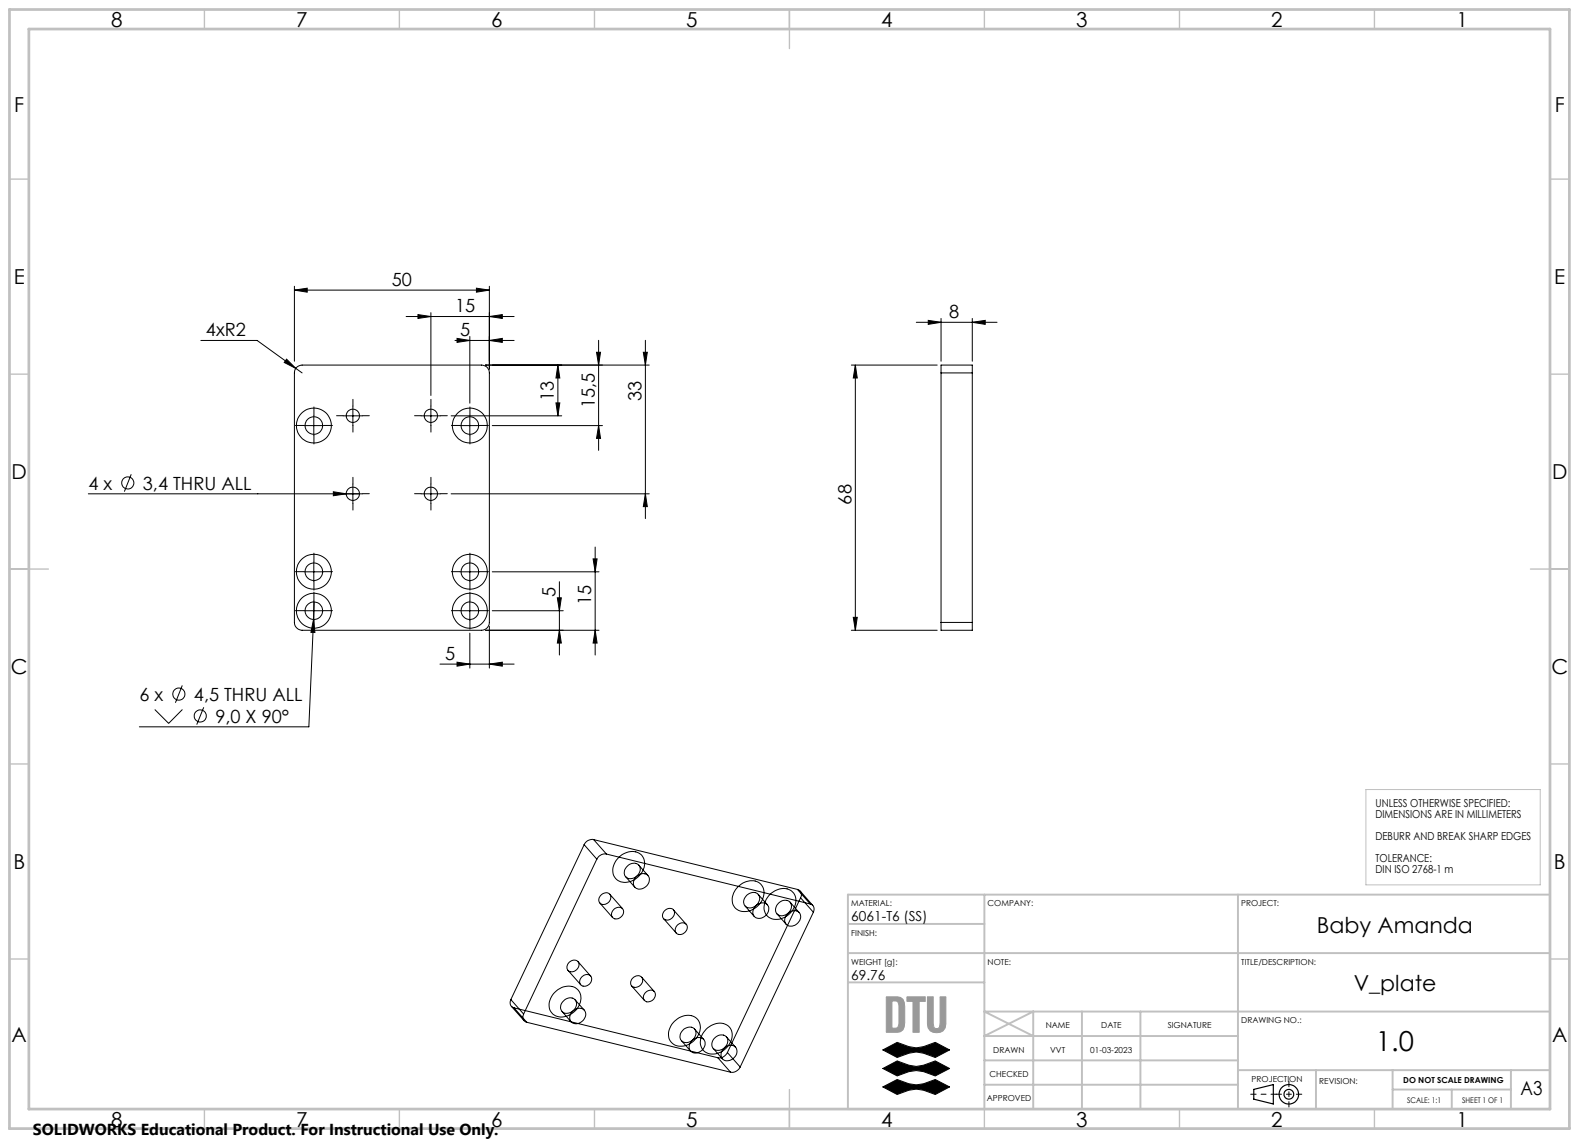
[picture p86: page 11]
4,5 THRU ALL; 3,4 THRU ALL; V_plate; PROJECT:; DRAWING NO.:; TITLE/DESCRIPTION:; VVT; NAME; DATE; SIGNATURE; NOTE:; COMPANY:; WEIGHT [g]:; MATERIAL:; FINISH:; SCALE: 1:1; SHEET 1 OF 1

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

24,5
R2

4,2 THRU ALL; M5 - 6H THRU ALL; 4,5 THRU ALL; 3,3 THRU ALL; M4 - 6H THRU ALL; DETAIL A SCALE 2 : 1; SECTION B-B; H_plate1.1; PROJECT:; DRAWING NO.:; TITLE/DESCRIPTION:; DRAWN; VVT; NAME; DATE; SIGNATURE; NOTE:; COMPANY:; WEIGHT [g]:; MATERIAL:; FINISH:; SCALE: 1:1; SHEET 1 OF 1

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

12 | 2xR5

# M4 - 6H 12,50 ⁶,5 6

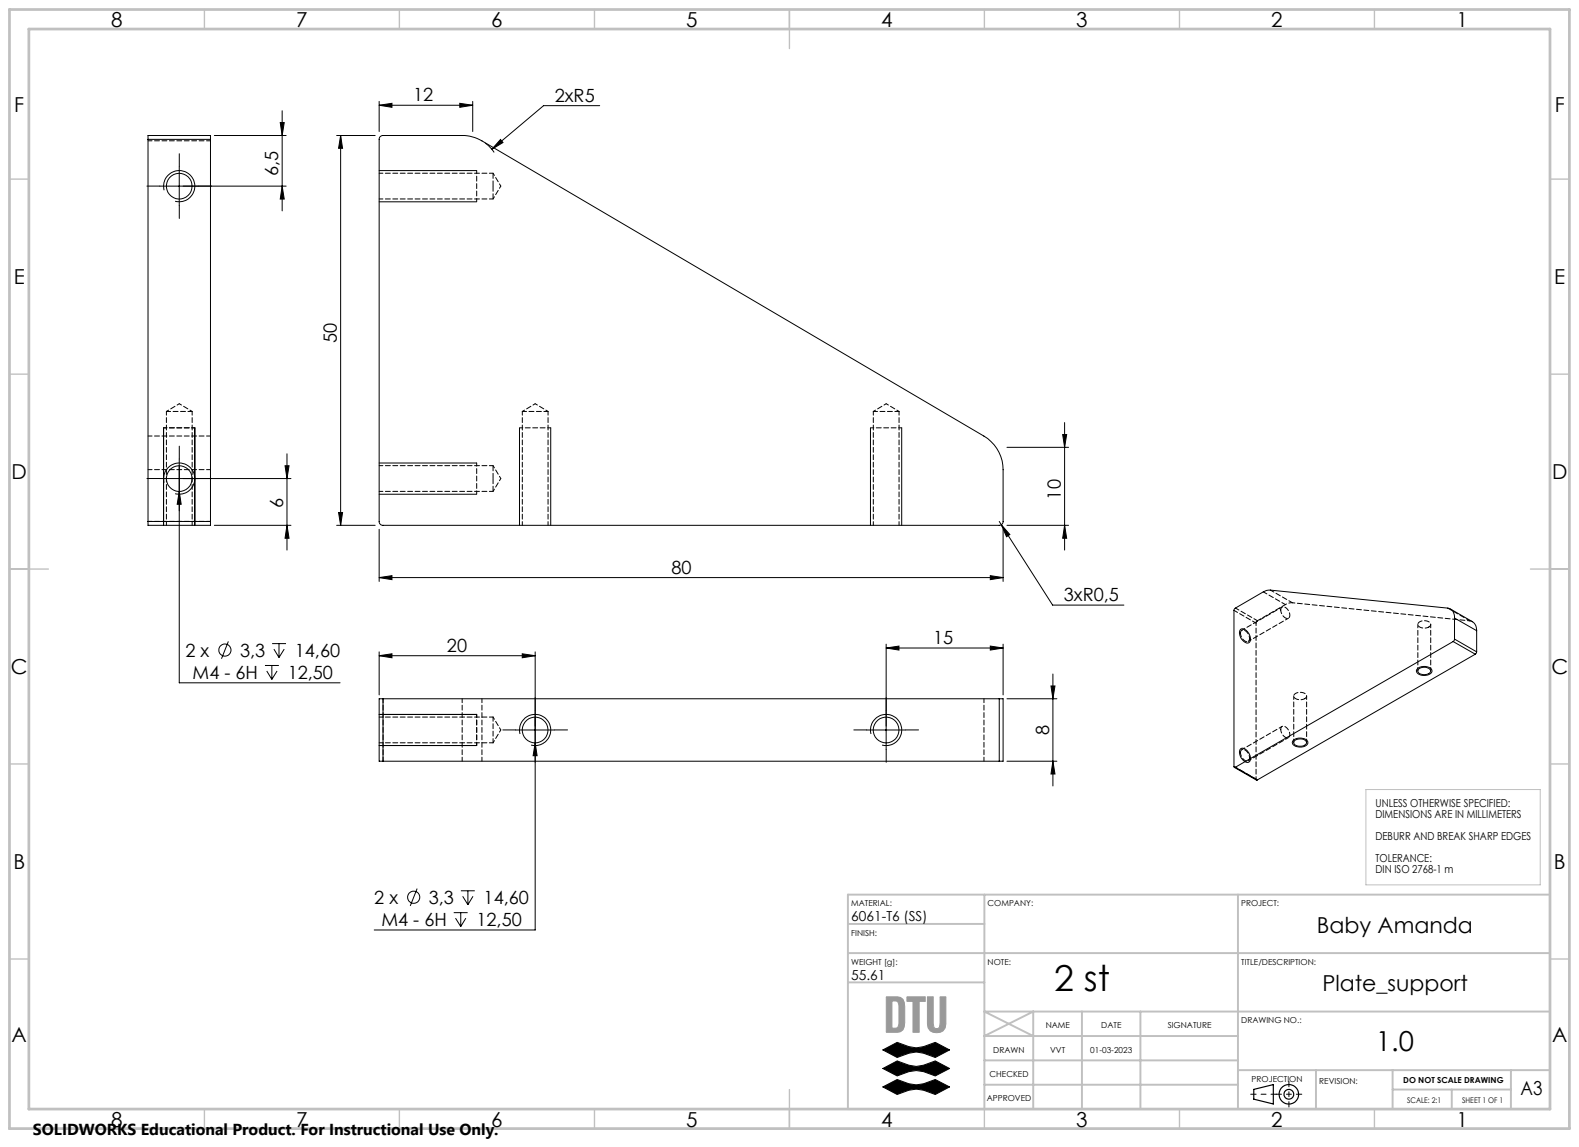
[picture p87: page 13]
Plate_support; PROJECT:; DRAWING NO.:; TITLE/DESCRIPTION:; VVT; NAME; DATE; SIGNATURE; NOTE:; COMPANY:; WEIGHT [g]:; MATERIAL:; FINISH:; SCALE: 2:1; SHEET 1 OF 1

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

40

E | E

6,8 THRU ALL M8 - 6H THRU ALL; 5,50 THRU ALL; Build plate holder top; PROJECT:; DRAWING NO.:; TITLE/DESCRIPTION:; VVT; NAME; DATE; SIGNATURE; NOTE:; COMPANY:; WEIGHT [g]:; MATERIAL:; FINISH:; SCALE: 2:1; SHEET 1 OF 1

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

E | E
F | F

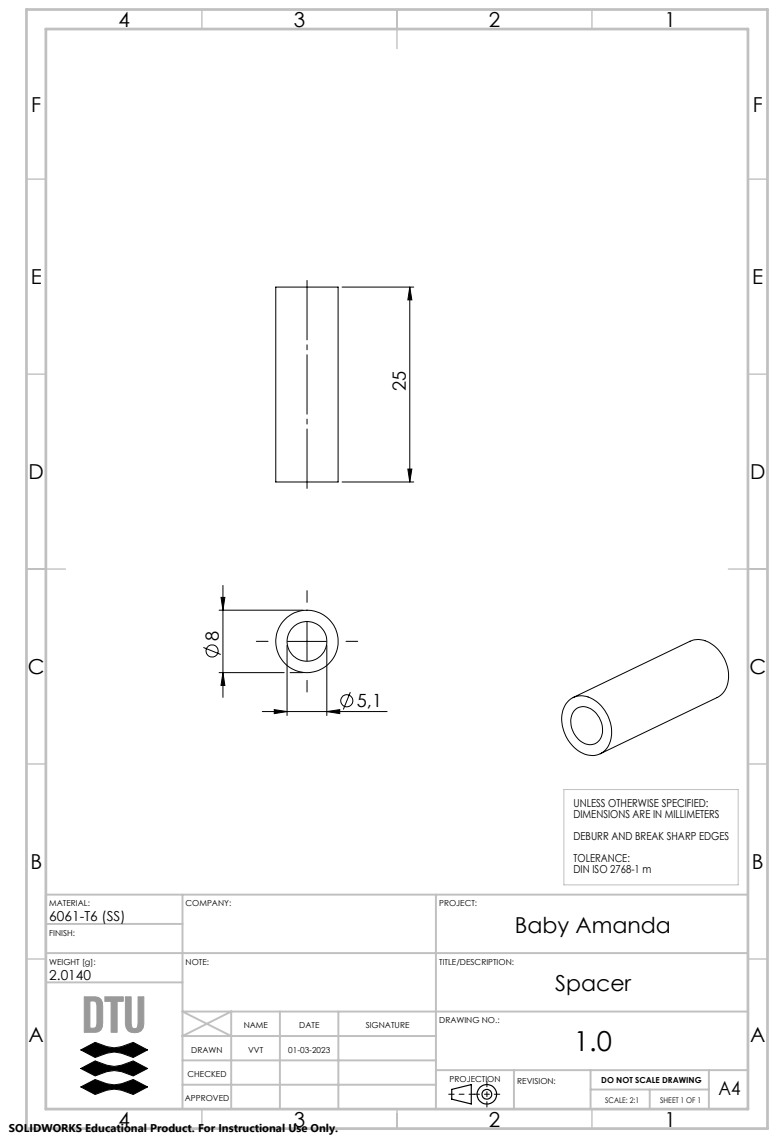
[picture p88: page 15]
Spacer; PROJECT:; DRAWING NO.:; TITLE/DESCRIPTION:; VVT; NAME; DATE; SIGNATURE; NOTE:; COMPANY:; WEIGHT [g]:; MATERIAL:; FINISH:; SCALE: 2:1; SHEET 1 OF 1

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

A4 DO NOT SCALE DRAWING

M6

8,50

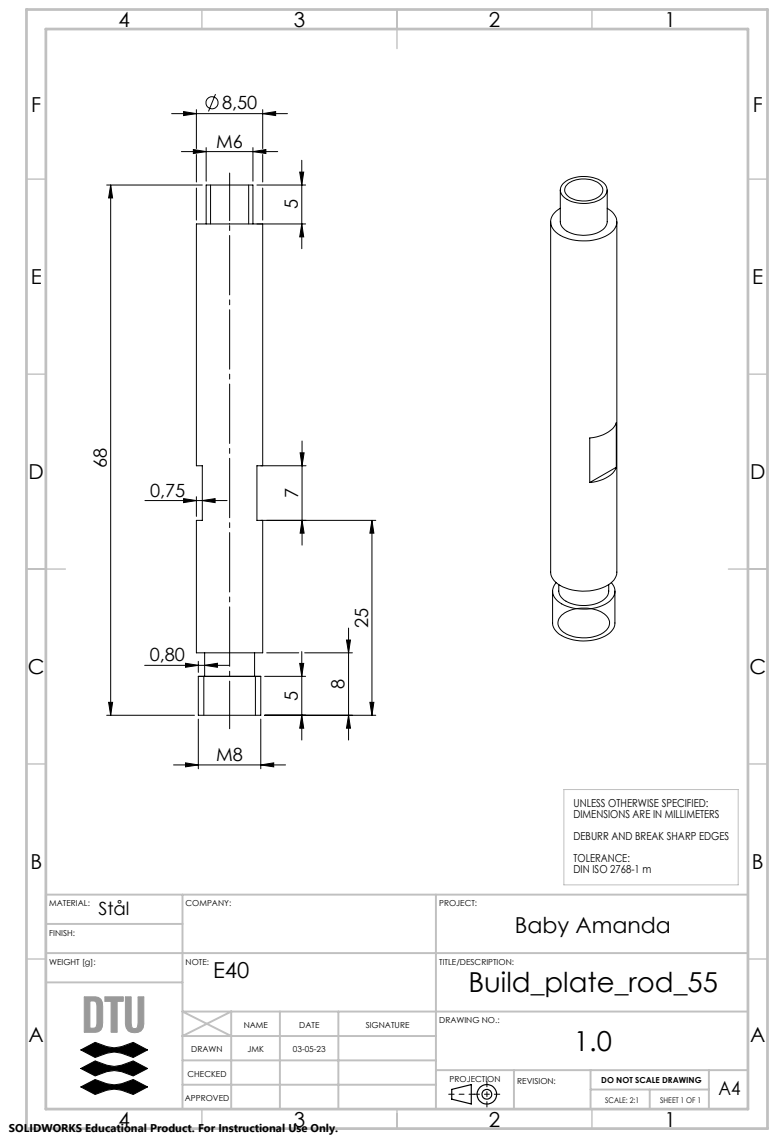
[picture p89: page 16]
Build_plate_rod_55; PROJECT:; DRAWING NO.:; TITLE/DESCRIPTION:; DRAWN; JMK; NAME; DATE; SIGNATURE; NOTE:; COMPANY:; WEIGHT [g]:; MATERIAL:; FINISH:; SCALE: 2:1; SHEET 1 OF 1; Stål

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

A4 DO NOT SCALE DRAWING

20 M6
E | E

FINISH; COMPANY; WEIGHT (g); SHEET 1 OF 1; SCALE:2:1; TITLE/DESCRIPTION; DRAWING NO; DATE; SIGNATURE; DRAWN; NAME; NOTE; ANNADA 27.02.2020

UNLESS OTHERWISE SPECIFIED:
DIMENSIONS ARE IN MILLIMETERS
DEBURR AND BREAK SHARP EDGES
TOLERANCE:
DIN ISO 2768-1 M
Build plate
Build plate - ball

MATERIAL
TECHNICAL UNIVERSITY OF DENMARK AISI 304

PROJECT
MICRO STAGE - ANNADA

E | E
F | F

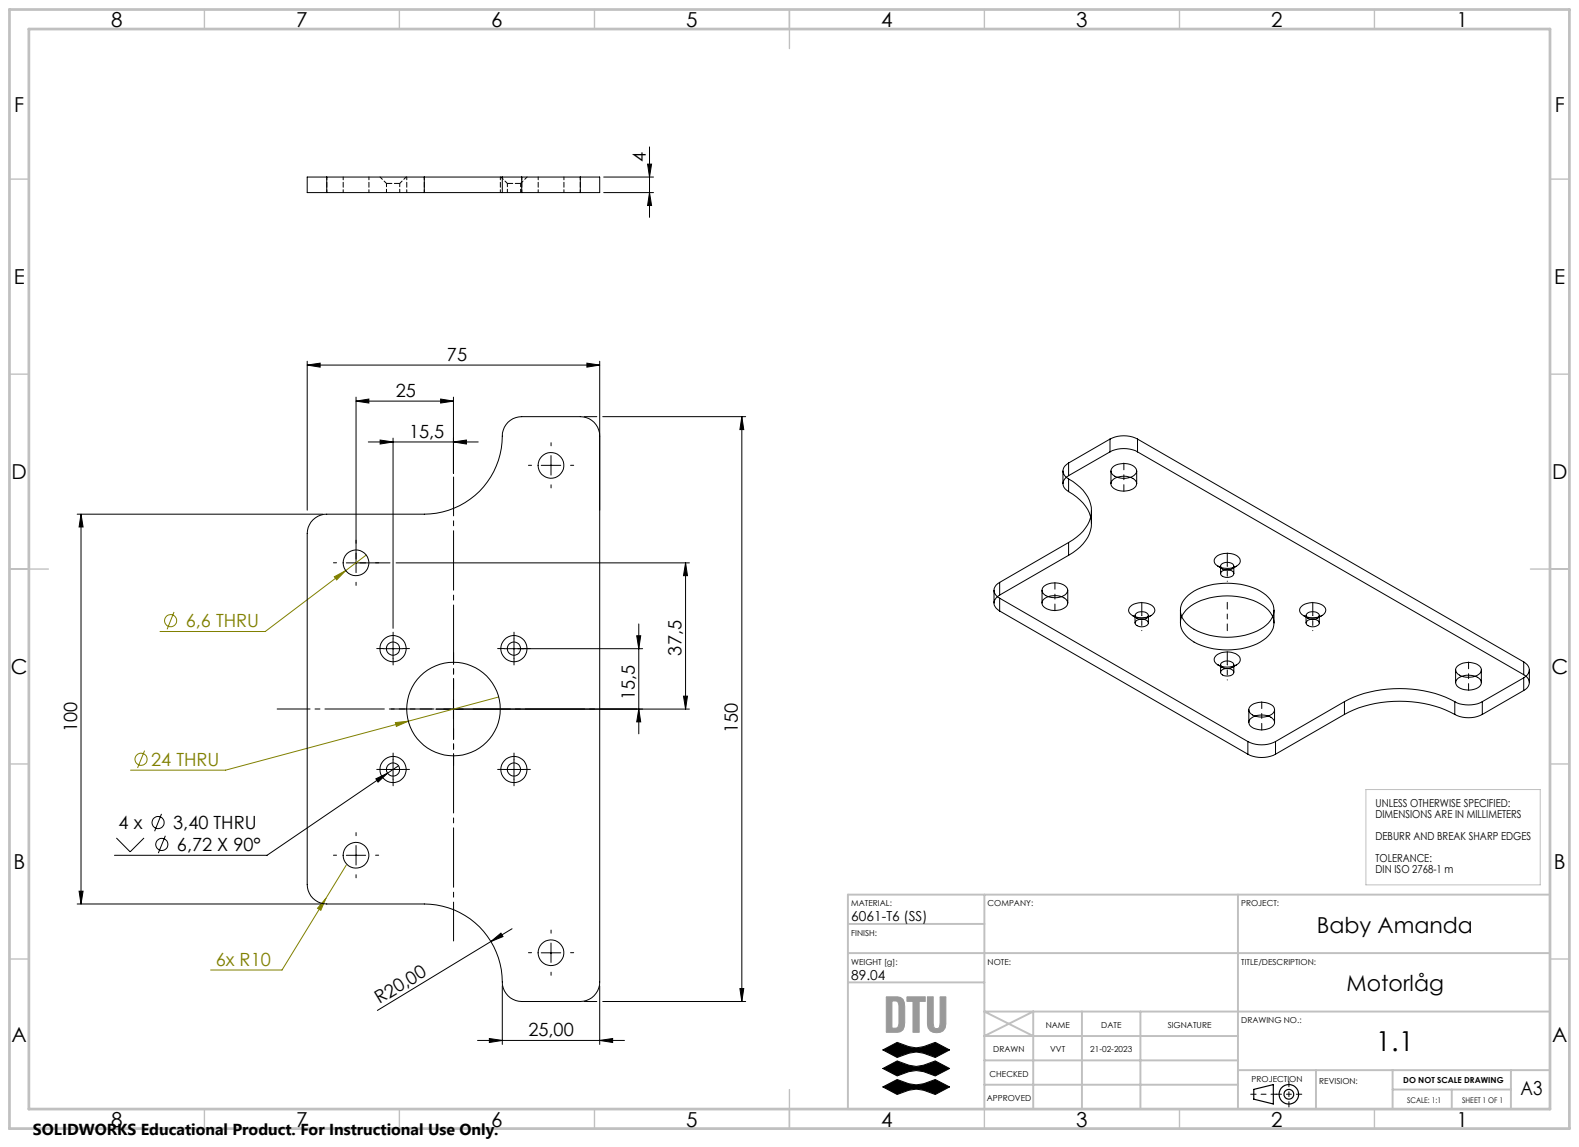
[picture p90: page 18]
24 THRU; 3,40 THRU; 6,6 THRU; Motorlåg; PROJECT:; DRAWING NO.:; TITLE/DESCRIPTION:; DRAWN; VVT; NAME; DATE; SIGNATURE; NOTE:; COMPANY:; WEIGHT [g]:; MATERIAL:; FINISH:; SCALE: 1:1; SHEET 1 OF 1

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

2 x | 6,6 THRU ALL
E | E

6,6 THRU ALL ¹⁰; 30x30 bracket; PROJECT:; DRAWING NO.:; TITLE/DESCRIPTION:; DRAWN; VVT; NAME; DATE; SIGNATURE; NOTE:; COMPANY:; WEIGHT [g]:; MATERIAL:; FINISH:; SCALE: 1:1; SHEET 1 OF 1

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

A4 DO NOT SCALE DRAWING

2,50 20,10
M3 - 6H 15,00

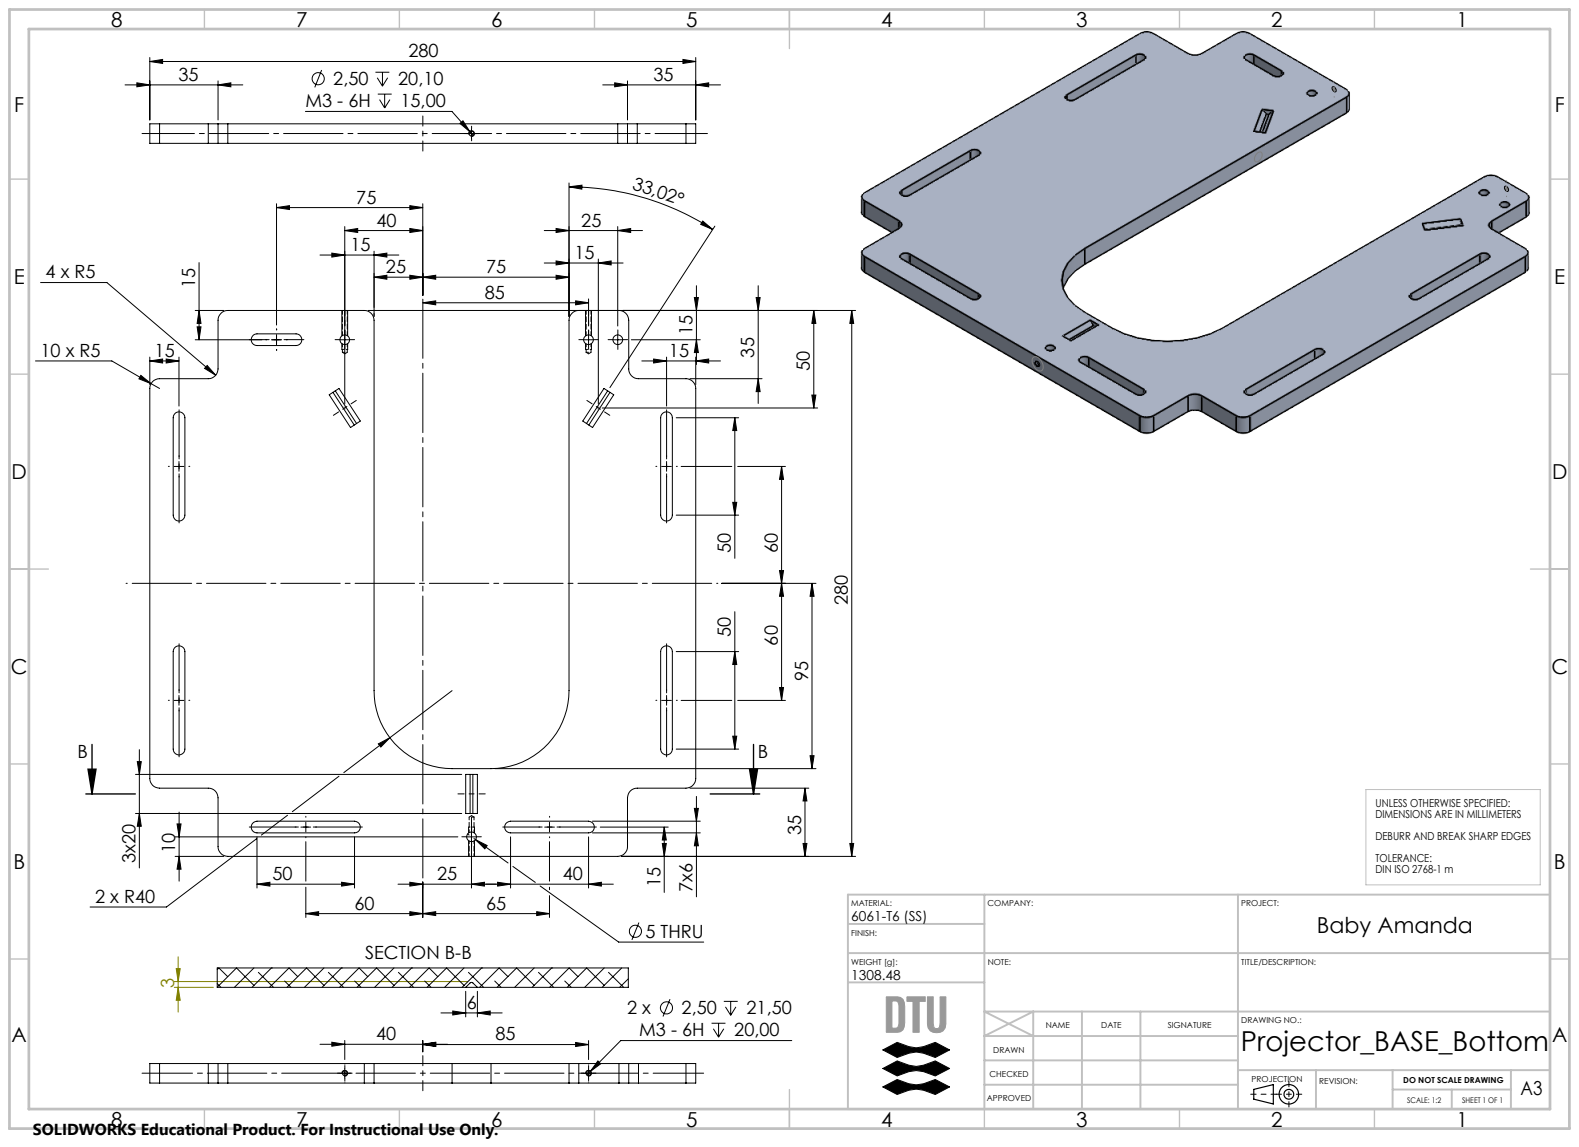
[picture p91: page 20]
5 THRU ¹⁵; SECTION B-B; PROJECT:; DRAWING NO.:; TITLE/DESCRIPTION:; NAME; DATE; SIGNATURE; NOTE:; COMPANY:; WEIGHT [g]:; MATERIAL:; FINISH:; SCALE: 1:2; SHEET 1 OF 1; Projector_BASE_Bottom

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

6

25

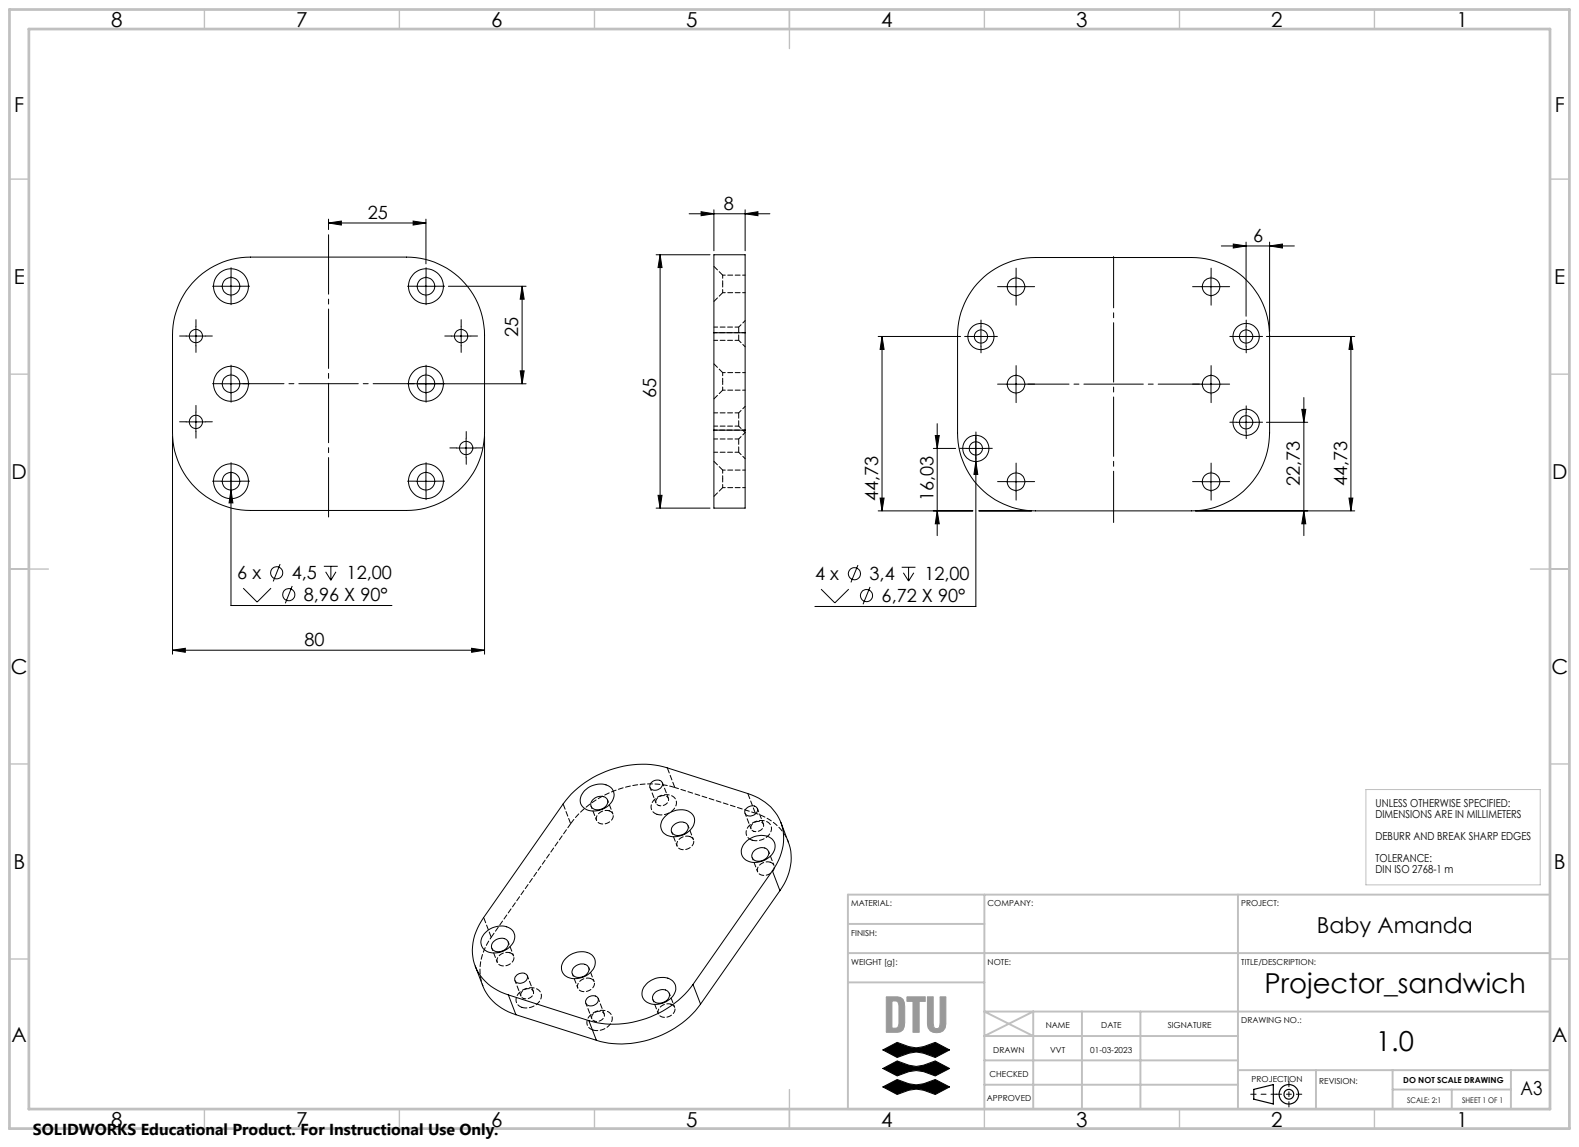
[picture p92: page 21]
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

UNLESS OTHERWISE SPECIFIED:
DIMENSIONS ARE IN MILLIMETERS
DEBURR AND BREAK SHARP EDGES
TOLERANCE:
DIN ISO 2768-1 m
Baby Amanda
Projector_sandwich

5

30

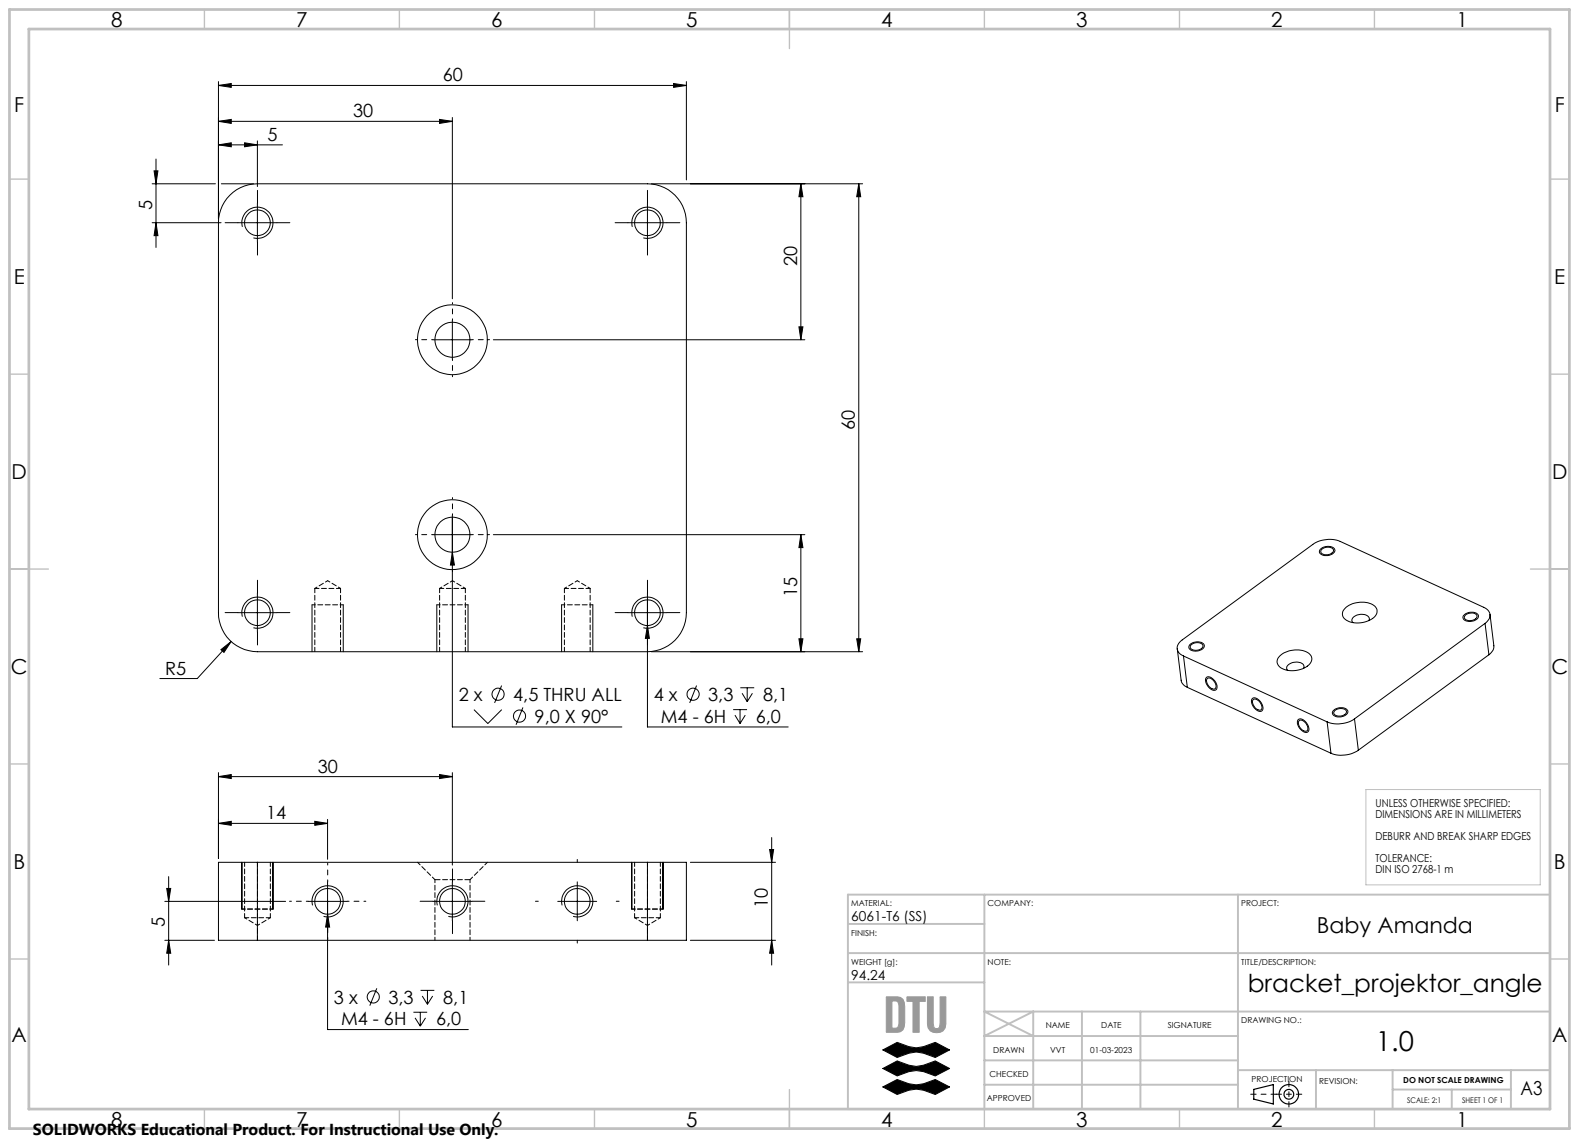
[picture p93: page 22]
4,5 THRU ALL; bracket_projektor_angle; PROJECT:; DRAWING NO.:; TITLE/DESCRIPTION:; VVT; NAME; DATE; SIGNATURE; NOTE:; COMPANY:; WEIGHT [g]:; MATERIAL:; FINISH:; SCALE: 2:1; SHEET 1 OF 1

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

18
2xR5

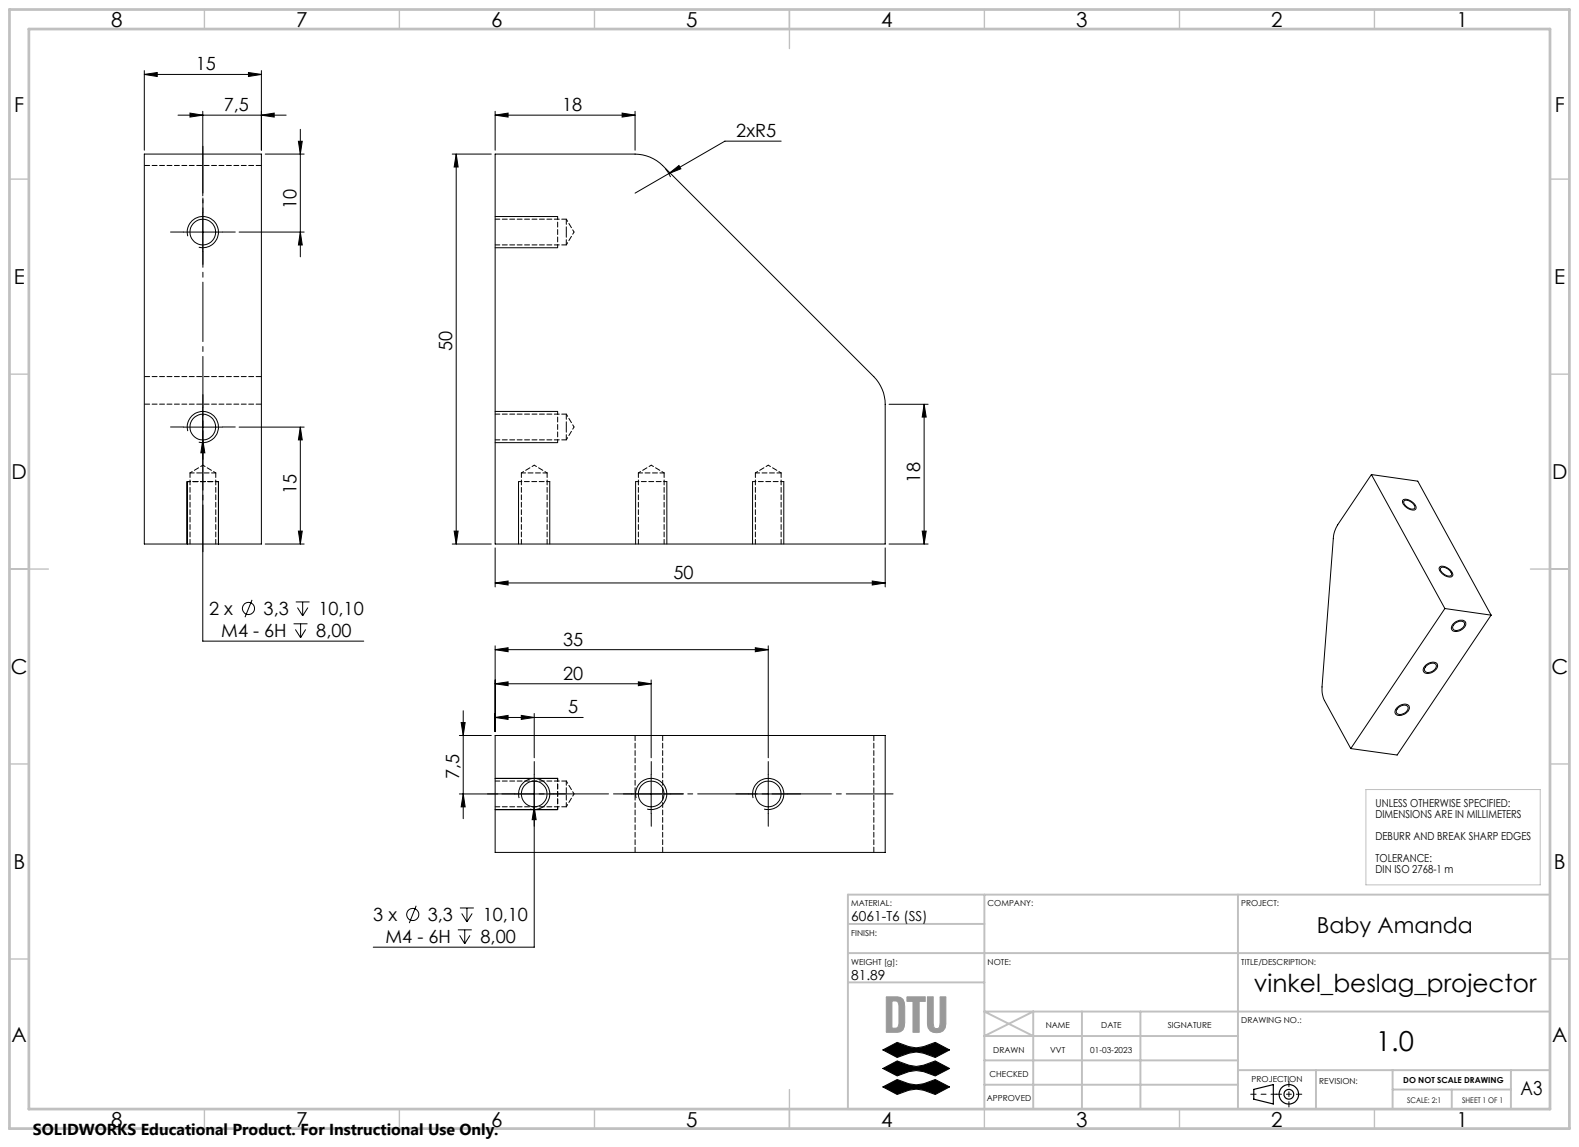
[picture p94: page 23]
vinkel_beslag_projector; PROJECT:; DRAWING NO.:; TITLE/DESCRIPTION:; VVT; NAME; DATE; SIGNATURE; NOTE:; COMPANY:; WEIGHT [g]:; MATERIAL:; FINISH:; SCALE: 2:1; SHEET 1 OF 1

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

64,35
54,35

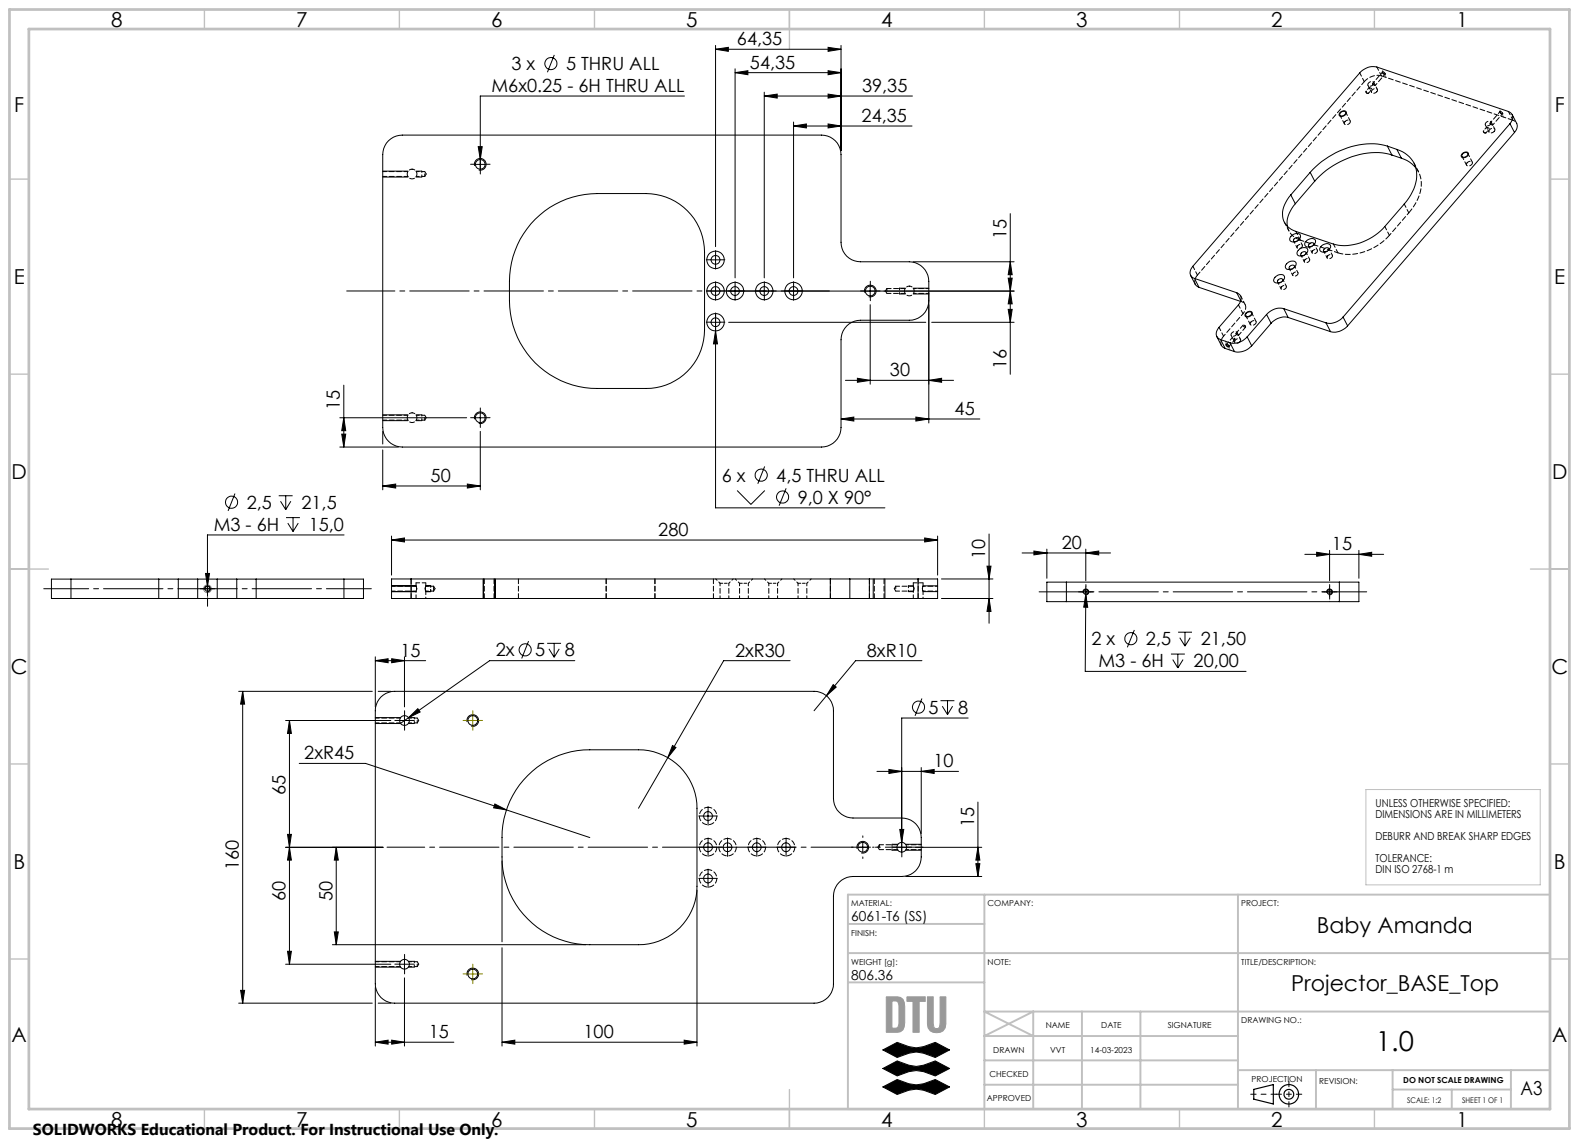
[picture p95: page 24]
4,5 THRU ALL; 5 THRU ALL; M6x0.25 - 6H THRU ALL; Projector_BASE_Top; PROJECT:; DRAWING NO.:; TITLE/DESCRIPTION:; VVT; NAME; DATE; SIGNATURE; NOTE:; COMPANY:; WEIGHT [g]:; MATERIAL:; FINISH:; SCALE: 1:2; SHEET 1 OF 1

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
